CircuitSetup/Remote/README.md

# Remote Control (Delorean Time Machine)

This [repository](https://github.com/CircuitSetup/Remote) _really_ holds the most current firmware for CircuitSetup's [Futaba remote control kit](https://circuitsetup.us/product/futaba-remote-stanley-display-wireless-control-kit/), meant mainly for use in combination with a CircuitSetup [Time Circuits Display](https://circuitsetup.us/product/complete-time-circuits-display-kit/) with a speedo connected to it. Of course, the Remote can also be used stand-alone.

See [here](FUTABA.md) for information on the hardware (parts, disassembly & building instructions).

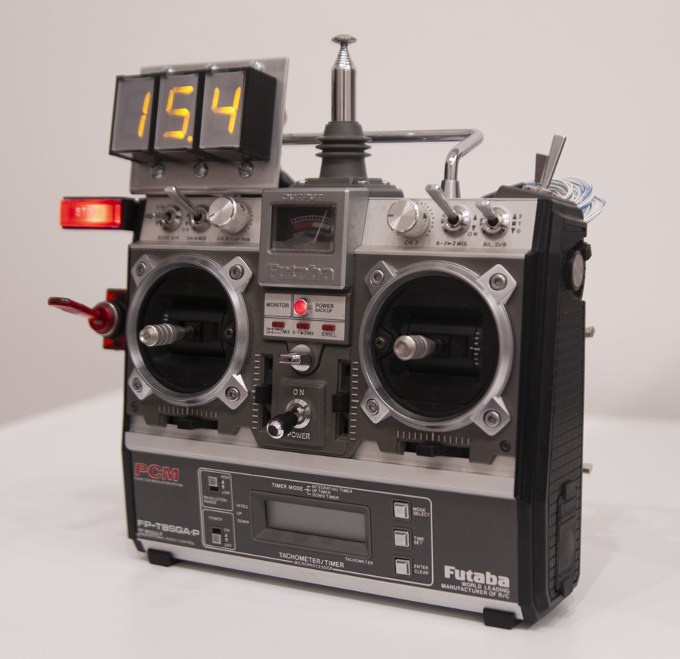
[picture p1: img/myfutaba1.jpg]
My Futaba1

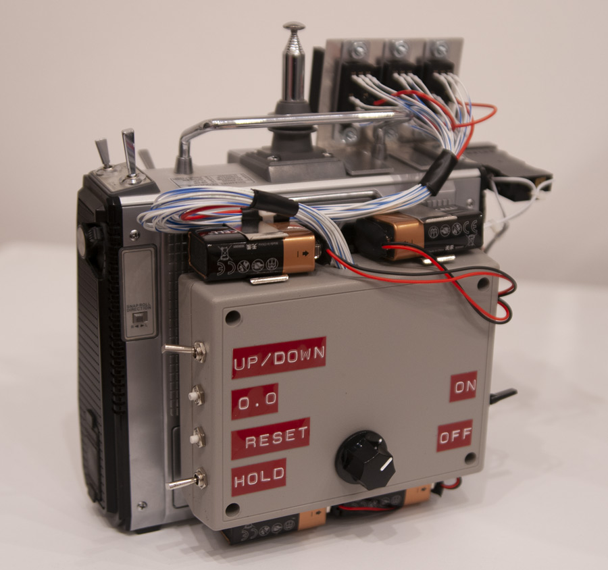
[picture p2: img/myfutaba2.jpg]
My Futaba2


| Watch the video (https://youtu.be/ADWcsmJ4gok) |
|:--:|
| Click to watch the video |

| Watch the video (https://youtu.be/vgmrB-Drxjg) |
|:--:|
| Click to watch the video |

See it controlling the lights and blinds through Home Assistant:

| Watch the video (https://youtu.be/SbuL2Bv5uqA) |
|:--:|
| Click to watch the video |

A video of an early proof-of-concept is [here](https://www.facebook.com/61553801874212/videos/1047035620236271/) (The hardware shown isn't even in prototype stage).

Firmware features:
- [Wireless communication](#connecting-a-time-circuits-display) with [Time Circuits Display](https://circuitsetup.us/product/complete-time-circuits-display-kit/); when (fake) powered up by "ON/OFF" switch, the Remote will take over speed control on the TCD-connected speedo. 
- Elevator stick on actual Futaba remote control used for throttle control, like in the movie. The throttle can increase or decrease speed, in five steps towards each direction. When the speed on the TCD's speedo reaches 88mph, a time travel is triggered.
- Optional [coasting](#-coasting-when-throttle-in-neutral), optional [auto-throttle](#-auto-throttle)
- controlling the Futaba's power LED and battery level meter (static display only, no actual battery level display)
- Movie-accurate "Stop" light and stop switch behavior
- Movie-accurate sound effects
- Eight optional "[User Buttons](#user-buttons)" for playback of user-provided sound effects and/or sending user-configurable [Home Assistant/MQTT](#home-assistant--mqtt) messages
- [Music player](#the-music-player): Play mp3 files located on an SD card, controlled by the _O.O_/_RESET_ buttons or [Time Circuits Display](https://circuitsetup.us/product/complete-time-circuits-display-kit/) keypad via BTTFN
- Advanced network-accessible [Config Portal](#the-config-portal) for setup (http://dtmremote.local)
- Optional [ELRS/CRSF operation](#elrscrsf-settings), with gimbal/switch routing, calibration, curves, travel limits, logical switches, mixes, and telemetry display
- Live ELRS transmitter/receiver controls, verified profile selection, and receiver assignment on the ELRS/CRSF page
- CRSF settings backup/restore, portable model files, and desktop conversion of supported transmitter model exports
- [Home Assistant](#home-assistant--mqtt) (MQTT) support
- Smart battery monitoring for certain LiPo batteries (requires Control Board 1.6M or >= 1.7)
- Built-in OTA installer for firmware updates and custom audio files
- &#128007; &#129370;

>This CircuitSetup fork includes optional [ELRS/CRSF support](#elrscrsf-settings) alongside the movie-prop functions. ELRS/CRSF requires a compatible control board and a firmware build with CRSF support enabled. The original movie-prop firmware is available from [upstream](https://remote.out-a-ti.me).

For information on updating the firmware of your Remote, see [here](#firmware-installation--firmware-update).

## Initial Configuration

**Some key features of your Remote require an SD card.** The first step is therefore to put a **good-quality** ("endurance", "industrial", "long life", ...) **and empty microSD card into the card slot**. The SD card must be inserted before powering up the Remote. It is not recognized if inserted while the Remote is running. Furthermore, do not remove the SD card while the Remote is powered.

>SD/SDHC/SDXC cards up to 32GB are supported. The card needs to be FAT32-formatted (not exFAT). Transcend, Sandisk Ultra and Industrial, Verbatim Premium and Samsung Pro Endurance SDHC cards usually work fine. Some SD cards might not be recognized due to off-specs initialization quirks. SDUC cards are not supported.

The second step is to establish access to the Remote's configuration website ("Config Portal") in order to configure your device:

- Power up your Remote and wait a few seconds.
- Connect your computer or handheld device to the WiFi network "REM-AP".
- Navigate your browser to http://dtmremote.local or http://192.168.4.1 to enter the Config Portal.

### Connecting to a WiFi network

Your Remote knows two ways of WiFi operation: Either it creates its own WiFi network or it connects to a pre-existing WiFi network.

As long as your Remote is unconfigured, it creates its own WiFi network named "REM-AP". This mode of operation is called "**Access point mode**" or **"AP-mode"**. In this mode, computers/handhelds can connect to your Remote in order to access the Config Portal, but ways of communication end right here. There is no inter-prop-communication ([BTTFN](#bttf-network-bttfn)) and no [HA/MQTT](#home-assistant--mqtt).

APmode

It is ok to leave it in AP-mode, predominantly if used stand-alone. To keep operating your Remote in AP-mode, simply _do not configure_ a WiFi network connection as described below.

<details>
<summary>More...</summary>

>Please do not leave computers/handhelds permanently connected to the Remote in AP-mode. These devices might think they are connected to the internet and therefore hammer your Remote with DNS and HTTP requests which might lead to disruptions.

>If you wish for your device to remain in AP-mode, please select a suitable WiFi channel on the Config Portal's "WiFi Configuration" page. See [here](#-wifi-channel).

> In AP-mode, the SID can switch off WiFi to save power. See [here](#wifi-power-saving-features).

</details>

#### Home setup with a pre-existing local WiFi network

In this case, you can connect your Remote to your home WiFi network. This allows for inter-prop-communication ([BTTFN](#bttf-network-bttfn)) and [HA/MQTT](#home-assistant--mqtt).

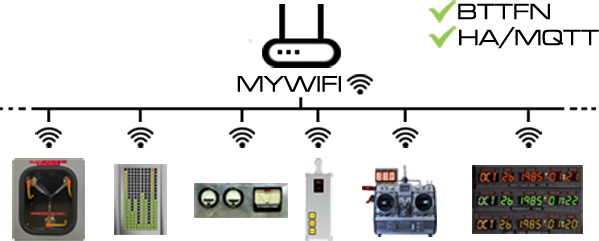
[picture p3: img/stamode-home.png]
STAmode-home


Click on "WiFi Configuration" and either select a network from the top of the page or enter a WiFi network name (SSID), and enter your WiFi password. After saving the WiFi network settings, your Remote reboots and tries to connect to your selected WiFi network. 

<details>
<summary>More...</summary>

>If there are several APs with identical SSID nearby, you can select a specific AP by its BSSID (AP's MAC address). You can either manually find out your AP's BSSID and enter it or have it filled out automatically: Click "Scan for networks", then "Show all". If you click on an AP, its BSSID will be copied into BSSID field in the form below. To see which AP is which, hover over the name to see its BSSID as a tooltip.
  
>Your Remote requests an IP address via DHCP, unless you entered valid data in the fields for static IP addresses (IP, gateway, netmask, DNS). If the device is inaccessible as a result of incorrect static IPs, 
>- power-down the device,
>- press the _Calibration_ button and keep it pressed,
>- power-up the device,
>- wait until the displays shows an animation,
>- press button _O.O_ twice within 10 seconds<!--the display will show "RST" after the second press-->,
>- wait until the display shows "RST",
>- then release the _Calibration_ button.
>
>This procedure causes static IP data to be deleted; the device will return to DHCP.

</details>

If the Remote fails to connect, it falls back to AP-mode. You can trigger another [connection attempt](#-attempt-re-connection-on-fake-power) by fake-powering it down and up.

#### Places without a WiFi network

In this case and with no [Time Circuits Display](https://circuitsetup.us/product/complete-time-circuits-display-kit/) at hand, keep your Remote operating in AP-mode.

If you have a TCD, you can connect your Remote to the TCD's own WiFi network: 

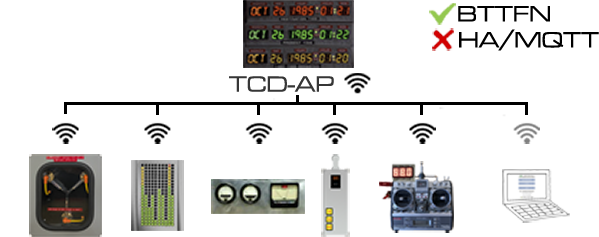
[picture p4: img/stamode-car.png]
STAmode-car


This setup is meant for cars, but suitable for any place with no WiFi network. See [here](#car-setup) for details.

After completing WiFi setup, your Remote is ready for use; you can also continue configuring it to your personal preferences through the Config Portal.

## The Config Portal

The "Config Portal" is the Remote's configuration web site. 

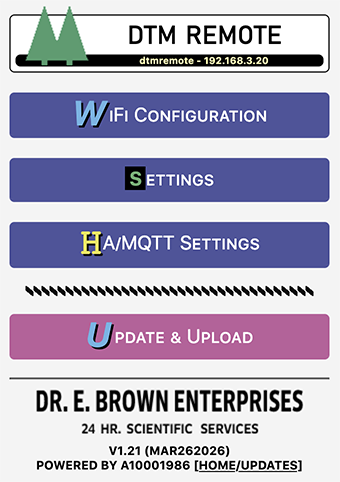
[picture p5: img/cpm.png]
The Config Portal
|  |
|:--:| 
| *The Config Portal's main page* |

It can be accessed as follows:

#### If Remote is in AP mode

- Connect your computer or handheld device to the WiFi network "REM-AP".
- Navigate your browser to http://dtmremote.local or http://192.168.4.1 to enter the Config Portal.
- (For proper operation, please disconnect your computer or handheld from REM-AP when you are done with configuring your Remote. These devices can cause high network traffic, resulting in severe performance penalties.)

#### If Remote is connected to a WiFi network

- Connect your handheld/computer to the same (WiFi) network to which your Remote is connected.
- Navigate your browser to http://dtmremote.local   <details><summary>More...</summary>

  >Accessing the Config Portal through this address requires the operating system of your handheld/computer to support Bonjour/mDNS: Windows 10 version TH2     (1511) [other sources say 1703] and later, Android 13 and later; MacOS and iOS since the dawn of time.

  >If connecting to http://dtmremote.local fails due to a name resolution error, you need to find out the Remote's IP address: Power up and fake-power-up the Remote and hold the _Calibration_ button for 2 seconds. The Remote will display its current IP address (a. - b. - c. - d). Then, on your handheld or computer, navigate to http://a.b.c.d (a.b.c.d being the IP address as displayed on the Remote) in order to enter the Config Portal.</details>

In the main menu, click on "Settings" to configure your Remote. 

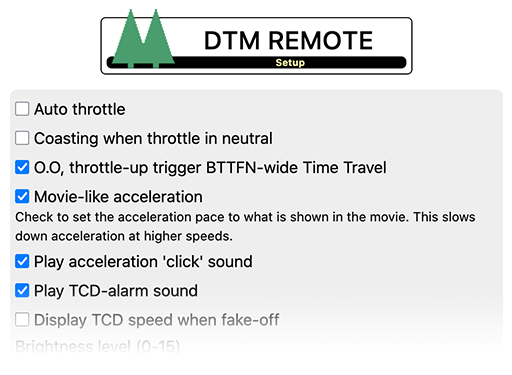
[picture p6: img/cps-frag.png]
| [](img/cp_setup.png) |
|:--:| 
| *Click for full screenshot* |

A full reference of the Config Portal is [here](#appendix-a-the-config-portal).

## Basic Operation

After [calibration](#calibration), your Remote is ready for use. 

If battery monitoring is available, the battery state (in percent; or "FUL") is shown briefly upon (real) power-on.

The Remote can be operated stand-alone, but is really meant to be (wirelessly) connected to a TCD.

After fake-power-on, the Remote's throttle controls the speed displayed on the TCD's Speedo.

For acceleration, there are two modes: Linear mode and "movie mode". In linear mode, acceleration is even over the entire range of 0 to 88mph. In "movie mode", the Remote (mostly) accelerates in the same pace as shown in the movie. In this mode, acceleration becomes slower at higher speeds. The mode can be selected in the Config Portal.

When the remote hits 88.0mph, the TCD triggers a BTFN-wide time travel; all connected props will play a synchronized time travel sequence. If operated stand-alone, a time travel sequence will be played on the Remote.

Auto-throttle: If enabled, acceleration will continue to run after briefly pushing up the throttle stick and releasing it into neutral. Acceleration is stopped when pulling down the throttle stick or when 88mph is reached.

Coasting: If this feature is enabled, the Remote will ever so slightly reduce the current speed when the throttle lever is in neutral. Like a car when you put the transmission in neutral or press the clutch.

All the operation modes described above can also be switched on/off through the [TCD keypad](#tcd-remote-command-reference) or [HA/MQTT](#control-the-remote-via-mqtt).

Buttons and switches:

### "ON/OFF": Fake power

The _ON/OFF_ switch turns the Remote on and off in a sense that it takes over speed control on the TCD when fake-powered on, and hands back speed control when fake-powered off.

_ON/OFF_ must be a maintained contact.

### "Stop"

The _Stop_ switch activates the brakes on your virtual Delorean; if the brakes are on, speed changes on the Remote are not followed by the TCD, instead the TCD will count speed down to 0. Upon releasing the brake, the virtual car accelerates up to the speed shown on the Remote, and will then follow its speed changes.

_Stop_ must be a maintained contact.

### Calibration

<table>
  <tr><td></td><td>Short press</td><td>Hold (2 secs)<br>(double-beep)</td><td>Hold (6 secs)<br>(triple-beep)</td></tr>
  <tr><td>Fake-power off</td><td>Calibrate, see below</td><td>Calibration, see below</td><td>Toggle <a href="#car-setup">Car mode</a></td></tr>
  <tr><td>Fake-power on</td><td>Reset speed to 0</td><td>Display IP address, battery state(*)</td><td>Toggle <a href="#car-setup">Car mode</a></td></tr>
</table>

(* Board version 1.6M or >= 1.7 required; LiPo battery must be properly connected to battery monitor input; battery charge percentage and time-to-empty shown alternately)

The throttle of the Remote needs calibration:

- Put the _ON/OFF_ switch in "OFF" position.
- Put the throttle lever in neutral (center) position, press the _Calibration_ button. The display will briefly show "CAL" to show acceptance.
- Hold the _Calibration_ button for >= 2 seconds until a double-beep is emitted, then release the button. Shortly after, "UP" will be displayed. Now push the throttle to the up-most position and press the _Calibration_ button. "DN" will be displayed.
- Pull the throttle lever to the bottom-most position and press the _Calibration_ button. The display will clear, calibration is finished.

If you change power-source (ie a new battery or power via USB to the ESP32), re-calibration is required.
 
The _Calibration_ button needs to be a momentary contact.

### Buttons "O.O" and "RESET"

When fake power is on:
<table>
  <tr><td></td><td>Short press</td><td>Long press</td></tr>
  <tr><td>Button <i>O.O</i></td><td>Prepare TT<br>or<br><a href="#the-music-player">Music Player</a>: Previous track<br>(depending on <a href="#-pressing-oo-when-fake-power-on">configuration</a>)</td><td><a href="#the-music-player">Music Player</a>: Play/Stop</td></tr>
  <tr><td>Button <i>RESET</i></td><td><a href="#the-music-player">Music Player</a>: Next track</td><td>Toggle Auto-Throttle<br>or<br><a href="#the-music-player">Music Player</a>: Toggle Shuffle<br>(depending on <a href="#-holding-reset-when-fake-power-on">configuration</a>)</td></tr>
</table>

When fake power is off, the buttons are used to set up audio volume and display brightness:
<table>
  <tr><td></td><td>Short press</td><td>Long press</td></tr>
  <tr><td>Button <i>O.O</i></td><td>Volume up</td><td>Brightness up<br>or<br>Take over TCD Fake-Power control<br>(depending on <a href="#-holding-ooreset-when-fake-power-off">configuration</a>)</td></tr>
  <tr><td>Button <i>RESET</i></td><td>Volume down</td><td>Brightness down<br>or<br>Release TCD Fake-Power control</td></tr>
</table>

[Here](https://github.com/realA10001986/Remote/blob/main/CheatSheet.pdf) is a cheat sheet for printing or screen-use.

### User Buttons

These buttons are entirely optional. You can install up to 8 buttons, they only serve the purpose of playing back user-provided sound effects and/or send user-configurable messages to an [MQTT](#home-assistant--mqtt) broker.

Sound playback is mapped as follows:

<table>
  <tr><td></td><td>Short press</td><td>Long press</td></tr>
  <tr><td>Button 1</td><td>Play "<a href="#additional-custom-sounds">key1.mp3</a>"</td><td>Play "<a href="#additional-custom-sounds">key1l.mp3</a>"</td></tr>
  <tr><td>Button 2</td><td>Play "<a href="#additional-custom-sounds">key2.mp3</a>"</td><td>Play "<a href="#additional-custom-sounds">key2l.mp3</a>"</td></tr>
  <tr><td>Button 3</td><td>Play "<a href="#additional-custom-sounds">key3.mp3</a>"</td><td>Play "<a href="#additional-custom-sounds">key3l.mp3</a>"</td></tr>
  <tr><td>Button 4</td><td>Play "<a href="#additional-custom-sounds">key4.mp3</a>"</td><td>Play "<a href="#additional-custom-sounds">key4l.mp3</a>"</td></tr>
  <tr><td>Button 5</td><td>Play "<a href="#additional-custom-sounds">key5.mp3</a>"</td><td>Play "<a href="#additional-custom-sounds">key5l.mp3</a>"</td></tr>
  <tr><td>Button 6</td><td>Play "<a href="#additional-custom-sounds">key6.mp3</a>"</td><td>Play "<a href="#additional-custom-sounds">key6l.mp3</a>"</td></tr>
  <tr><td>Button 7</td><td>Play "<a href="#additional-custom-sounds">key7.mp3</a>"</td><td>Play "<a href="#additional-custom-sounds">key7l.mp3</a>"</td></tr>
  <tr><td>Button 8</td><td>Play "<a href="#additional-custom-sounds">key8.mp3</a>"</td><td>Play "<a href="#additional-custom-sounds">key8l.mp3</a>"</td></tr>
</table>

If a "button" is configured as a maintained switch in the Config Portal, keyX will be played on every flip (ON->OFF, OFF->ON) by default. If the option **_Maintained: Audio on ON only_** is checked for a switch, keyX will only be played when the switch is brought into ON position. This is especially useful for three-position switches where each of the "ON" positions is wired to a different "Button" on the Control Board. Note that maintained switches cannot trigger play-back of keyXl.

If the button/switch is pressed/flipped while audio from a previous press/flip of the same button/switch is still playing, play-back will be stopped.
 
## Sound Customization

### Sound substitution

The Remote's built-in sound effects can be substituted by your own sound files stored on the SD card. These files will be played back directly from the SD card during operation, so the SD card has to remain in the slot.

Your replacements need to be put in the root (top-most) directory of the SD card, be in mp3 format (128kbps max) and named as follows:
- "poweron.mp3": Played when the Remote is (fake)-powered on.
- "brakeon.mp3": Played when the brake is switched on (= when the "Stop" light is switched on).
- "alarm.mp3". Played when the alarm sounds (triggered by a Time Circuits Display via BTTFN or MQTT);

### Additional Custom Sounds

The firmware supports some additional user-provided sound effects, which it will load from the SD card. If the respective file is present, it will be used. If that file is absent, no sound will be played.

- "poweroff.mp3": Played when the Remote is (fake)-powered off.
- "brakeoff.mp3": Played when the brake is switched off.
- "key1.mp3" - "key9.mp3": Will be played upon pressing the respective [button](#user-buttons) (except key9), and commands from the [TCD's keypad](#tcd-remote-command-reference) or [HA/MQTT](#control-the-remote-via-mqtt)
- "key1l.mp3" - "key9l.mp3": Will be played upon long-pressing the respective [button](#user-buttons) (except key9). Naturally, this only works for momentary buttons, not maintained switches. Those sounds also play on commands from the [TCD's keypad](#tcd-remote-command-reference) or [HA/MQTT](#control-the-remote-via-mqtt).

Those files are not provided here. You can use any mp3, with a bitrate of 128kpbs or less.

### Installing Custom & Replacement Audio Files

Replacements and custom sounds can either be uploaded through the Config Portal or copied to the SD card’s root folder using a computer.

Uploading through the Config Portal works exactly like [installing the sound-pack](#sound-pack-installation); on the main menu, click "Update & Upload". Afterwards choose one or more mp3 files to upload using the bottom file selector, and click "UPLOAD". The firmware will store the uploaded mp3 files on the SD card.

To delete a file from the SD card, upload a file whose name is prefixed with "delete-". For example: To delete "key3.mp3" from the SD card, upload a file named "delete-key3.mp3"; the file's contents does not matter, so it's easiest to use a newly created empty file. The firmware detects the "delete-" part and, instead of storing the uploaded file, it throws it away and deletes "key3.mp3" from the SD card.

For technical reasons, the Remote must reboot after mp3 files are uploaded in this way.

The maximum bitrate for mp3 files is 128kbps. 

The uploaded files are stored to the root folder of the SD card, so this way of uploading cannot be used to upload music files for the Music Player. 

## The Music Player

The firmware contains a simple music player to play mp3 files located on the SD card. 

> [!NOTE]
> The maximum mp3 bitrate is __128kpbs__. The free [Adapter&#10548;](https://macroplant.com/adapter/audio-converter) tool can re-encode your mp3 files in batches.

To be recognized, your mp3 files need to be organized in music folders named *music0* through *music9*. The folder number is 0 by default, i.e. the player starts searching for music in folder *music0*. The folder number can be changed in the Config Portal ("Settings") or through the TCD keypad (```705x```) or HA/MQTT (```MP_FOLDER_x```).

The names of the audio files must only consist of three-digit numbers, starting at 000.mp3, in consecutive order. No numbers should be left out. Each folder can hold up to 1000 files (000.mp3-999.mp3). 

Since manually renaming mp3 files is somewhat cumbersome, the firmware can do this for you: Just copy your files with their original filenames to a music folder of your choice; when selecting that folder, the files will be sorted alphabetically and renamed according to the 3-digit name scheme. (If you want your tracks in a specific order, you must rename them, for instance by inserting a letter or number at the start.) The renaming process can take a while (11 minutes for 1000 files in bad cases). Mac users are advised to delete the ._ files from the SD before putting it back into the Remote as this speeds up the process. While the renaming is in progress, the Remote's display shows how many files are still left to be processed.

To add files to a music folder later, just copy them to the folder and delete the corresponding cache file "musicXc" (X being the folder number) located in the top-most folder. That way that the firmware knows that something has changed and will re-examine the folder. 

To start and stop music playback, hold _O.O_ for 2 seconds. Briefly pressing _O.O_ jumps to the previous track, pressing _RESET_ to the next one. (The same can be achieved by entering codes on the TCD's keypad: ```7002``` = previous track, ```7005``` = play/stop, ```7008``` = next track).

By default, the tracks are played in order, starting at 000.mp3, followed by 001.mp3 and so on. Holding _RESET_ toggles Shuffle mode. Shuffle mode is saved and persistent across reboots.

See [here](#buttons-oo-and-reset) and [here](#tcd-remote-command-reference) for a list of controls of the music player.

While the music player is playing music, other sound effects might be disabled/muted. The TCD-triggered alarm will, if so configured, interrupt the music player.

## Battery Monitoring

If a suitable control board is in use, and battery warnings are enabled in the Config Portal, battery state can be monitored, and a warning is issued when the battery is low.

Monitoring works through the [_Calibration_ button](#calibration) and the TCD (```7091```/```7092```).

The "low battery" warning is given as follows:

- A sound is played once
- If the Futaba's battery level meter is connected and enabled, it is switched off (= it reads 0).
- If the Futaba's original power LED is connected and enabled, it blinks.
- If the power LED is disabled, depending on fake power, either "BAT" is displayed periodically or the display blinks periodically.

## Connecting a Time Circuits Display

The TCD communicates with the Remote wirelessly, via the built-in "**B**asic-**T**elematics-**T**ransmission-**F**ramework" (BTTFN) over WiFi. A wired connection is not supported.

The actual remote controlling is done wirelessly, and the TCD's keypad can be used to remote-control the Remote (to control the Music Player, for instance).

| Watch the video (https://youtu.be/u9oTVXUIOXA) |
|:--:|
| Click to watch the video |

BTTFN requires the props all to be connected to the same network, such as, for example, your home WiFi network, or the TCD acting as access point. BTTFN does not work over the Internet.

STAmode-home

<p>&nbsp;</p>

STAmode-car

<details>
<summary>More...</summary>

>The term "WiFi network" is used for both "WiFi network" and "ip subnet" here for simplicity reasons. However, for BTTFN communication, the devices must be on the same IP subnet, regardless of how they take part in it: They can be connected to different WiFi networks, if those WiFi networks are part of the same ip subnet.

</details>

To connect your Remote to the TCD, just enter the TCD's hostname - usually "timecircuits" - in the **_Hostname of TCD_** field in the Remote's Config Portal. On the TCD, no special configuration is required apart from permitting remote control through keypad command 993.
  
Afterwards, the Remote and the TCD can communicate wirelessly and 
- the TCD's speed control is done by the Remote,
- the Remote can switch [Fake-Power on the TCD](#controlling-tcd-fake-power),
- both play an alarm-sequence when the TCD's alarm occurs (if so configured),
- the Remote can be remote controlled through the TCD's keypad (command codes ```7xxx```; see below),
- the Remote can - while fake powered off - display the TCD's speed (eg from GPS).

### TCD remote command reference

<table>
   <tr><td align="center">Function</td><td align="center">Code on TCD</td></tr>
    <tr>
     <td align="left">Toggle "<a href="#-movie-like-acceleration">movie mode</a>"</td>
     <td align="left"<td><code>7060</code></td>
    </tr>
   <tr>
     <td align="left">Toggle <a href="#-display-tcd-speed-when-fake-off">display of TCD speed while off</a></td>
     <td align="left"<td><code>7061</code></td>
    </tr>
   <tr>
     <td align="left">Toggle <a href="#-auto-throttle">auto-throttle</a></td>
     <td align="left"<td><code>7062</code></td>
    </tr>
  <tr>
     <td align="left">Toggle <a href="#-coasting-when-throttle-in-neutral">coasting</a></td>
     <td align="left"<td><code>7063</code></td>
    </tr>
    <tr>
     <td align="left">Set volume level (00-20)</td>
     <td align="left"><code>7300</code> - <code>7320</code></td>
    </tr>
  <tr>
     <td align="left">Enable / disable click sound</td>
     <td align="left"><code>7350</code> / <code>7351</code></td>
    </tr>
    <tr>
     <td align="left">Set brightness level (00-15)</td>
     <td align="left"<td><code>7400</code> - <code>7415</code></td>
    </tr>
    <tr>
     <td align="left"><a href="#the-music-player">Music Player</a>: Play/Stop</td>
     <td align="left"><code>7005</code></td>
    </tr>
    <tr>
     <td align="left"><a href="#the-music-player">Music Player</a>: Previous track</td>
     <td align="left"><code>7002</code></td>
    </tr>
    <tr>
     <td align="left"><a href="#the-music-player">Music Player</a>: Next track</td>
     <td align="left"><code>7008</code></td>
    </tr>
    <tr>
     <td align="left"><a href="#the-music-player">Music Player</a>: Select music folder (0-9)</td>
     <td align="left"><code>7050</code> - <code>7059</code></td>
    </tr>
    <tr>
     <td align="left"><a href="#the-music-player">Music Player</a>: Shuffle off</td>
     <td align="left"><code>7222</code></td>
    </tr>
    <tr>
     <td align="left"><a href="#the-music-player">Music Player</a>: Shuffle on</td>
     <td align="left"><code>7555</code></td>
    </tr> 
    <tr>
     <td align="left"><a href="#the-music-player">Music Player</a>: Go to track 0</td>
     <td align="left"><code>7888</code></td>
    </tr>
    <tr>
     <td align="left"><a href="#the-music-player">Music Player</a>: Go to track xxx</td>
     <td align="left"><code>7888xxx</code></td>
    </tr>
    <tr>
     <td align="left">Play "<a href="#additional-custom-sounds">key1.mp3</a>"</td>
     <td align="left"><code>7501</code> / <code>7001</code></td>
    </tr>
    <tr>
     <td align="left">Play "<a href="#additional-custom-sounds">key2.mp3</a>"</td>
     <td align="left"><code>7502</code></td>
    </tr>
    <tr>
     <td align="left">Play "<a href="#additional-custom-sounds">key3.mp3</a>"</td>
     <td align="left"><code>7503</code> / <code>7003</code></td>
    </tr>
    <tr>
     <td align="left">Play "<a href="#additional-custom-sounds">key4.mp3</a>"</td>
     <td align="left"><code>7504</code> / <code>7004</code></td>
    </tr>
    <tr>
     <td align="left">Play "<a href="#additional-custom-sounds">key5.mp3</a>"</td>
     <td align="left"><code>7505</code></td>
    </tr>
    <tr>
     <td align="left">Play "<a href="#additional-custom-sounds">key6.mp3</a>"</td>
     <td align="left"><code>7506</code> / <code>7006</code></td>
    </tr>
    <tr>
     <td align="left">Play "<a href="#additional-custom-sounds">key7.mp3</a>"</td>
     <td align="left"><code>7507</code> / <code>7007</code></td>
    </tr>
    <tr>
     <td align="left">Play "<a href="#additional-custom-sounds">key8.mp3</a>"</td>
     <td align="left"><code>7508</code></td>
    </tr>
    <tr>
     <td align="left">Play "<a href="#additional-custom-sounds">key9.mp3</a>"</td>
     <td align="left"><code>7509</code> / <code>7009</code></td>
    </tr>
    <tr>
     <td align="left">Play "<a href="#additional-custom-sounds">keyXl.mp3</a>" (X=1-9)</td>
     <td align="left"><code>7511</code> - <code>7519</code></td>
    </tr>
    <tr>
     <td align="left">Display current IP address</td>
     <td align="left"><code>7090</code></td>
    </tr>   
  <tr>
     <td align="left">Display battery charge percentage<sup>1</sup></td>
     <td align="left"><code>7091</code></td>
    </tr>   
  <tr>
     <td align="left">Display battery "Time to empty"<sup>1</sup></td>
     <td align="left"><code>7092</code></td>
    </tr>   
  <tr>
     <td align="left">Display battery voltage<sup>1</sup></td>
     <td align="left"><code>7093</code></td>
    </tr> 
   <tr>
     <td align="left">Toggle <a href="#controlling-tcd-fake-power">Fake-Power control</a></td>
     <td align="left"><code>7096</code></td>
    </tr>
    <tr>
     <td align="left">Disable <a href="#car-setup">Car mode</a><sup>2</sup></td>
     <td align="left"><code>7990</code></td>
    </tr>
    <tr>
     <td align="left">Enable <a href="#car-setup">Car mode</a><sup>2</sup></td>
     <td align="left"><code>7991</code></td>
    </tr>
    <tr>
     <td align="left">Reboot the device<sup>2</sup></td>
     <td align="left"><code>7064738</code></td>
    </tr>
    <tr>
     <td align="left">Toggle firmware update signals at power-up</td>
     <td align="left"><code>7053281</code></td>
    </tr>
</table>

1: Board 1.6M or >= 1.7 required; if LiPo battery is properly connected to battery monitor.<br>
2: Not supported through HA/MQTT [_INJECT_](#the-inject_x-command) command

[Here](CheatSheet.pdf) is a cheat sheet for printing or screen-use.

### Controlling TCD Fake-Power

The Remote can, if so configured, control Fake-Power of a wirelessly connected Time Circuits Display.

By holding _O.O_ when Fake-Power on the Remote is off, the Remote takes over control of Fake-Power on the TCD. The same can be achieved by entering ```7096``` on the TCD keypad.

From now on, whenever you flip the Fake-Power switch on the Remote, the TCD will follow. 

To release Fake-Power control, hold _RESET_ when Fake-Power on the Remote is off.

If the option "Fake-Power controls TCD Fake-Power" is checked in the Config Portal, the Remote will take over Fake-Power control from the TCD at its startup, ie there is no need to initially press _O.O_.

Remarks:
- Buttons _O.O_/_RESET_ need to configured for this function, see [here](#-holding-ooreset-when-fake-power-off).
- The Remote has the highest Fake-Power priority. The TCD's TFC switch and Fake-Power control through HA/MQTT have lower priority; state changes are tracked but do not become effective until the Remote releases Fake-Power control.

## Home Assistant / MQTT

By means of MQTT, the Remote can
- send pre-programmed messages to pre-programmed topics on User button/switch activation, and
- be remote controlled through commands sent to **bttf/remote/cmd**.

The Remote supports MQTT protocol versions 3.1.1 and 5.0.

### Send messages through User Buttons

In the Config Portal, you can configure MQTT topics and messages for "on" and/or "off" for each of the eight User buttons/switches. This allows for arbitrary functions in your Home Assistant/MQTT realm. You could switch HA-integrated lights on or off or send ```TIMETRAVEL``` to your [Time Circuits Display](https://tcd.out-a-ti.me) (bttf/tcd/cmd) or ```REFILL``` to your [Dash Gauges](https://dg.out-a-ti.me) (bttf/dg/cmd).

The "on" message will be sent when a button has been pressed, the "off" message when it has been released. In case of a button being configured as a maintained switch in the Config Portal, the "on" message will be sent when the switch is closed, the "off" message when it is opened.

For a video how this works, see [here](https://youtu.be/SbuL2Bv5uqA?si=R54H7ocUr2Q1ZDAc).

### Control the Remote via MQTT

The Remote can be controlled through messages sent to topic **bttf/remote/cmd**. Supported commands are
- ```AUTOTHROTTLE_ON```, ```AUTOTHROTTLE_OFF```: Enable/disable [auto-throttle](#-auto-throttle)
- ```COASTING_ON```, ```COASTING_OFF```: Enable/disable [coasting](#-coasting-when-throttle-in-neutral)
- ```MOVIEACCEL_ON```, ```MOVIEACCEL_OFF```: Switch between movie and linear [acceleration](#-movie-like-acceleration)
- ```DISPTCDSPD_ON```, ```DISPTCDSPD_OFF```: Enable/disable [speed display while fake-off](#-display-tcd-speed-when-fake-off)
- ```MP_PLAY```: Starts the [Music Player](#the-music-player)
- ```MP_STOP```: Stops the [Music Player](#the-music-player)
- ```MP_NEXT```: Jump to next track
- ```MP_PREV```: Jump to previous track
- ```MP_SHUFFLE_ON```: Enables shuffle mode in [Music Player](#the-music-player)
- ```MP_SHUFFLE_OFF```: Disables shuffle mode in [Music Player](#the-music-player)
- ```MP_FOLDER_x```: x being 0-9, set folder number for [Music Player](#the-music-player)
- ```VOLUME_UP```, ```VOLUME_DOWN```: Increase/decrease volume by a notch
- ```VOLUME_SET_x```: Set volume to x% (x=0-100)
- ```PLAYKEY_x```: Play keyX.mp3 (from SD card), X being in the range from 1 to 9.
- ```PLAYKEY_xL```: Play keyXl.mp3 (from SD card), X being in the range from 1 to 9.
- ```STOPKEY```: Stop playback of keyX file. Does nothing if no keyX file is currently played back.
- ```INJECT_x```: See immediately below.

#### The INJECT_x command

This command allows remote control of the Remote through HA/MQTT in the same way as through the TCD keypad by injecting commands in the Remote's command queue (hence the name). Commands are listed [here](#tcd-remote-command-reference); nearly all are supported. 

To toggle movie/linear mode (```7060```), issue the following command: ```INJECT_7060```

To play "key2.mp3" (```7502```), issue ```INJECT_7502```

To select the 'music1' folder (```7051```), issue ```INJECT_7051```

### Setup

MQTT requires a "broker" such as [mosquitto](https://mosquitto.org/), [Cassandana](https://github.com/mtsoleimani/cassandana), [RabbitMQ](https://www.rabbitmq.com/), [Ejjaberd](https://www.ejabberd.im/), [HiveMQ](https://www.hivemq.com/) or [EMQX](https://www.emqx.com/), to name a few. For proper operation with low latency, running the broker on your local network is recommended.

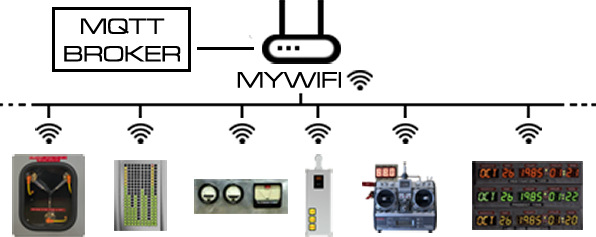
[picture p7: img/stamode-mqtt.png]
STAmode-mqtt


The broker's address needs to be configured in the Config Portal. It can be specified by either domain or IP (IP preferred). The default port is 1883. If a different port is to be used, append a ":" followed by the port number to the domain/IP, such as "192.168.1.5:1884". 

If your broker supports protocol version 3.1.1, stick with 3.1.1. Version 5.0 has no advantages, but more overhead.

If your broker does not allow anonymous logins, a username and password can be specified.

Limitations: TLS/SSL not supported; ".local" domains (MDNS, Bonjour) not supported; the machine running the broker must respond to PING (ICMP) echo requests. MQTT is disabled when the Remote is operated in AP-mode or when connected to the TCD run in AP-Mode (TCD-AP).

## Car Setup

If your [Time Circuits Display](https://tcd.out-a-ti.me/) is mounted in a car or other places without a local WiFi network, the following network configuration is recommended:

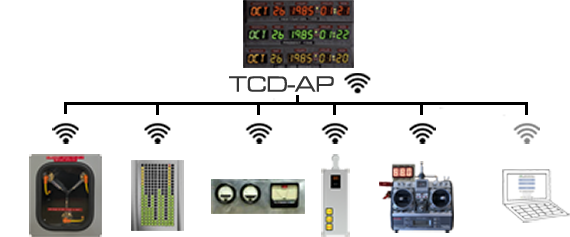
[picture p8: img/stamode-car2.png]
STAmode-car


This configuration can easily be achieved by putting both the TCD and the Remote in *Car Mode*:

#### TCD

- Set **_Power save timer_** to 0 (zero) in the "AP-mode settings" section on the *WiFi Configuration* page
- Put your TCD in [*Car Mode*](https://tcd.out-a-ti.me/#car-mode) by issuing keypad command ```991```.

#### Remote

One-time configuration steps:
- Enter the Config Portal on the Remote, click on *Settings* and check that the hostname of the TCD (usually "timecircuits") is present in the  **_Hostname of TCD_** under *Wireless communication (BTTF-Network)* settings.
- Furthermore, on the *WiFi Configuration* page, check that the TCD's WiFi network name (SSID; usually "TCD-AP") and password (if the TCD is configured with a password) are present under *Car mode settings*.

If everything is in place, you can enable Car mode on the Remote by holding the _Calibration_ button for 6 seconds (until a triple-beep is emitted). The Remote will reboot and attempt to connect to the TCD's AP.

You can switch between your "normal" (home, iPhone, ..) WiFi connection and Car mode by holding the _Calibration_ button for 6 seconds. This works in both fake-power on and off states.

To access the Remote's Config Portal in Car mode, connect your handheld or computer to the TCD's WiFi network ("TCD-AP"), and direct your browser to http://dtmremote.local.

  ><details><summary>If that fails...</summary>
  >If connecting to http://dtmremote.local fails due to a name resolution error, go to the TCD's keypad menu, navigate to "BTTFN CLIENTS", and look for the Remote's IP address there; then direct your browser to that IP by using the URL http://a.b.c.d (a-d being the IP address displayed on the TCD display)</details>

## WiFi Power Saving Features

In AP-mode (ie when the device acts as an access point), WiFi can [only be used for the Config Portal](#connecting-to-a-wifi-network). Since changing settings in the Config Portal isn't something done on a regular basis, the Remote can switch off WiFi in AP-mode after a configurable period of time in order to save battery power.

To enable this power-saving feature, navigate to the "WiFi Configuration" page and enter into the field **_Power save timer_** in the "Settings for AP-mode" section the number of minutes that need to elapse from (real-)power-on until WiFi is supposed to be switched off. Anything between 10 and 99 minutes is allowed. Entering 0 disables this feature.

After WiFi has been switched off due to timer expiration, and the option **_Re-enable WiFi on Fake Power_** is checked, WiFi will be re-enabled on fake-power-up, and the timer is restarted (ie WiFi is again switched off after timer expiration).

>If the Remote ended up in AP-mode because the configured WiFi network wasn't reachable on (real-)power up, and the option **_Attempt re-connection on Fake Power_** is checked, the Remote will attempt to connect to the WiFi network on fake-power-on (and, as usual, fall back to AP-mode on failure; the timer is, of course, restarted in that case).

## Firmware Installation / Firmware Update

The firmware consists of two parts: The main firmware, and a sound-pack.

First, download main firmware and sound-pack. Both files are in every [Release package](https://github.com/realA10001986/Remote/releases/latest), and named
- "**remote-A10001986-Vx.xx.bin**" for A10001986 releases, "**Remote_vX.YY.bin**" for CircuitSetup releases
- "**sound-pack-rmXX.zip**" for A10001986 releases, "**REMA.bin**" for CircuitSetup releases.

### Main firmware

To update the main firmware of your Remote, 
- enter the [Config Portal](#the-config-portal),
- click on "Update & Upload",
- select the downloaded main firmware file in the _top_ file selector, and
- click on *Update*.
  
<details>
<summary>Installing on a fresh ESP32...</summary>
If you are using a fresh ESP32, please go <a href="https://install.out-a-ti.me">here</a> and follow the instructions, or - if you are a nerd and want to deal with source code, compilers'n'stuff - see <a href="https://github.com/realA10001986/Remote/blob/main/remote-A10001986/remote-A10001986.ino">remote-A10001986.ino</a> for detailed build and upload information.
</details>

### Sound-pack installation

After updating the main firmware, there will be a notification on the Config Portal (and the Remote will briefly display "INS"-"SND"-"PCK" at startup) when/if the sound-pack also needs to be updated. 

_Installing the sound-pack requires an [SD card](#initial-configuration)._

To update the sound-pack of your Remote, 
- (if the sound-pack is a zip file, extract it. It contains one file named REMA.bin)
- enter the [Config Portal](#the-config-portal),
- click on "Update & Upload",
- select the REMA.bin file in the _bottom_ file selector, and
- click on *Upload*. 

<details>
<summary>Alternative way</summary>
<br>
Alternatively, you can install the sound-pack the following way:
<ul>
<li>Using a computer, copy "REMA.bin" to the root directory of a FAT32 formatted SD card;</li>
<li>power down the Remote,</li>
<li>insert this SD card into the slot and</li>
<li>power up the Remote; the sound-pack will be installed automatically.</li>
</ul>
</details>

<!--
## Factory Reset

To reset your Remote to factory default settings, 
- power-down the device,
- press the _Calibration_ button and keep it pressed,
- power-up the device,
- wait until the display shows an animation,
- press the _RESET_ button five times within 10 seconds (the display will show "FAC" after the fifth press),
- then release the _Calibration_ button.

This clears all settings to their defaults except
- battery settings,
- Futaba switch type settings.

Since any configured WiFi connection is deleted as well, the Remote will reboot in AP-Mode.

-->

---

## Appendix A: The Config Portal

### Main page

##### &#9193; WiFi Configuration

This leads to the [WiFi configuration page](#wifi-configuration)

##### &#9193; Settings

This leads to the [Settings page](#settings).

##### &#9193; HA/MQTT Settings

This leads to the [HomeAssistant/MQTT Settings page](#hamqtt-settings).

##### &#9193; ELRS/CRSF Settings

This leads to the [ELRS/CRSF Settings page](#elrscrsf-settings), including live radio controls and CRSF settings files. It is available on compatible hardware with a CRSF-enabled build.

##### &#9193; Update & Upload

This leads to the firmware update and audio upload page.

See [here](#firmware-installation--firmware-update) for firmware update instructions.

This page is also for uploading [custom or replacement sound files](#installing-custom--replacement-audio-files) to the SD card:
- Select one or more mp3 file(s) in the _bottom_ file selector (max 16 files at a time) and
- click *Upload*.

---

### WiFi Configuration

Through this page you can either connect your Remote to your local WiFi network or configure AP mode. 

#### <ins>Connecting to an existing WiFi network</ins>

To connect your Remote to your WiFi network, all you need to do is either to click on one of the networks listed at the top or to enter a __Network name (SSID)__, and optionally a __password__ (WPAx). If there is no list displayed, click on "Scan for Networks".

>By default, the Remote requests an IP address via DHCP. However, you can also configure a static IP for the Remote by entering the IP, netmask, gateway and DNS server. All four fields must be filled for a valid static IP configuration. If you want to stick to DHCP, leave those four fields empty.

If there are several APs with identical SSID nearby, the Remote will connect to the first one found, which might not be the one with the strongest signal. It is therefore recommended to select the nearest/strongest AP by its BSSID (AP's MAC address, a unique identifier for a specific AP). You can either manually find out your AP's BSSID and enter it or have it filled out automatically: Click "Scan for networks", then "Show all". If you click on an AP, its BSSID will be copied into BSSID field in the form below. To see which AP is which, hover over the name to see its BSSID as a tooltip.

If the WiFi network the Remote is supposed to connect to wasn't reachable when the Remote was powered up, it will run in AP mode. You can trigger a re-connection attempt by fake-powering it down and up. This technique is also used for WiFi power-saving in AP-mode, see [here](#wifi-power-saving-features).

##### &#9193; Forget Saved WiFi Network

Clicking this button (and selecting "yes" in the confirmation dialog) deletes the currently saved WiFi network (SSID and password as well as static IP data) and reboots the device; it will restart in "access point" (AP) mode. See [here](#connecting-to-a-wifi-network).

##### &#9193; Car mode settings

In Car mode, the device connects to the TCD-AP as configured here instead of the WiFi network configured above. 

Enter your TCD's network name (usually "TCD-AP") in **_Network name (SSID) of TCD-AP_** and the TCD's AP password (if configured on the TCD) in **_Password for TCD-AP_**. 

The **_TCD-AP BSSID_** field is optional for you to fill out. The TCD displays its BSSID (unique access point identifier) on its *WiFi Configuration* page, so you could copy it into this field on your Remote. If the _TCD-AP BSSID_ field is left empty, it will be filled out automatically upon the first successful connection to your TCD in Car Mode. This pairs your Remote to your TCD and avoids connecting to other people's TCDs at meet-ups with other cars nearby.
> If you ever need to connect your Remote to a different TCD (or, for instance, swap out your TCD's circuit board), this field needs to be cleared in order to pair your Remote to the new TCD. Note that if the Remote fails to connect to a BSSID-identified TCD, it will boot into [AP-Mode](#connecting-to-a-wifi-network) ("REM-AP").

If you want to enter Car mode immediately after saving your settings, check **_Enable car mode now_**. You can also later toggle between Car mode and normal WiFi connection by holding the _Calibration_ button for 6 seconds (until a triple-beep is emitted).

##### &#9193; Hostname

The device's hostname in the WiFi network. Defaults to 'dtmremote'. This also is the domain name at which the Config Portal is accessible from a browser in the same local network. The URL of the Config Portal then is http://<i>hostname</i>.local (the default is http://dtmremote.local)

If you have more than one Remote in your local network, please give them unique hostnames.

_This setting applies to both AP-mode and when your Remote is connected to a WiFi network._ 

##### &#9193; WiFi connection attempts

Number of times the firmware tries to reconnect to a WiFi network, before falling back to AP-mode. See [here](#connecting-to-a-wifi-network)

##### &#9193; Attempt re-connection on Fake Power

If the configured WiFi network wasn't reachable during power-up (and the Remote, as a result, fell back to AP-mode), and this option is checked, the Remote will re-try to connect to the configured WiFi network upon Fake-Power-On. If this option is unchecked, no connection attempts are made, the Remote will remain in AP-mode until (real-)powered-down.

#### <ins>Settings for AP-mode</ins>

##### &#9193; Network name (SSID) appendix

By default, when your Remote creates a WiFi network of its own ("AP-mode"), this network is named "REM-AP". In case you have multiple Remotes in your vicinity, you can have a string appended to create a unique network name. If you, for instance, enter "-ABC" here, the WiFi network name will be "REM-AP-ABC". Characters A-Z, a-z, 0-9 and - are allowed.

##### &#9193; Password

By default, and if this field is empty, the Remote's own WiFi network ("REM-AP") will be unprotected. If you want to protect your access point, enter your password here. It needs to be 8 characters in length and only characters A-Z, a-z, 0-9 and - are allowed.

If you forget this password and are thereby locked out of your Remote, 
- power-down the device,
- press the _Calibration_ button and keep it pressed,
- power-up the device,
- wait until the display shows an animation,
- press button _O.O_ twice within 10 seconds<!-- (the display will show "RST" after the second press) -->,
- wait until the display shows "RST",
- then release the _Calibration_ button.

The Remote will boot and start the access point - this once - without a password, thereby giving you an opportunity to connect without a password and to either look up or change said password. When you reboot or power-cycle the Remote, REM-AP will be password protected again.

##### &#9193; WiFi channel

Here you can select one out of 11 channels or have the Remote choose a random channel for you. The default channel is 1. Preferred are channels 1, 6 and 11.

WiFi channel selection is key for a trouble-free operation. Disturbed WiFi communication can lead to disrupted sequences, packet loss, hanging or freezing props, and other problems. A good article on WiFi channel selection is [here](https://community.ui.com/questions/Choosing-the-right-Wifi-Channel-on-2-4Ghz-Why-Conventional-Wisdom-is-Wrong/ea2ffae0-8028-45fb-8fbf-60569c6d026d).

If a WiFi Scan was done (which can be triggered by clicking "Scan for Networks"), 

- a list of networks is displayed at the top of the page; click "Show All" to list all networks including their channel;
- a "proposed channel" is displayed near the "WiFi channel" drop-down, based on a rather simple heuristic. The banner is green when a channel is excellent, grey when it is impeded by overlapping channels, and when that banner is red operation in AP mode is not recommended due to channels all being used.

The channel proposition is based on all WiFi networks found; it does not take non-WiFi equipment (baby monitors, cordless phones, Bluetooth devices, microwave ovens, etc) into account. 

##### &#9193; Power save timer

See [here](#wifi-power-saving-features).

##### &#9193; Re-enable WiFi on Fake Power

If a power save timer is configured and has expired, and this option is checked, the Remote will re-enable WiFi upon Fake-Power-On. If this option is unchecked, WiFi will **not** be re-enabled, it will stay off until (real-)power down. See also [here](#wifi-power-saving-features).

---

### Settings

#### <ins>Basic settings</ins>

##### &#9193; Auto throttle

If this is checked, acceleration is, after being started by pushing the throttle stick up, continued even if the stick is released into neutral. Acceleration is stopped when pulling down the throttle stick or when 88mph is reached.

This setting can quickly be toggled by holding the _RESET_ button, if [so configured](#-holding-reset-when-fake-power-on).

##### &#9193; Coasting when throttle in neutral

Normally, when this is unchecked, keeping the throttle in neutral (center) position holds the current speed. If this option is checked, speed will slowly decrease in neutral, just like a car when the kludge is held down or the gear is in neutral.

##### &#9193; Movie-like acceleration

The Remote knows to modes of acceleration: "Movie mode" and "linear".

In movie mode, acceleration changes with speed. At lower speeds, it is faster, and will gradually become slower as speed increases. The pace matches the movie mostly; unfortunately, the remote is only shown for a very few seconds and timing is inconsistent (to say the least), so some interpolations were required.

In linear mode, the acceleration curve is a straight line, ie the time between each mph is the same.

##### &#9193; Play throttle-up sound on throttle-up

This option selects whether the "throttle up" sound is played only at speed 0, or whenever the throttle lever is moved up from neutral, regardless of current speed.

##### &#9193; Play acceleration 'click' sound

Check this to play a click sound for each "mph" while accelerating. Uncheck to stay mute. Note that the click is only played when accelerating, not with reducing speed.

##### &#9193; Play TCD-alarm sounds

If a TCD is connected via BTTFN or MQTT, the Remote visually signals when the TCD's alarm sounds. If you want to play an alarm sound, check this option.

##### &#9193; Display TCD speed when fake-off

When this is checked, the Remote (when fake-powered off) shows whatever the TCD displays on its speedo. For instance, if your TCD is in a car along with a GPS-equipped speedo, the Remote can show the GPS speed.

#### <ins>Music Player settings</ins>

##### &#9193; Music folder

Selects the current music folder, can be 0 through 9. 

This can also be set/changed through a TCD keypad via BTTFN (```7050``` - ```7059```). Such a change will be saved immediately.

#### <ins>Settings for BTTFN communication</ins>

##### &#9193; Hostname of TCD

To connect your Remote to a Time Circuits Display wirelessly ("BTTF-Network"), enter the TCD's hostname - usually 'timecircuits' - here. Although specifying the TCD's IP address is supported as well, the hostname is preferred because it makes your setup independent of the network environment.

##### &#9193; Remote Fake-Power controls TCD Fake-Power

This selects the power-up behavior of Fake-Power control over the TCD.

If this option is checked, the Remote takes over Fake-Power control from the TCD when booting. If the TCD is powered-up after the Remote, it will recognize the Remote's state and stay silent and dark until the Remote is fake-powered up.

If this option is unchecked, you need to hold _O.O_ to gain Fake-Power control on the TCD, as described [here](#controlling-tcd-fake-power).

##### &#9193; Button to refill Plutonium

Here you can select a user button/switch which, when activated, sends a ```REFILL``` command to the [Dash Gauges](https://dg.out-a-ti.me) through the TCD. This is useful for quickly silencing the Dash Gauges after a Time Travel.

#### <ins>Other settings</ins>

##### &#9193; Save secondary settings on SD

_Please leave this option checked. It is safe to have this option checked even with no SD card present._

If this is checked, some settings are stored on the SD card. This helps to minimize write operations to the internal flash memory and to prolong the lifetime of your Remote. Apart from Flash Wear, there is another reason for using an SD card for settings: The Remote needs to save data from time to time. Writing data to internal flash memory can cause delays of up to 1.5 seconds, which interrupt sound playback and have other undesired effects.

If you want copy settings from one SD card to another, do as follows:
- With the old SD card still in the slot, enter the Config Portal, turn off _Save secondary settings on SD_, and click "SAVE".
- After the Remote has rebooted, power down, and swap the SD card for your new one.
- Power-up the Remote, enter the Config Portal, re-enable _Save secondary settings on SD_, and click "SAVE".

#### <ins>Button assignment settings</ins>

##### &#9193; Holding O.O/RESET when Fake-Power off

This selects what happens when you hold the _O.O_ or _RESET_ button for 2 seconds when Fake-Power is off:

- _adjusts display brightness_: _O.O_ increases display brightness, _RESET_ decreases it.
- _takes/releases control of TCD Fake Power_: _O.O_ takes over [TCD Fake-Power control](#controlling-tcd-fake-power), _RESET_ releases it.

##### &#9193; Pressing O.O when Fake-Power on

This selects what happens when you (briefly) press the _O.O_ button when Fake-Power is on:

- _Plays previous track in Music Player_: As it says, as part of Music Player control, _O.O_ jumps to the previous track.
- _Makes throttle-up trigger a time travel_: Briefly pressing _O.O_ prepares a Time Travel, which is then triggered when pushing the throttle stick upward.

##### &#9193; Holding RESET when Fake-Power on

This selects what happens when you hold the _RESET_ button when Fake-Power is on:

- _toggles shuffle in Music Player_: As it says, as part of Music Player control, it toggles the shuffle setting.
- _toggles auto-throttle_: Holding _RESET_ toggles the [auto-throttle](#-auto-throttle) setting.

#### <ins>Hardware configuration settings</ins>

##### &#9193; Button x is maintained

You might want use one or more switches of the Futaba remote for sound effects and/or MQTT messages. If that switch is a maintained contact, check this option for the respective "button" number. Leave unchecked when using a momentary button.

##### &#9193; Maintained: Play audio on ON only

If this is unchecked, audio is played on every flip (OFF->ON, ON->OFF) of the maintained switch. If checked, keyX is only played when the switch is brought into "on" position. Check this if using three-position switches where both ON positions are wired to different "Buttons" on the Control Board.

##### &#9193; Use Futaba Power LED

This setting is for using the Futaba's original power LED. If this LED isn't connected to the control board, this setting has no effect.

If unchecked, the power LED stays dark, which is the default. If checked, the power LED lights up on either real power or fake power.

##### &#9193; Power LED on fake power

If unchecked, the power LED lights up on real power. If checked, it does so on fake power.

##### &#9193; Use Futaba Battery Level Meter

This setting is for using the Futaba's original battery level meter. If this meter isn't connected to the control board, this setting has no effect.

If unchecked, the level meter stays at zero, which is the default. If checked, the level meter shows a fictitious battery level of around 75%.

Please note that the meter does not show actual battery level; the built-in battery monitor, as described below, only works through the Stanley display.

##### &#9193; Level Meter on fake power

If unchecked, the level meter comes to life on real power. If checked, it does so on fake power.

#### <ins>Battery monitoring</ins>

##### &#9193; Battery monitoring/warnings

Enable or disable battery monitoring and respective warnings. Battery monitoring requires using Control Board versions 1.6M or >= 1.7, plus a properly connected LiPo battery.

If the battery level is lower than 8 percent, a warning is issued. The way it is given depends on hardware and software settings, see [here](#battery-monitoring).

##### &#9193; Battery type

Battery monitoring only works reliably with the LiPo batteries listed. Select the type you are using.

The battery CircuitSetup supplies as part of their kit is of the 3.7/4.2V type.

##### &#9193; Capacity per cell (1000-6000)

Battery monitoring requires knowledge about the cell capacity. Note that the capacity _per cell_ is required to be entered. Most batteries consist of two or more cells; in that case divide the nominal capacity by the number of cells and enter the number here.

The battery CircuitSetup supplies as part of their kit is a dual-cell 5000mAh LiPo battery. The value to enter here is therefore 2500.

---

### ELRS/CRSF Settings

In CircuitSetup's fork, this page is available on compatible control boards when the firmware is built with ELRS/CRSF support. Local input/model settings, live radio controls, and file backup/import are on the same page, using the existing Config Portal layout.

The four gimbals are calibrated and shaped before CRSF transmission: low is `1000`, center is `1500`, and high is `2000` in RC-equivalent microseconds before conversion to CRSF wire ticks. The portal shows filtered ADC readings and lets you capture low, center, and high calibration points. Gimbals and switches can each use CH1-CH16 or None; the available receiver channels depend on the module's RF mode.

Use **Save** at the bottom of the complete page for local model, input, mode, and display changes. Saving restarts the Remote. Live device operations use their own confirmation and readback controls.

##### &#9193; Operation mode

Choose one of three modes, then save and restart:

- **Legacy**: normal prop controls, simulated speed/display, sound effects, and the configured MQTT/BTTFN behavior. No CRSF channel transmission.
- **ELRS/CRSF**: all four gimbals and twelve switch inputs transmit on their assigned CRSF channels, and the display shows radio telemetry. Check **Also trigger Settings action** beside individual switches to additionally run their existing Settings-page behavior. For O.O configured for Time Travel, an enabled checkbox sends the request directly; it does not wait for the prop throttle.
- **Prop controls + ELRS/CRSF**: normal prop controls and the prop speed display run together with all mapped CRSF channels. All prop switches and Settings actions are active; the individual checkboxes do not restrict them. MQTT and BTTFN work as configured under the usual WiFi/network requirements. O.O and Time Travel retain normal prop behavior, including the throttle-up condition.

To use the gimbal as a prop speed control with optional radio output, choose **Prop controls + ELRS/CRSF**. The physical **Throttle** gimbal on ADS1015 **AIN3** accelerates/decelerates the simulated prop speed through the normal auto-throttle/coasting/movie settings. Its CRSF output still follows the **Throttle target channel** selection; moving it from CH3 to another channel does not move the prop speed-control function to another gimbal. Choosing **None** for the Throttle channel disables only its radio output; the physical AIN3 throttle still controls prop speed. The other three gimbals keep their independent CRSF mappings.

Prop throttle calibration and CRSF gimbal calibration serve different purposes. Use the normal [Calibration button procedure](#calibration) to set prop throttle neutral and endpoints, and the portal's **Gimbal Calibration** captures, reversal, curves, and travel limits for the transmitted radio channel. Calibrating one does not replace the other. Select the switch/gimbal channels as usual, ensure they are unique, and configure the module RF packet rate/mode through its live device menu. Save and restart to apply mode and mapping changes.

##### &#9193; Logical Switches and Mixes

The ELRS page provides 16 logical switches (L01-L16) and 16 additional mix lines, using an EdgeTX-style setup. Use **Add logical switch** or **Add mix** to create rows as needed, up to 16 of each. Only populated rows are listed. Select **Edit** to change a row. Changes apply after saving and restarting.

Logical switches support `a>x`, `a<x`, AND, OR, XOR, and an optional **AND switch**. Comparisons use the calibrated, reversed, expo-shaped gimbal value: -100% is 1000, 0% is 1500, and +100% is 2000. Boolean sources include the physical switches and earlier logical switches. `!` means Not. **Delete** removes an unused logical switch; change references in other logical switches and mixes before deleting a switch they use. Source and gate lists offer only populated logical switches. Existing unavailable references remain intact and must be corrected before applying an edited row. Logical IDs stay fixed when rows are added or deleted. Timers and latches are not included in this version.

In **Mixes**, existing channel mappings provide the base assignments. Additional lines choose a **Source**, **Weight**, **Offset**, optional **Switch**, and **Multiplex** operation. Add combines a contribution, Multiply scales previous contributions, and Replace replaces them. Multiple additional lines may share a channel; their displayed order matters. Use **Up/Down** to reorder lines on the same channel, and **Delete** to remove a line. MAX is a constant +100% source. A logical switch used as Source produces -100%/+100%; using it as Switch enables another source. Local Settings actions retain their physical button bindings.

For example, configure L01 as `a<x`, V1=Throttle, V2=-90%; L02 as AND, V1=ButtonPack 1, V2=L01; and an additional CH9 mix with Source=L02, Weight=100%, Offset=0%, Switch=---, Replace. CH9 goes high only when the button is on and throttle is below the threshold. A second mix can reuse the same logical condition.

Gimbal output limits apply after mixing. Missing/stale inputs remain unavailable even when inverted; affected gimbal channels use neutral and other affected channels use low. Calibration and self-test suppress additional mixes. With no additional mixes, existing channel behavior is retained. Saving calibration preserves the logical switches and mixes. ELRS RF mode still determines which channels reach the receiver.

##### &#9193; Connect to WiFi in ELRS/CRSF mode

If checked, the Remote will join the configured WiFi network while operating in ELRS/CRSF mode. If unchecked, it remains in AP mode during ELRS/CRSF operation.

##### &#9193; 88 speed time travel

Enable **Lights and time travel sound at 88**, choose the **Receiver lights channel**, then save and restart. The feature is off by default. It triggers once when the speed sent to the three-digit display rises from below 88 to 88 or higher, including the display's scaling and rounding. GPS/airspeed use the selected speed units and display scaling; RPM sources use actual or scaled mph. In Prop controls + ELRS/CRSF with None selected, it follows the normal prop speed and shares the existing time-travel sound sequence. Non-speed telemetry and unavailable readings cannot trigger it.

The selected channel is high (2000 us) while `timetravel.mp3` is playing, then returns to its assigned physical switch state (or low at 1000 us if unassigned), including if playback stops early. An already-on switch keeps the lights on before and after the sound. A missing or muted sound leaves manual switch control unchanged. Speed must drop below 88 after playback before another trigger. Gimbal and mixer output channels are rejected. Connect the lights through a receiver-controlled switch and use an RF mode that transmits the selected channel. The checkbox and channel are included in model exports and backups; older settings load with the feature disabled.

##### &#9193; 3 digit display

Choose GPS speed, airspeed, vehicle battery voltage/current/remaining charge/capacity, GPS altitude/heading/satellites, receiver uplink LQ/RSSI/SNR, or motor RPM speed. The list offers only valid values received within the last two seconds (six seconds for RPM). A saved or pending source stays selected when unavailable; its readout becomes `---` until fresh telemetry returns. Received zero is a valid value.

**None (normal display)** is the default. In **Prop controls + ELRS/CRSF**, it keeps normal gimbal-controlled prop speed and the connected TCD speedometer. Assigning telemetry replaces the Remote's local normal readout; the gimbal still controls prop/TCD speed independently. In standalone **ELRS/CRSF**, None uses **Auto**, which selects GPS speed, then airspeed, then uplink LQ. Auto uses default scaling. **Off** blanks the normal readout. Calibration, battery warnings, volume/brightness, and time travel messages keep priority.

For an assigned source, output is `value × multiplier + offset`. Speed is converted to the selected km/h or mph units first. Choose source-default precision or 0, 1, or 2 decimal places. For example, speed × `0.5` halves the displayed value; capacity × `0.001` displays Ah instead of mAh. The three digits include the minus sign; overflow shows `HI` or `LO`. Live preview uses pending settings without changing the physical display. Save and restart to apply.

**Motor RPM: Actual mph** and **Motor RPM: Scaled mph** accept RPM from any ELRS serial input that forwards motor RPM telemetry, including CRSF/inverted CRSF, HoTT, Scorpion, SRXL2/Firma Smart, and MAVLink. ELRS converts the serial input to standard CRSF RPM (0x0C) or, for MAVLink, ArduPilot passthrough RPM (0x500A in 0x80 packets); the Remote accepts both. It uses the first RPM reading in the latest packet, regardless of source ID. Extra RPM readings (such as a second motor or maximum RPM) are ignored. Protocols that only output controls, such as SBUS/SUMD, supply no RPM themselves.

Select **Electrical RPM** when pole-count correction is needed, as with Firma Smart: motor RPM is electrical RPM divided by half the motor pole count. Select **Shaft RPM (already corrected)** when the sensor already reports mechanical RPM; the motor-pole field then hides and its saved value is retained. Actual mph uses shaft RPM, total motor-to-wheel reduction, and tire outside diameter. Both RPM sources use mph independently of the GPS/airspeed units setting. Reverse rotation shows speed magnitude. The input type cannot be inferred from a CRSF source ID; choose it to match the sensor's output.

The **Motor RPM speed** fields default to the TT-02R with the Spektrum SPMXSEMC01: **Electrical RPM, 4 poles, 6.55:1 final drive ratio, 64 mm tires**, and **10× scale factor**. They appear only for an RPM display source; the scale factor appears only for Scaled mph. The ratio field also offers **6.16:1** for the kit's 64T spur/27T pinion; enter any custom ratio and tire diameter for other setups. Scaled mph multiplies Actual mph by the scale factor, so 8.8 actual mph displays as 88.0 at 10×. Use the existing Multiplier for calibration (default 1) and Offset 0. Switching sources preserves these settings; pending vehicle edits also update live preview. RPM speed estimates wheel rollout, so wheelspin and tire deformation can differ from ground speed. RPM expires six seconds after the last received reading, allowing HoTT's five-second unchanged-value updates. A receiver may also cache readings before it stops forwarding them; the Firma Smart bridge caches for up to two seconds.

##### &#9193; CRSF channel cadence (restart required)

Selects how often the Remote sends channel frames to the transmitter module: 50, 100, 150, 250, or 500 Hz, with 250 Hz as the default. This is separate from the module's over-the-air RF packet rate, which is selected through the live **Transmitter** section. Save and restart to change the CRSF channel cadence.

##### &#9193; Speed units

Selects whether GPS/airspeed telemetry displays km/h or mph. The motor RPM speed sources always display mph.

Telemetry ratio, maximum power, and dynamic power are changed through the transmitter's advertised fields in **Radio devices**, rather than fixed selectors at the top of the page.

##### &#9193; Aileron/Elevator/Throttle/Rudder target channel

These selectors choose which outgoing CRSF channel carries each gimbal.

By default the mapping is:

- Aileron -> CH1
- Elevator -> CH2
- Throttle -> CH3
- Rudder -> CH4

Choose **CH1** through **CH16**, or **None**, for each gimbal and switch. Assigned channels must be unique across gimbals and switches; any number of inputs may use **None**. None stops that input from driving any radio channel. A channel with no assigned input still transmits the minimum CRSF value (`172`), unless you assign another input to it. Existing default channel assignments are unchanged.

##### &#9193; Switch Local Actions

In **ELRS/CRSF** mode, check **Also trigger Settings action** beside a switch channel to also run that switch's existing behavior from the Settings page. In **Prop controls + ELRS/CRSF**, all normal prop controls are already active regardless of these checkboxes. This reuses the Stop, FakePower, O.O/RESET, and User Buttons behavior, including the configured momentary/maintained switch handling, short/long presses, and maintained-switch audio options. CRSF channel output continues independently. A checked switch also runs its local Settings action when its channel is **None**. In **Prop controls + ELRS/CRSF**, all prop functions remain active even for inputs assigned **None**. All checkboxes default to unchecked. Save the ELRS/CRSF page and restart to apply changes.

In telemetry mode, the **FakePower** checkbox enables TCD power/speed control, including O.O/RESET's configured TCD power-master actions. TCD braking also requires the **Stop** checkbox. With FakePower unchecked, BTTFN uses state-free keepalives; enabled O.O Time Travel and User Button refill requests still work independently. The physical FakePower position still selects the on/off behavior of enabled O.O/RESET and User Button actions.

##### &#9193; Reverse Aileron/Elevator/Throttle/Rudder

Reverses the selected gimbal inside the ELRS/CRSF input model before the CRSF frame is generated.

##### &#9193; Travel Limits

Each gimbal has a **Lower limit** (`1000` through `1500`) and an **Upper limit** (`1500` through `2000`), in the existing RC-equivalent microsecond convention. Center stays at `1500`. Defaults of `1000`/`2000` preserve full travel. The firmware scales each half of the stick movement to the selected limits, then clamps the output before conversion to CRSF ticks; `1200`/`1800`, for example, maps the full stick range to `1200`/`1500`/`1800`. Both limits at `1500` hold the axis at neutral.

Limits follow the physical input when channels are remapped. Reversal changes which stick direction reaches the lower or upper output; the numeric limits stay the same. ADC calibration and live readings remain separate. Fault and self-test outputs stay at neutral, including throttle. Save the page to apply changes after restart. Saving calibration preserves the selected limits. Check receiver travel with the actual servo/linkage to choose safe endpoints.

##### &#9193; ELRS/CRSF Gimbal Calibration

Gimbal ADC inputs use a speed-adaptive filter: steady sticks get stronger smoothing, while faster movement gets less smoothing to reduce delay. The filter uses elapsed sample time and restarts from a fresh reading after stale input or an ADC error. **Jitter tolerance** and **Throttle idle deadband** each accept 0-32 ADC counts and default to 5; 0 disables that adjustment. Jitter tolerance holds an input until its filtered reading changes enough, while calibrated center and endpoint transitions remain reachable. Throttle idle deadband holds the throttle at minimum output near its calibrated idle endpoint, including reversed throttle.

At startup and after calibration, an ADC fault, or stale input, throttle output stays neutral until both the fresh raw and filtered throttle readings reach the saved calibrated center. Move the physical throttle to its calibrated center to unlock it; FakePower off alone does not unlock it. The lock covers the mapped throttle channel and active mixes sourced from throttle. The live safety line reports when throttle output is locked. This lock requires a fresh sample and does not change channel mappings, reversal, calibration points, travel limits, or mix definitions.

This section shows live ADC readings after filtering and jitter tolerance, before throttle idle adjustments, calibration mapping, and output travel limits. Move a gimbal to its low, center, or high position and click the matching *Capture* button. When you save the page, those stabilized ADC counts are stored and used as the three-point calibration before Travel Limits:

- saved low -> `1000`
- saved center -> `1500`
- saved high -> `2000`

Values between the saved points are interpolated, and anything outside the saved range is clamped.

##### &#9193; Live ELRS controls

Open the Remote's configuration portal using its LAN address, hostname, or AP address to use live controls and CRSF settings files without a password. File operations require a current portal session and an exact validated preview before activation. The radio must be active to discover and control devices.

**Transmitter** and **Receiver** list the visible fields and supported commands advertised by each device. Use their **Refresh** buttons to load readback; fields appear as they arrive. Values, units, ranges, and choices come from the device descriptors. Read-only, hidden, unsupported, missing, or unreadable fields cannot be edited. **TX Power** is the configured maximum, and **Dynamic power** retains advertised AUX choices. Packet Rate is the module's over-the-air RF rate; it is separate from the Remote's CRSF channel cadence. See the [ExpressLRS transmitter menu guide](https://www.expresslrs.org/quick-start/transmitters/lua-howto/).

Edit fields, then use **Save Transmitter Settings** or **Save Receiver Settings** once for that section. Setting edits stay staged until saved. Each save confirms the pending changes and applies them sequentially with readback. Dependent fields refresh once after the section is saved. Pending edits are revalidated after our own generation changes; external changes or changed field descriptors require fresh readback. A failed or uncertain write stops the save and requires fresh readback before retrying; any changes already verified remain applied.

**Save All Settings** at the page bottom also saves pending transmitter and receiver changes. It saves the Remote's local settings and restarts only when those local settings changed. Cancelling a radio save or encountering a radio error prevents the local save and restart. A clean page needs no save. Background ADC and telemetry previews pause during radio operations to leave HTTP capacity for setup requests.

Under **Receiver**, **Physical PWM output** loads the output being configured (**Output Ch**); **Incoming RC channel** maps its over-the-air input (**Input Ch**). Save pending receiver edits before selecting another output, or explicitly discard them. Output selection rereads dependent fields. **Capture failsafe positions** stores current positions for all configured PWM outputs and keeps its own confirmation/cancel controls. It does not edit arbitrary failsafe pulse values. See the [ExpressLRS PWM receiver guide](https://www.expresslrs.org/hardware/pwm-receivers/).

Enter **maintenance** for five minutes before sensitive changes. Changes require fresh disarmed RF status, final CH5 low, FakePower off, and no calibration or self-test in progress. Packet Rate and other critical TX settings, TX profile selection, and model-file activation also require RF disconnected. **FakePower off does not disarm the receiver.** Receiver assignment/output operations require the connected receiver to be disarmed. Commands such as Bind remain explicit actions rather than staged settings.

Edit **TX profile ID (0-63)** and use **Save Transmitter Settings** to select and verify that profile. **Assign connected receiver to saved TX profile** is a separate Receiver action; selecting a profile alone does not establish a verified binding.

##### &#9193; CRSF settings files

The page offers three related file workflows:

| File | Purpose | Calibration and radio settings |
|:--|:--|:--|
| `remote.crsf-backup.json` | Back up and restore the Remote's CRSF model, inputs, routing, local switch actions, logical switches/mixes, display, cadence, units, operation mode, and CRSF WiFi preference | Restores the saved input calibration and filtering; radio preferences require separate review |
| `remote.remote-model.json` | Transfer a portable model to another Remote, or import a converted transmitter model | Keeps the destination's ADC calibration and filtering; radio preferences require separate review |
| `*.remote-radio.json` | Capture external transmitter/receiver menu settings with the desktop helper | Requires a separate live preview and verified device writes |

Only the current complete CRSF settings format is loaded; older calibration-only and partial settings files are not migrated. Reconfigure and calibrate CRSF after replacing an older format.

CRSF backup/model files cover CRSF/ELRS settings. WiFi credentials, hostname, MQTT, audio, and other prop settings stay on the destination. External TX/RX configuration is handled by the separate radio snapshot workflow below.

To restore or import a native file:

1. For a portable model, first enable **ELRS/CRSF** or **Prop controls + ELRS/CRSF** and restart. A settings backup must also have a CRSF-enabled operation mode; activation rejects files that would leave Legacy mode selected. Choose the JSON file and its **File type**: Portable model or CRSF settings backup. Each native file is limited to 16 KiB.
2. Click **Validate and preview file** and review the proposed model and calibration changes.
3. Enter maintenance, refresh the required radio status, then confirm **Activate and restart**.
4. After reboot, discover/read the radio and verify the imported profile and radio preferences. The review action refreshes the transmitter preferences. Complete **Finish radio review** before normal preference application resumes.

A preview expires after five minutes and must still match the uploaded file, local settings, and device capabilities. If any of those change, validate and preview again. File activation uses a checked CRSF settings save and restarts only after a successful save.

##### &#9193; Importing transmitter models

Transmitter model conversion runs on the computer using [tools/model_import.py](tools/model_import.py), then the resulting portable JSON is uploaded through **CRSF settings files**. The browser accepts native Remote JSON; convert the transmitter export first.

The current converter supports EdgeTX **2.10.6** and **2.12.4** YAML exports for **TX16S** and **Boxer**, including `.etx` archives containing those YAML models. OpenTX binary backups, arbitrary `.otx` files, and other versions/formats are not currently parsed. It converts the supported subset of a model and reports unsupported features with their source paths instead of silently dropping them.

Install its dependency from the repository root:

```sh
python -m pip install -r tools/model_import_requirements.txt
```

The converter exposes the Python function `convert_model`; it does not have a standalone command-line interface. For example, save and run this Python code from the repository root, replacing the filename, radio/version, and physical input mapping to match your setup:

```python
import json
from pathlib import Path
from tools.model_import import convert_model

mapping = {
    "axes": {"Ail": 1, "Ele": 2, "Rud": 3, "Thr": 4},
    "gimbals": [1, 2, 3, 4],
    "switches": list(range(5, 17)),
    "switchMap": {"SF": {"input": 0, "reverse": False, "positions": 2}},
}
result = convert_model(Path("model.yml"), "TX16S", "2.12.4", mapping)
if result.errors:
    raise ValueError("\n".join(f"{e.path}: {e.message}" for e in result.errors))
Path("model.remote-model.json").write_text(
    json.dumps(result.profile, indent=2), encoding="utf-8"
)
```

`axes` explicitly maps the transmitter's four named axes to native input IDs. `gimbals` and `switches` choose four and twelve output destinations; 0 means None, and enabled destinations must be unique. `switchMap` maps supported two-position controls to zero-based native switch inputs: TX16S SF, or Boxer SA/SD. Three-position switches are rejected. For a multi-model `.etx` archive, add `mapping["model"]` with the exact model YAML path inside the archive.

Review the generated inputs, routing, logical switches, mixes, display settings, and desired radio preferences before importing; the example is a mapping example, not a complete copy of every transmitter function.

##### &#9193; External radio settings

[tools/radio_snapshot.py](tools/radio_snapshot.py) captures external TX/RX menu values in `.remote-radio.json` files. It records device identity and available persistent fields; missing or unsupported values are reported. Folders, commands, and transient information are never restored. RF band, RF rate, antenna, switch mode, and Model Match changes require explicit live UI actions.

For example, from the repository root while connected to the Remote AP or the same network as the Remote. Use an address or hostname reachable from your computer:

```sh
python tools/radio_snapshot.py capture --host http://192.168.4.1 --out baseline.remote-radio.json
python tools/radio_snapshot.py preview --host http://192.168.4.1 --snapshot baseline.remote-radio.json --out tx.remote-radio-preview.json --device-role tx
```

Review the saved preview before using the helper's `apply` command with `--confirmed`. Transmitter and receiver groups are reviewed/applied separately. Receiver writes also require `--receiver-confirmed` and a connected, disarmed receiver. Apply writes one field at a time with readback; rollback after a failed write is best effort.

For RX previews of a receiver that exposes **Output Ch**, add `--selector-sweep` to both capture and RX preview to include and verify its output contexts. Without the sweep, that RX capture is incomplete and cannot produce an RX preview; its captured TX group can still be used independently. The explicit sweep temporarily moves the receiver's output cursor and restores it afterward, and requires maintenance plus a connected, known-disarmed receiver with fresh status. Run `python tools/radio_snapshot.py --help` or a subcommand's `--help` for the available options.

---

### HA/MQTT Settings

##### &#9193; Home Assistant support (MQTT)

If checked, the Remote will connect to the broker (if configured) and send and receive messages via [MQTT](#home-assistant--mqtt)

##### &#9193; Broker IP[:port] or domain[:port]

The broker server address. Can be a domain (eg. "myhome.me") or an IP address (eg "192.168.1.5"). The default port is 1883. If a different port is to be used, it can be specified after the domain/IP and a colon ":", for example: "192.168.1.5:1884". Specifying the IP address is preferred over a domain since the DNS call adds to the network overhead. ".local" (MDNS) domains are not supported.

##### &#9193; Protocol version

The firmware supports MQTT 3.1.1 and 5.0. There is no difference in features, so there is no advantage in selecting 5.0. This was implemented only for brokers that do not support 3.1.1.

##### &#9193; User[:Password]

The username (and optionally the password) to be used when connecting to the broker. Can be left empty if the broker accepts anonymous logins.

##### &#9193; Button x topic

The MQTT topic for on/off messages. Nothing is published/sent if the topic is empty.

##### &#9193; Button x message on ON/OFF

The MQTT message to publish to the button's topic when a button is pressed/released (or in case of a maintained switch: when the switch is put in "on"/"off" position). If a field is empty, nothing is published/sent.

---

## Appendix B: Display messages

- "INS" -> "SND" -> "PCK": Please install/update the [sound pack](#sound-pack-installation)
- "BAT": Battery is low
- "CAL", "UP", "DN": Shown during [calibration](#calibration)
- "ERR": Error while installing the sound-pack or during calibration. Please try again.
- "FUL": Battery is full, ie 100% charged
- "IP": IP address is going to be shown.
- "RST": WiFi password temporarily cleared; static IP permanently deleted
- "UPD": Firmware update available. Shown briefly at power-up.

---
_Text & images: (C) Thomas Winischhofer ("A10001986"). See LICENSE._ [Source](https://remote.out-a-ti.me)  
_No generative AI or automated code-completion tools were used in the development of this project. This statement does, however, not apply to the ELRS/CRFS version from CircuitSetup._   
_Other props: [Time Circuits Display](https://tcd.out-a%2dti.me) ... [Flux Capacitor](https://fc.out-a%2dti.me) ... [SID](https://sid.out-a%2dti.me) ... [Dash Gauges](https://dg.out-a%2dti.me) ... [VSR](https://vsr.out-a%2dti.me) ... [TFC](https://tfc.out-a%2dti.me) ... [Jukebox](https://jb.out-a%2dti.me)_
