CircuitSetup/Remote/Labels/README.md

White printing might require vector data. The EPS file contains vector data.
