CircuitSetup/Remote/CheatSheet.pdf

Power ON | Press | Hold
O . O | Prepare for Time Travel | Play/Stop

Previous
track*
R E S E T | Next track

Toggle Shuffle

Toggle
Auto-Throttle*
CALIBRATION | Reset speed

2 seconds (2 beeps):
Display IP address,
battery state**

6 seconds (3 beeps):
Toggle Car Mode (https://remote.out-a-ti.me/#car-setup)
Power O F F | Press | Hold
O . O | Volume up | Brightness up

Take over control of
TCD Fake Power*
R E S E T | Volume down

Brightness down

Relinquish control of
TCD Fake Power*
CALIBRATION | Calibrate
neutral

2 seconds (2 beeps):
Start calibration for
up and down

6 seconds (3 beeps):
Toggle Car Mode (https://remote.out-a-ti.me/#car-setup)
* | If so configured in Config Portal
** | If battery monitoring is available; State-of-Charge and Time-To-Empty
| (minutes) shown alternately

## Remote Control

A10001986

## Commands from TCD / HA

Toggle Movie-mode/linear acceleration | 7060
Toggle TCD speed display while off | 7061
Toggle Auto-Throttle | 7062
Toggle Coasting | 7063
Select volume level (00 - 20) | 73xx
Disable acceleration click sound | 7350
Enable acceleration click sound | 7351
Select brightness level (00 - 15) | 74xx
Music Player (https://remote.out-a-ti.me/#the-music-player) : Play / Stop | 7005
Music Player (https://remote.out-a-ti.me/#the-music-player) : Previous track | 7002
Music Player (https://remote.out-a-ti.me/#the-music-player) : Next track | 7008
Music Player (https://dg.out-a-ti.me/#the-music-player) : Select music folder | 705x
Music Player (https://remote.out-a-ti.me/#the-music-player) : Shuffle off | 7222
Music Player (https://remote.out-a-ti.me/#the-music-player) : Shuffle on | 7555
Music Player (https://remote.out-a-ti.me/#the-music-player) : Go to track 000 | 7888
Music Player (https://remote.out-a-ti.me/#the-music-player) : Go to track xxx | 7888xxx
Play “keyX.mp3” (X = 1, 3, 4, 6, 7, 9) | 700x
Play “keyX.mp3” / “keyXl.mp3” (X = 1 - 9) | 750x / 751x
Display current IP address | 7090
Battery: Display State-of-Charge* | 7091
Battery: Display Time-To-Empty (minutes) * | 7092
Battery: Display voltage* | 7093
Toggle control of TCD Fake Power | 7096
Disable/Enable Car Mode** (https://remote.out-a-ti.me/#car-setup) | 7990 / 7991
Restart** | 7064738
Delete static IP address** | 7123456

Control through TCD requires BTTFN connection.

* | If battery monitoring is available
** | Not through HA/MQTT-INJECT

## Remote Control

A10001986
