CircuitSetup/Remote/img/total1.jpg

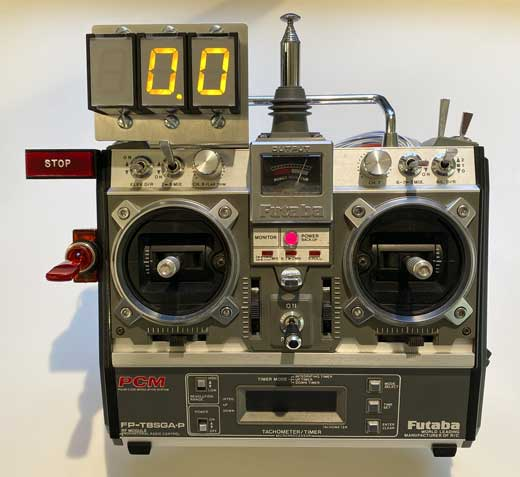
img/total1.jpg
