CircuitSetup/Remote/img/total2.jpg

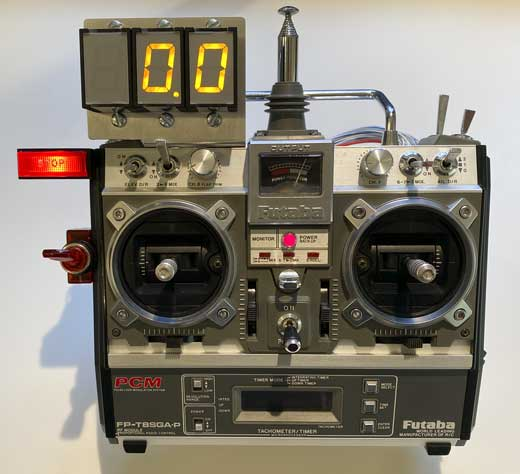
img/total2.jpg
