CircuitSetup/Remote/img/wires2.jpg

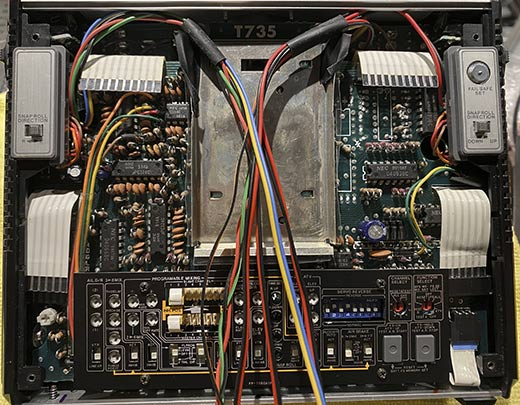
img/wires2.jpg
