CircuitSetup/Remote/img/wires.jpg

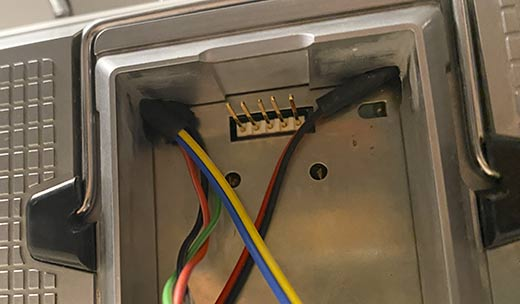
img/wires.jpg
