CircuitSetup/Remote/Labels/stop_w.png

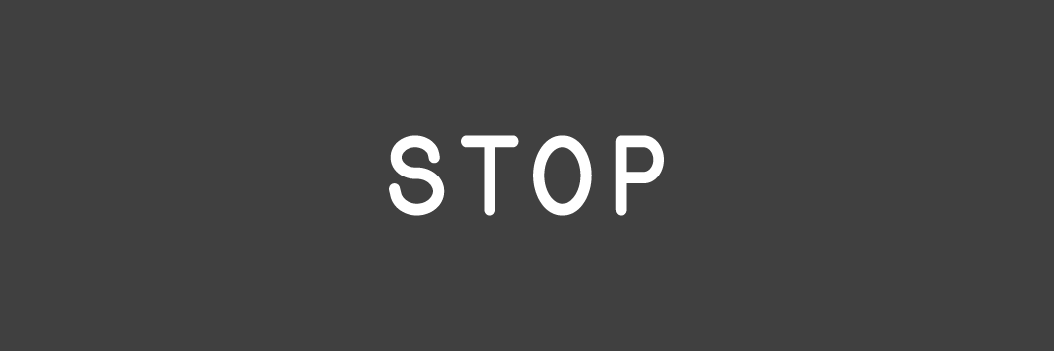
Labels/stop_w.png
