CircuitSetup/Remote/Electronics/BOM_Futaba_2025-03-07.csv

ID | Name | Designator | Footprint | Quantity | Manufacturer Part | Manufacturer | Supplier | Supplier Part | Price
1 | CONN-TH_XH-4AWD | CN_AUX | CONN-TH_XH-4AWD | 1 | XH-4AWD | BOOMELE(博穆精密) | LCSC | C8877 | 0.019
2 | CONN-TH_S2B-PH-K-S-LF-SN | CN_BATT,CN_PMTR,CN_PLED,CN_AOUT | CONN-TH_S2B-PH-K-S-LF-SN | 4 | S2B-PH-K-S(LF)(SN) | JST | LCSC | C173752 | 0.032
3 | R0603 | R108,R105 | R0603 | 2 | 0603WAF1002T5E | UNI-ROYAL(厚声) | LCSC | C25804 | 0.001
4 | C0603 | C2 | C0603 | 1 | CL10A225KO8NNNC | SAMSUNG(三星) | LCSC | C23630 | 0.006
5 | WLCSP-12_L2.0-W1.5-R3-C4-P0.40-TL | U4 | WLCSP-12_L2.0-W1.5-R3-C4-P0.40-TL | 1 | LC709204FXE-01TBG | onsemi(安森美) | LCSC | C895466 | 2.317
6 | CONN-TH_DG308-2.54-02P-14-00A | CN_FP,CN_CA | CONN-TH_DG308-2.54-02P-14-00A | 2 | DG308-2.54-02P-14-00A(H) | DEGSON（高正/高松） | LCSC | C699496 | 0.311
7 | CONN-TH_DG308-2.54-04P-14-00A-H | CN_STOP,CN_BU14,CN_BU58,CN_BUAB | CONN-TH_DG308-2.54-04P-14-00A-H | 4 | DG308-2.54-04P-14-00A(H) | DEGSON（高正/高松） | LCSC | C708735 | 0.609
8 | C0603 | C24 | C0603 | 1 | CL10A105KB8NNNC | SAMSUNG(三星) | LCSC | C15849 | 0.004
9 | R0603 | R2 | R0603 | 1 | 0603WAF1502T5E | UNI-ROYAL(厚声) | LCSC | C22809 | 0.001
10 | R0603 | R101,RX | R0603 | 2 | 0603WAF1001T5E | UNI-ROYAL(厚声) | LCSC | C21190 | 0.001
11 | SOT-23-3_L3.0-W1.7-P0.95-LS2.9-BR | U26 | SOT-23-3_L3.0-W1.7-P0.95-LS2.9-BR | 1 | S8050M-D HY3D | BLUE ROCKET(蓝箭) | LCSC | C305482 | 0.011
12 | R0603 | R1 | R0603 | 1 | 0603WAF750JT5E | UNI-ROYAL(厚声) | LCSC | C4275 | 0.001
13 | RES-ARRAY-SMD_0603-8P-L3.2-W1.6-BL | R107,R26 | RES-ARRAY-SMD_0603-8P-L3.2-W1.6-BL | 2 | 4D03WGJ0103T5E | UNI-ROYAL(厚声) | LCSC | C29718 | 0.006
14 | CONN-TH_26P-P2.00_HCTL_HC-PHD | CN_DISP | CONN-TH_26P-P2.00_HCTL_HC-PHD | 1 | HC-PHD-2*13AW | HCTL(华灿天禄) | LCSC | C2845642 | 0.289
15 | C0805 | C23,C19,C20,C21 | C0805 | 4 | CL21A106KAYNNNE | SAMSUNG(三星) | LCSC | C15850 | 0.01
16 | SSOP-28_L9.9-W3.9-P0.64-LS6.0-BL | U3 | SSOP-28_L9.9-W3.9-P0.64-LS6.0-BL | 1 | HT16K33A-28SSOP | HOLTEK(合泰/盛群) | LCSC | C5444738 | 0.5
17 | C0805 | C1 | C0805 | 1 | CL21A226MAQNNNE | SAMSUNG(三星) | LCSC | C45783 | 0.022
18 | R0603 | FB3,FB4,FB2,FB1 | R0603 | 4 | CBW160808U101T | FH (Guangdong Fenghua Advanced Tech) | LCSC | C64181 | 0.004
19 | CONN-TH_DG308-2.54-03P-14-00A-H | CN_THR | CONN-TH_DG308-2.54-03P-14-00A-H | 1 | DG308-2.54-03P-14-00A(H) | DEGSON（高正/高松） | LCSC | C691850 | 0.444
20 | VSSOP-10_L3.0-W3.0-P0.50-LS4.9-BL | U5 | VSSOP-10_L3.0-W3.0-P0.50-LS4.9-BL | 1 | ADS1015IDGSR | TI(德州仪器) | LCSC | C193969 | 0.913
21 | C0603 | C17,C15,C10 | C0603 | 3 | CC0603KRX7R9BB104 | YAGEO(国巨) | LCSC | C14663 | 0.002
22 | R0603 | R4,R31 | R0603 | 2 | 0603WAF0000T5E | UNI-ROYAL(厚声) | LCSC | C21189 | 0.001
23 | TSSOP-16_L5.0-W4.4-P0.65-LS6.4-BL | U1 | TSSOP-16_L5.0-W4.4-P0.65-LS6.4-BL | 1 | PCA9554PW,118 | NXP(恩智浦) | LCSC | C17230 | 1.282
24 | HDR-TH_19P-P2.54-V-F | ESP_HDR1,ESP_HDR2 | HDR-TH_19P-P2.54-V-F | 2 | KH-2.54FH-1X19P-H8.5 | Shenzhen Kinghelm Elec | LCSC | C2932678 | 0.158
25 | SOT-23-3_L3.0-W1.6-P1.90-LS2.8-BR | U7 | SOT-23-3_L3.0-W1.6-P1.90-LS2.8-BR | 1 | ESDAVLC6-2BLY | ST(意法半导体) | LCSC | C1977179 | 0.586
26 | R0603 | R22,R21,R18,R17,R24,R23 | R0603 | 6 | 0603WAF4701T5E | UNI-ROYAL(厚声) | LCSC | C23162 | 0.001
27 | SOT-323-3_L2.1-W1.3-P1.30-LS2.3-BR | U15,U11 | SOT-323-3_L2.1-W1.3-P1.30-LS2.3-BR | 2 | 2N7002PW | ElecSuper(静芯微) | LCSC | C5224236 | 0.02
28 | R0603 | R33,R32 | R0603 | 2 | 0603WAF1000T5E | UNI-ROYAL(厚声) | LCSC | C22775 | 0.001
29 | C0603 | C13,C12 | C0603 | 2 | CL10B221KB8NNNC | SAMSUNG(三星) | LCSC | C1603 | 0.005
30 | C0603 | C11 | C0603 | 1 | CL10A106KP8NNNC | SAMSUNG(三星) | LCSC | C19702 | 0.006
31 | R0603 | R27 | R0603 | 1 | RS-03K6343FT | FH(风华) | LCSC | C321970 | 0.001
32 | TQFN-16_L3.0-W3.0-P0.50-BL-EP1.5 | U17 | TQFN-16_L3.0-W3.0-P0.50-BL-EP1.5 | 1 | MAX98357AETE+T | ADI(亚德诺)/MAXIM(美信) | LCSC | C910544 | 1.985
33 | TF-SMD_TF-012 | TF1 | TF-SMD_TF-012 | 1 |  |  | LCSC | C7529391 | 0.064
