CircuitSetup/Remote/install/README.md

This folder holds all files necessary for immediate installation on your Remote. Here you'll find
- a binary of the current firmware, ready for upload to the device ("xxx.bin");
- the latest matching sound-pack ("sound-pack-rmXX.zip")

For installation instructions, see [here](../README.md#firmware-installation).

Note: As of version 1.20, the internally used file format for secondary and IP settings was changed. Version 1.20 will automatically update old files to the new format, later versions will not. If you intend to update from a version below 1.20 to a version above 1.20, please install [version 1.20](https://github.com/realA10001986/Remote/releases/tag/V1.20) as an intermediate to have your secondary and IP settings converted.
