CircuitSetup/Remote/img/cp_setup.png

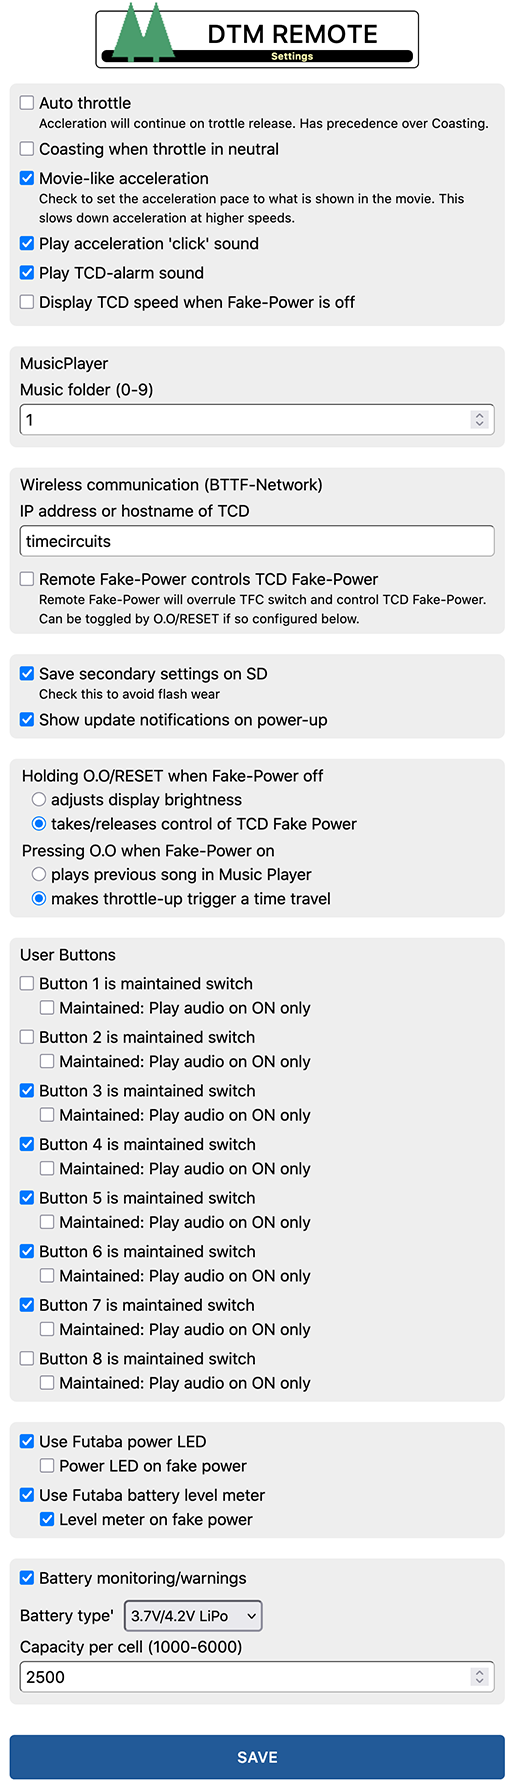
img/cp_setup.png
