CircuitSetup/Remote/src/remote_settings.h

/*
 * -------------------------------------------------------------------
 * Remote Control
 * (C) 2024-2026 Thomas Winischhofer (A10001986)
 * https://github.com/realA10001986/Remote
 * https://remote.out-a-ti.me
 *
 * Settings handling
 *
 * -------------------------------------------------------------------
 * License: Modified MIT NON-AI
 * 
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
 * Links inside the Software pointing to the original source must not 
 * be changed or removed.
 *
 * In addition, the following restrictions apply:
 * 
 * 1. The Software and any modifications made to it may not be used 
 * for the purpose of training or improving machine learning algorithms, 
 * including but not limited to artificial intelligence, natural 
 * language processing, or data mining. This condition applies to any 
 * derivatives, modifications, or updates based on the Software code. 
 * Any usage of the Software in an AI-training dataset is considered a 
 * breach of this License.
 *
 * 2. The Software may not be included in any dataset used for 
 * training or improving machine learning algorithms, including but 
 * not limited to artificial intelligence, natural language processing, 
 * or data mining.
 *
 * 3. Any person or organization found to be in violation of these 
 * restrictions will be subject to legal action and may be held liable 
 * for any damages resulting from such use.
 *
 * THE SOFTWARE IS PROVIDED "AS IS", WITHOUT WARRANTY OF ANY KIND, 
 * EXPRESS OR IMPLIED, INCLUDING BUT NOT LIMITED TO THE WARRANTIES OF 
 * MERCHANTABILITY, FITNESS FOR A PARTICULAR PURPOSE AND NONINFRINGEMENT. 
 * IN NO EVENT SHALL THE AUTHORS OR COPYRIGHT HOLDERS BE LIABLE FOR ANY 
 * CLAIM, DAMAGES OR OTHER LIABILITY, WHETHER IN AN ACTION OF CONTRACT, 
 * TORT OR OTHERWISE, ARISING FROM, OUT OF OR IN CONNECTION WITH THE 
 * SOFTWARE OR THE USE OR OTHER DEALINGS IN THE SOFTWARE.
 */

#ifndef _REMOTE_SETTINGS_H
#define _REMOTE_SETTINGS_H

void unmount_fs();

void deleteFileFromSD(const char *fn);
bool readFileFromSD(const char *fn, uint8_t *buf, int len);
bool writeFileToSD(const char *fn, uint8_t *buf, int len);

bool evalBool(char *s);

void write_settings();
#ifdef HAVE_MQTT
void write_mqtt_settings();
#endif

void settings_setup();

void loadCalib();
void saveCalib();

void loadBrightness();
void storeBrightness();
void saveBrightness();

void loadCurVolume();
void storeCurVolume();
void saveCurVolume();

void loadMovieMode();
void saveMovieMode();

void loaddisplayTCDSMode();
void savedisplayTCDSMode();

void saveUpdAvail();

void loadUpdVers(int &v, int& r);
void saveUpdVers(int v, int r);

void saveAllSecCP();

void saveCarMode();

bool loadVis();
void storeVis();
void saveVis();

void loadMusFoldNum();
void saveMusFoldNum();

void loadShuffle();
void saveShuffle();

void saveAllTerCP();

bool loadIpSettings();
void writeIpSettings();
void deleteIpSettings();

void moveSettings();

bool check_if_default_audio_present();
bool prepareCopyAudioFiles();
void doCopyAudioFiles();

bool check_allow_CPA();
void delete_ID_file();

#define MAX_SIM_UPLOADS 16
#define UPL_OPENERR 1
#define UPL_NOSDERR 2
#define UPL_WRERR   3
#define UPL_BADERR  4
#define UPL_MEMERR  5
#define UPL_UNKNOWN 6
#define UPL_DPLBIN  7
#include <FS.h>
bool   openUploadFile(String& fn, File& file, int idx, bool haveAC, int& opType, int& errNo);
size_t writeACFile(File& file, uint8_t *buf, size_t len);
void   closeACFile(File& file);
void   removeACFile(int idx);
void   renameUploadFile(int idx);
char   *getUploadFileName(int idx);
int    getUploadFileNameLen(int idx);
void   freeUploadFileNames();

#define MS(s) XMS(s)
#define XMS(s) #s

// Default settings

#define DEF_HOSTNAME        "dtmremote"
#define DEF_WIFI_RETRY      3     // 1-10; Default: 3 retries
#define DEF_RECON_ON_FP     1     // 1: Reconnection attempt on Fake Power, 0: no
#define DEF_AP_CHANNEL      1     // 1-13; 0 = random(1-13)
#define DEF_WIFI_APOFFDELAY 0
#define DEF_REACT_AP_ON_FP  1     // 1: Re-activate AP on Fake Power, 0: don't.

#define DEF_COAST           0     // Engine braking / coasting
#define DEF_AT              0     // Auto-throttle: Default off
#define DEF_MOV_MD          1     // 1: movie-accurate accel pace, 0: linear and faster
#define DEF_TUT             0     // 0: Play throttle-up sound only when speed is 0; 1: any time when throttle is pushed up
#define DEF_PLAY_CLK        1     // 1: Play accel-clicks, 0: Do not
#define DEF_PLAY_ALM_SND    0     // 1: Play TCD-alarm sound, 0: do not
#define DEF_DISP_TCDS       0     // 1: Display TCD speed (GPS, RotEnc) when fake-off, 0: Do not
#define DEF_BRI             15    // Default display brightness

#define DEF_TCD_IP          ""    // TCD hostname (or ip address) for BTTFN
#define DEF_PWR_MST         0     // 0: Remote is not BTTFN-wide power-master, 1: Remote is.
#define DEF_REF_BUT         0     // Button for "Refill". 0 = none; 1-8 button number

#define DEF_CFG_ON_SD       1     // Save secondary settings on SD card. Default: Yes (1)
#define DEF_SD_FREQ         0     // SD/SPI frequency: Default 16MHz

#define DEF_OORST           0     // 0: O.O/RESET used for bri adjustment; 1: used for toggling powermaster
#define DEF_OO_TT           1     // O.O:   1: trigger BTTFN-wide TT; 0: musicplayer prev track
#define DEF_RES_AT          0     // RESET: 1: toggle "auto-throttle" setting; 0: MP toggle shuffle

#define DEF_DIS_BPACK       0     // 1: Disable ButtonPack (Buttons 1-8), 0: Use buttons 1-8 if detected
#define DEF_BPMAINT         0     // ButtonPack button is momentary (0) or maintained (1)
#define DEF_BPMTOO          0     // Maintained switch: Play audio on ON only (1), or on each flip (0)

#define DEF_USE_PLED        0     // 1: Use power LED, 0: do not, leave dark (like mostly in movie)
#define DEF_PLEDFP          1     // 1: Power LED on fake power, 0: on real power
#define DEF_USE_LVLMTR      0     // 1: Use Batt. Level Meter, 0: do not, leave at zero (like in movie)
#define DEF_LVLFP           1     // 1: Meter on fake power, 0: on real power

#define DEF_USE_PWRMON      1     // 1: Use Power Monitor (if present), 0: do not
#define DEF_BAT_TYPE        0     // 0=3.7/4.2V
#define DEF_BAT_CAP         2500  // battery capacity per cell (2500 fits CS-provided battery)

#ifdef HAVE_CRSF
#define DEF_OPMODE          0     // 0: Prop mode (legacy)  1: CRSF/ELRS mode
#define DEF_CRSFWM          1     // 0: Remain in AP mode   1: Connect to WiFi in CRSF/ELRS mode
#define DEF_ELRSPKTRATE     3
#define DEF_ELRSSPDUNIT     0
#define DEF_ELRSROLLCH      1
#define DEF_ELRSPITCHCH     2
#define DEF_ELRSTHRCH       3
#define DEF_ELRSYAWCH       4
#endif

struct Settings {
    char ssid[34]           = "";
    char pass[66]           = "";
    char bssid[18]          = "";

    char cm_ssid[14]        = "TCD-AP";
    char cm_pass[10]        = "";
    char cm_bssid[18]       = "";

    char hostName[32]       = DEF_HOSTNAME;
    char wifiConRetries[4]  = MS(DEF_WIFI_RETRY);
    char reconOnFP[2]       = MS(DEF_RECON_ON_FP);
    char systemID[8]        = "";
    char appw[10]           = "";
    char apChnl[4]          = MS(DEF_AP_CHANNEL);
    char wifiAPOffDelay[4]  = MS(DEF_WIFI_APOFFDELAY);
    char reactAPOnFP[2]     = MS(DEF_REACT_AP_ON_FP);

    char autoThrottle[2]    = MS(DEF_AT);
    char coast[2]           = MS(DEF_COAST);
    char playTUT[2]         = MS(DEF_TUT);
    char playClick[2]       = MS(DEF_PLAY_CLK);
    char playALsnd[2]       = MS(DEF_PLAY_ALM_SND);

    char tcdIP[32]          = DEF_TCD_IP;
    char pwrMst[2]          = MS(DEF_PWR_MST);
    char refBut[2]          = MS(DEF_REF_BUT);

    char CfgOnSD[2]         = MS(DEF_CFG_ON_SD);

    char oorst[2]           = MS(DEF_OORST);
    char ooTT[2]            = MS(DEF_OO_TT);
    char resAT[2]           = MS(DEF_RES_AT);

#ifdef ALLOW_DIS_UB
    char disBPack[2]        = MS(DEF_DIS_BPACK);
#endif    
    char bPb0Maint[2]       = MS(DEF_BPMAINT);
    char bPb1Maint[2]       = MS(DEF_BPMAINT);
    char bPb2Maint[2]       = MS(DEF_BPMAINT);
    char bPb3Maint[2]       = MS(DEF_BPMAINT);
    char bPb4Maint[2]       = MS(DEF_BPMAINT);
    char bPb5Maint[2]       = MS(DEF_BPMAINT);
    char bPb6Maint[2]       = MS(DEF_BPMAINT);
    char bPb7Maint[2]       = MS(DEF_BPMAINT);

    char bPb0MtO[2]         = MS(DEF_BPMTOO);
    char bPb1MtO[2]         = MS(DEF_BPMTOO);
    char bPb2MtO[2]         = MS(DEF_BPMTOO);
    char bPb3MtO[2]         = MS(DEF_BPMTOO);
    char bPb4MtO[2]         = MS(DEF_BPMTOO);
    char bPb5MtO[2]         = MS(DEF_BPMTOO);
    char bPb6MtO[2]         = MS(DEF_BPMTOO);
    char bPb7MtO[2]         = MS(DEF_BPMTOO);

    char usePwrLED[2]       = MS(DEF_USE_PLED);
    char pwrLEDonFP[2]      = MS(DEF_PLEDFP);
    char useLvlMtr[2]       = MS(DEF_USE_LVLMTR);
    char LvLMtronFP[2]      = MS(DEF_LVLFP);
#ifdef HAVE_PM
    char usePwrMon[2]       = MS(DEF_USE_PWRMON);
    char batType[4]         = MS(DEF_BAT_TYPE);
    char batCap[6]          = MS(DEF_BAT_CAP);
#endif

#ifdef HAVE_MQTT
    char useMQTT[2]         = "0";
    char mqttVers[2]        = "0"; // 0 = 3.1.1, 1 = 5.0
    char mqttServer[80]     = "";  // ip or domain [:port]  
    char mqttUser[128]      = "";  // user[:pass] (UTF8)
    #ifdef HAVE_MQTT_MP
    char pubMP[2]           = "0"; // 1:Publish music player status to bttf/remote/mpstatus, 0: Don't
    #endif
    char mqttbt[8][128]     = { 0 };  // buttons topics (UTF8)
    char mqttbo[8][64]      = { 0 };  // buttons on message (UTF8)
    char mqttbf[8][64]      = { 0 };  // buttons off message (UTF8)
#endif

#ifdef HAVE_CRSF
    char opMode[2]          = MS(DEF_OPMODE);
    char crsfap[2]          = MS(DEF_CRSFWM);
    char elrsPktRate[2]     = MS(DEF_ELRSPKTRATE);
    char elrsSpdUnit[2]     = MS(DEF_ELRSSPDUNIT);

    // Kludges. Saved as "profile".
    char elrsAdcHysteresis[3] = "5";
    char elrsThrIdleDeadband[3] = "5";
    char elrsAxisExpo[4][4] = {"0","0","0","0"};
    char elrsSwitchCh[12][3] = {"5","6","7","8","9","10","11","12","13","14","15","16"};
    char elrsRollCh[3]      = MS(DEF_ELRSROLLCH);
    char elrsPitchCh[3]     = MS(DEF_ELRSPITCHCH);
    char elrsThrCh[3]       = MS(DEF_ELRSTHRCH);
    char elrsYawCh[3]       = MS(DEF_ELRSYAWCH);
    char elrsRollRev[2]     = "0";
    char elrsPitchRev[2]    = "0";
    char elrsThrRev[2]      = "0";
    char elrsYawRev[2]      = "0";
    char elrsRollLow[6]     = "0";
    char elrsRollCtr[6]     = "1024";
    char elrsRollHigh[6]    = "2047";
    char elrsPitchLow[6]    = "0";
    char elrsPitchCtr[6]    = "1024";
    char elrsPitchHigh[6]   = "2047";
    char elrsThrLow[6]      = "0";
    char elrsThrCtr[6]      = "1024";
    char elrsThrHigh[6]     = "2047";
    char elrsYawLow[6]      = "0";
    char elrsYawCtr[6]      = "1024";
    char elrsYawHigh[6]     = "2047";
#endif

    // Kludges for CP
    char movieMode[2]       = MS(DEF_MOV_MD);
    char dtcds[2]            = MS(DEF_DISP_TCDS);
    char upd[2]             = "1";
    char musicFolder[2];
    char ecmKludge[2]       = "0";  // MUST BE 0
};

struct IPSettings {
    char ip[20]       = "";
    char gateway[20]  = "";
    char netmask[20]  = "";
    char dns[20]      = "";
};

extern struct Settings settings;
extern struct IPSettings ipsettings;

extern bool   haveFS;
extern bool   haveSD;
extern bool   FlashROMode;
extern const char rspv[];

extern bool   haveAudioFiles;

extern uint8_t musFolderNum;

#endif
