CircuitSetup/Remote/src/remote_wifi.cpp

 /*
 * -------------------------------------------------------------------
 * Remote Control
 * (C) 2024-2026 Thomas Winischhofer (A10001986)
 * https://github.com/realA10001986/Remote
 * https://remote.out-a-ti.me
 *
 * WiFi and Config Portal handling
 *
 * -------------------------------------------------------------------
 * License: Modified MIT NON-AI
 * 
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
 * Links inside the Software pointing to the original source must not 
 * be changed or removed.
 *
 * In addition, the following restrictions apply:
 * 
 * 1. The Software and any modifications made to it may not be used 
 * for the purpose of training or improving machine learning algorithms, 
 * including but not limited to artificial intelligence, natural 
 * language processing, or data mining. This condition applies to any 
 * derivatives, modifications, or updates based on the Software code. 
 * Any usage of the Software in an AI-training dataset is considered a 
 * breach of this License.
 *
 * 2. The Software may not be included in any dataset used for 
 * training or improving machine learning algorithms, including but 
 * not limited to artificial intelligence, natural language processing, 
 * or data mining.
 *
 * 3. Any person or organization found to be in violation of these 
 * restrictions will be subject to legal action and may be held liable 
 * for any damages resulting from such use.
 *
 * THE SOFTWARE IS PROVIDED "AS IS", WITHOUT WARRANTY OF ANY KIND, 
 * EXPRESS OR IMPLIED, INCLUDING BUT NOT LIMITED TO THE WARRANTIES OF 
 * MERCHANTABILITY, FITNESS FOR A PARTICULAR PURPOSE AND NONINFRINGEMENT. 
 * IN NO EVENT SHALL THE AUTHORS OR COPYRIGHT HOLDERS BE LIABLE FOR ANY 
 * CLAIM, DAMAGES OR OTHER LIABILITY, WHETHER IN AN ACTION OF CONTRACT, 
 * TORT OR OTHERWISE, ARISING FROM, OUT OF OR IN CONNECTION WITH THE 
 * SOFTWARE OR THE USE OR OTHER DEALINGS IN THE SOFTWARE.
 */

#include "remote_global.h"

#include <Arduino.h>

#include "src/WiFiManager/WiFiManager.h"

#include "display.h"
#include "remote_audio.h"
#include "remote_settings.h"
#include "remote_wifi.h"
#include "remote_main.h"
#ifdef HAVE_CRSF
#include "src/CRSF/crsf_kludge.h"
#include "src/CRSF/crsf_settings.h"
#ifdef HAVE_MQTT
#include "src/CRSF/crsf_mqtt.h"
#endif
#endif
#ifdef HAVE_MQTT
#include "mqtt.h"
#endif

#define STRLEN(x) (sizeof(x)-1)

Settings settings;

IPSettings ipsettings;

WiFiManager wm;
bool wifiSetupDone = false;

#ifdef HAVE_MQTT
#ifdef HAVE_CRSF
CRSFClient mqttWClient;
static bool mqttLooperActive = false;
#else
WiFiClient mqttWClient;
#endif
PubSubClient mqttClient(mqttWClient);
#endif

static const char R_updateacdone[] = "/uac";

static const char acul_part1[]  = "</style>";
static const char acul_part3[]  = "</head><body><div id='wrap'><h1 id='h1'>";
static const char acul_part5[]  = "</h1><h3 id='h3'>File upload</h3><div class='msg";
static const char acul_part7[]  = " S' id='lc'><strong>Upload successful.</strong><br/>Device rebooting.";
static const char acul_part7a[] = "<br>Installation will proceed after reboot.";
static const char acul_part71[] = " D'><strong>Upload failed.</strong><br>";
static const char acul_part8[]  = "</div></div></body></html>";
static const char * const acul_errs[]  = {
    "Can't open file on SD",
    "No SD card found",
    "Write error",
    "Bad file",
    "Not enough memory",
    "Unrecognized type",
    "Extraneous .bin file"
};

static const char tcdList[] = "<datalist id='tcda'><option value='TCD-AP%s'></option></datalist><datalist id='hnl'><option value='dtmremote'></option></datalist>";

static const char tcdSSID0[] = "<div style='margin:0 0 10px 0;padding:0;font-size:80%'>";
static const char tcdSSIDp[] = "%sSSID of currently connected TCD is <b>TCD-AP%s</b></div>";
static const char tcdSSIDq[] = "%sCurrently connected TCD has %s password configured</div>";
static const char tcdAPPW1[] = "no";
static const char tcdAPPW2[] = "a";

static const char * const apChannelCustHTMLSrc[14] = {
    "'>WiFi channel",
    "apchnl",
    ">Random%s1'",
    ">1%s2'",
    ">2%s3'",
    ">3%s4'",
    ">4%s5'",
    ">5%s6'",
    ">6%s7'",
    ">7%s8'",
    ">8%s9'",
    ">9%s10'",
    ">10%s11'",
    ">11%s"
};

static const char * const tutCustHTMLSrc[5] = {
    "mt5",
    "Play throttle-up sound on throttle-up",
    "tut",
    "only at speed 0",
    "at any speed"
};


static const char * const musFoldCustHTMLSrc[12] = {
    "'>Music folder",
    "mfol",
    ">0%s%s1'",
    ">1%s%s2'",
    ">2%s%s3'",
    ">3%s%s4'",
    ">4%s%s5'",
    ">5%s%s6'",
    ">6%s%s7'",
    ">7%s%s8'",
    ">8%s%s9'",
    ">9%s%s"
};

static const char * const musFoldStates[6] = {
    " No SD card",
    " Not a folder",
    " No audio files",
    "", // (Needs processing)",
    " Not found",
    ""
};

static const char * const refillCustHTMLSrc[11] = {
    "'>Button to refill Plutonium",
    "refb",
    ">None%s1'",
    ">1%s2'",
    ">2%s3'",
    ">3%s4'",
    ">4%s5'",
    ">5%s6'",
    ">6%s7'",
    ">7%s8'",
    ">8%s"
};

static const char * const oorstCustHTMLSrc[5] = {
    "",
    "Holding O.O/RESET when Fake-Power off",
    "oorst",
    "adjusts display brightness",
    "takes/releases control of TCD Fake Power"
};

static const char * const oottCustHTMLSrc[5] = {
    "mt5",
    "Pressing O.O when Fake-Power on",
    "oott",
    "plays previous track with Music Player",
    "makes throttle-up trigger a time travel"
};

static const char * const resatCustHTMLSrc[5] = {
    "mt5",
    "Holding RESET when Fake-Power on",
    "resat",
    "toggles shuffle in Music Player",
    "toggles auto-throttle"
};

#ifdef HAVE_PM
static const char * const batTypeHTMLSrc[7] = {
    "'>Battery type'",
    "bty",
    ">3.7V/4.2V LiPo%s3'",
    ">3.8V/4.35V LiPo%s4'",
    ">3.85V/4.4V LiPo%s1'",
    ">UR18650ZY%s2'",
    ">ICR18650-26H%s"
};
static const char *wmBuildBatType(const char *dest, int op);
#endif

#ifdef HAVE_MQTT
static const char * const mqttpCustHTMLSrc[4] = {
    "'>Protocol version",
    "mprot",
    ">3.1.1%s1'",
    ">5.0%s"
};
static const char mqttMsgDisabled[] = "Disabled";
static const char mqttMsgResolvErr[] = "DNS lookup error";
static const char mqttMsgConnecting[] = "Connecting...";
static const char mqttMsgTimeout[] = "Connection time-out";
static const char mqttMsgFailed[] = "Connection failed";
static const char mqttMsgDisconnected[] = "Disconnected";
static const char mqttMsgConnected[] = "Connected";
static const char mqttMsgBadProtocol[] = "Protocol error";
static const char mqttMsgUnavailable[] = "Server unavailable/busy";
static const char mqttMsgBadCred[] = "Login failed";
static const char mqttMsgGenError[] = "Error";
#endif

static const char *wmBuildTCDAPList(const char *dest, int op);
static const char *wmBuildTCDSSID(const char *dest, int op);
static const char *wmBuildTCDPW(const char *dest, int op);
static const char *wmBuildApChnl(const char *dest, int op);
static const char *wmBuildBestApChnl(const char *dest, int op);

static const char *wmBuildTUT(const char *dest, int op);
static const char *wmBuildMusicFolder(const char *dest, int op);
static const char *wmBuildRefill(const char *dest, int op);
static const char *wmBuildOORST(const char *dest, int op);
static const char *wmBuildOOTT(const char *dest, int op);
static const char *wmBuildRESAT(const char *dest, int op);
static const char *wmBuildHaveSD(const char *dest, int op);

#ifdef HAVE_MQTT
static const char *wmBuildMQTTprot(const char *dest, int op);
static const char *wmBuildMQTTstate(const char *dest, int op);
static const char *wmBuildMQTTTM(const char *dest, int op);
#endif

// double-% since this goes through sprintf!
static const char bannerStart[] = "<div class='c' style='background-color:#";
static const char bannerMid[] = ";color:#fff;font-size:80%;border-radius:5px'>";

static const char bestAP[]   = "%s%s%sProposed channel at current location: %d<br>%s(Non-WiFi devices not taken into account)</div>";
static const char badWiFi[]  = "<br><i>Operating in AP mode not recommended</i>";

static const char bannerGen[] = "%s%s%s%s</div>";
static const char haveNoSD[] = "<i>No SD card present</i>";

#ifdef HAVE_MQTT
static const char mqttStatus[] = "%s%s%s%s%s (%d)</div>";
#endif

static const char custHTMLHdr1[] = "<div class='cmp0";
static const char custHTMLHdrI[] = " ml20";
static const char custHTMLHdr2[] = "'><label class='mp0' for='";
static const char custHTMLSHdr[] = "</label><select class='sel0' value='";
static const char osde[] = "</option></select></div>";
static const char ooe[]  = "</option><option value='";
static const char custHTMLSel[] = " selected";
static const char custHTMLSelFmt[] = "' name='%s' id='%s' autocomplete='off'><option value='0'";
static const char col_g[] = "609b71";
static const char col_r[] = "dc3630";
static const char col_gr[] = "777";
static const char rad0[] = "<div class='cmp0'><fieldset class='%s' style='border:none;padding:0;'><legend style='padding:0;margin-bottom:2px'>";
static const char rad1[] = "<input type='radio' id='%s%d' name='%s' value='%d'%s style='margin:5px 5px 5px 10px'><label class='mp0' for='%s%d'>%s</label><br>";
static const char rad2[] = "</legend>";
static const char radchk[] = " checked";
static const char rad99[] = "</fieldset></div>";

// WiFi Configuration

WiFiManagerParameter custom_asel(wmBuildTCDAPList);

WiFiManagerParameter custom_sectstart_cm("Car Mode settings", WFM_SECTS_HEAD|WFM_HL);
WiFiManagerParameter custom_cmhint("<div style='margin:0 0 10px 0;padding:0;font-size:80%;white-space:break-spaces;'>In Car Mode, the device connects to the TCD's access point instead of the WiFi network configured above.</div>");
WiFiManagerParameter custom_ssidcm("Network name (SSID) of TCD-AP", settings.cm_ssid, 13, "pattern='[A-Za-z0-9\\-]+' placeholder='Example: TCD-AP' list='tcda'");
WiFiManagerParameter custom_tcdssid(wmBuildTCDSSID);
WiFiManagerParameter custom_passcm("Password for TCD-AP", settings.cm_pass, 8, "minlength='8' pattern='[A-Za-z0-9\\-]+'");
WiFiManagerParameter custom_tcdpw(wmBuildTCDPW);
WiFiManagerParameter custom_bssidcm("TCD-AP BSSID<br><span>Will be filled out automatically after first connect if left empty.</span>", settings.cm_bssid, 17, "pattern='^([0-9A-Fa-f]{2}[:]){5}([0-9A-Fa-f]{2})$' placeholder='XX:XX:XX:XX:XX:XX'");
WiFiManagerParameter custom_ecm("Enable Car Mode now", settings.ecmKludge, "", WFM_LABEL_AFTER|WFM_IS_CHKBOX);

WiFiManagerParameter custom_hostName("Hostname<br><span>Network device ID. Config Portal URL: http://<i>hostname</i>.local<br>Valid characters: a-z/0-9/-</span>", settings.hostName, 31, "pattern='[A-Za-z0-9\\-]+' placeholder='dtmremote' list='hnl'", WFM_LABEL_BEFORE|WFM_SECTS);

WiFiManagerParameter custom_sectstart_wifi("WiFi connection: Other settings", WFM_SECTS|WFM_HL);
WiFiManagerParameter custom_wifiConRetries("Connection attempts (1-10)", settings.wifiConRetries, 2, "type='number' min='1' max='10'");
WiFiManagerParameter custom_reconAtmp("Re-attempt connection on Fake Power", settings.reconOnFP, "class='mt5'", WFM_LABEL_AFTER|WFM_IS_CHKBOX);

WiFiManagerParameter custom_sectstart_ap("Access point (AP) mode settings", WFM_SECTS|WFM_HL);
WiFiManagerParameter custom_sysID("Network name (SSID) appendix<br><span>Will be appended to \"REM-AP\" [a-z/0-9/-]</span>", settings.systemID, 7, "pattern='[A-Za-z0-9\\-]+'");
WiFiManagerParameter custom_appw("Password<br><span>Password to protect REM-AP. Empty or 8 characters [a-z/0-9/-]</span>", settings.appw, 8, "minlength='8' pattern='[A-Za-z0-9\\-]+'");
WiFiManagerParameter custom_apch(wmBuildApChnl);
WiFiManagerParameter custom_bapch(wmBuildBestApChnl);
WiFiManagerParameter custom_wifiAPOffDelay("Power save timer<br><span>(10-99[minutes]; 0=off)</span>", settings.wifiAPOffDelay, 2, "type='number' min='0' max='99'");
WiFiManagerParameter custom_reactAP("Re-enable WiFi on Fake Power", settings.reactAPOnFP, "class='mt5'", WFM_LABEL_AFTER|WFM_IS_CHKBOX|WFM_FOOT);

// Settings

WiFiManagerParameter custom_hsel("<datalist id='tcdh'><option value='timecircuits'></option></datalist>");

WiFiManagerParameter custom_at("Auto throttle<br><span>Accleration will continue on trottle release. Has precedence over Coasting.</span>", settings.autoThrottle, "class='mt5' style='margin-bottom:5px;'", WFM_LABEL_AFTER|WFM_IS_CHKBOX|WFM_SECTS_HEAD);
WiFiManagerParameter custom_coast("Coasting when throttle in neutral", settings.coast, "", WFM_LABEL_AFTER|WFM_IS_CHKBOX);
WiFiManagerParameter custom_sStrict("Movie-like acceleration<br><span>Check to set the acceleration pace to what is shown in the movie. This slows down acceleration at higher speeds.</span>", settings.movieMode, "class='mb0'", WFM_LABEL_AFTER|WFM_IS_CHKBOX);
WiFiManagerParameter custom_tut(wmBuildTUT);
WiFiManagerParameter custom_playclick("Play acceleration 'click' sound", settings.playClick, "", WFM_LABEL_AFTER|WFM_IS_CHKBOX);
WiFiManagerParameter custom_playALSnd("Play TCD-alarm sound", settings.playALsnd, "", WFM_LABEL_AFTER|WFM_IS_CHKBOX);
WiFiManagerParameter custom_dTCDS("Display TCD speed when Fake-Power is off", settings.dtcds, "class='mb10'", WFM_LABEL_AFTER|WFM_IS_CHKBOX);

WiFiManagerParameter custom_sectstart_mp("MusicPlayer", WFM_SECTS|WFM_HL);
WiFiManagerParameter custom_musicFolder(wmBuildMusicFolder);

WiFiManagerParameter custom_sectstart_nw("Wireless communication (BTTF-Network)", WFM_SECTS|WFM_HL);
WiFiManagerParameter custom_tcdIP("Hostname of TCD", settings.tcdIP, 31, "pattern='(^((25[0-5]|(2[0-4]|1\\d|[1-9]|)\\d)\\.?\\b){4}$)|([A-Za-z0-9\\-]+)' placeholder='Example: timecircuits' list='tcdh'");
WiFiManagerParameter custom_pwrMst("Remote Fake-Power controls TCD Fake-Power<br><span>Remote Fake-Power will overrule TFC switch and control TCD Fake-Power. Can be toggled by O.O/RESET if so configured below.</span>", settings.pwrMst, "class='mb0'", WFM_LABEL_AFTER|WFM_IS_CHKBOX);
WiFiManagerParameter custom_refill(wmBuildRefill);

WiFiManagerParameter custom_haveSD(wmBuildHaveSD, WFM_SECTS);
WiFiManagerParameter custom_CfgOnSD("Save secondary settings on SD<br><span>Check this to avoid flash wear</span>", settings.CfgOnSD, "class='mt5'", WFM_LABEL_AFTER|WFM_IS_CHKBOX);
WiFiManagerParameter custom_upd("Show update notifications on power-up", settings.upd, "", WFM_LABEL_AFTER|WFM_IS_CHKBOX);

WiFiManagerParameter custom_oorst(wmBuildOORST, WFM_SECTS);
WiFiManagerParameter custom_oott(wmBuildOOTT);
WiFiManagerParameter custom_resat(wmBuildRESAT);

WiFiManagerParameter custom_sectstart_hw("User Buttons", WFM_SECTS|WFM_HL);
#ifdef ALLOW_DIS_UB
WiFiManagerParameter custom_dBP("Disable User Buttons", settings.disBPack, "class='mt5'", WFM_LABEL_AFTER|WFM_IS_CHKBOX);
#endif
WiFiManagerParameter custom_b0mt("Button 1 is maintained switch", settings.bPb0Maint, "class='mt5'", WFM_LABEL_AFTER|WFM_IS_CHKBOX);
WiFiManagerParameter custom_b1mt("Button 2 is maintained switch", settings.bPb1Maint, "", WFM_LABEL_AFTER|WFM_IS_CHKBOX);
WiFiManagerParameter custom_b2mt("Button 3 is maintained switch", settings.bPb2Maint, "", WFM_LABEL_AFTER|WFM_IS_CHKBOX);
WiFiManagerParameter custom_b3mt("Button 4 is maintained switch", settings.bPb3Maint, "", WFM_LABEL_AFTER|WFM_IS_CHKBOX);
WiFiManagerParameter custom_b4mt("Button 5 is maintained switch", settings.bPb4Maint, "", WFM_LABEL_AFTER|WFM_IS_CHKBOX);
WiFiManagerParameter custom_b5mt("Button 6 is maintained switch", settings.bPb5Maint, "", WFM_LABEL_AFTER|WFM_IS_CHKBOX);
WiFiManagerParameter custom_b6mt("Button 7 is maintained switch", settings.bPb6Maint, "", WFM_LABEL_AFTER|WFM_IS_CHKBOX);
WiFiManagerParameter custom_b7mt("Button 8 is maintained switch", settings.bPb7Maint, "", WFM_LABEL_AFTER|WFM_IS_CHKBOX);
WiFiManagerParameter custom_b0mtoo("Maintained: Play audio on ON only", settings.bPb0MtO, "title='Check to play audio when switch is in ON position only. If unchecked, audio is played on each flip.' class='mt5 ml20'", WFM_LABEL_AFTER|WFM_IS_CHKBOX);
WiFiManagerParameter custom_b1mtoo("Maintained: Play audio on ON only", settings.bPb1MtO, "class='mt5 ml20'", WFM_LABEL_AFTER|WFM_IS_CHKBOX);
WiFiManagerParameter custom_b2mtoo("Maintained: Play audio on ON only", settings.bPb2MtO, "class='mt5 ml20'", WFM_LABEL_AFTER|WFM_IS_CHKBOX);
WiFiManagerParameter custom_b3mtoo("Maintained: Play audio on ON only", settings.bPb3MtO, "class='mt5 ml20'", WFM_LABEL_AFTER|WFM_IS_CHKBOX);
WiFiManagerParameter custom_b4mtoo("Maintained: Play audio on ON only", settings.bPb4MtO, "class='mt5 ml20'", WFM_LABEL_AFTER|WFM_IS_CHKBOX);
WiFiManagerParameter custom_b5mtoo("Maintained: Play audio on ON only", settings.bPb5MtO, "class='mt5 ml20'", WFM_LABEL_AFTER|WFM_IS_CHKBOX);
WiFiManagerParameter custom_b6mtoo("Maintained: Play audio on ON only", settings.bPb6MtO, "class='mt5 ml20'", WFM_LABEL_AFTER|WFM_IS_CHKBOX);
WiFiManagerParameter custom_b7mtoo("Maintained: Play audio on ON only", settings.bPb7MtO, "class='mt5 ml20'", WFM_LABEL_AFTER|WFM_IS_CHKBOX);

WiFiManagerParameter custom_uPL("Use Futaba power LED", settings.usePwrLED, "class='mt5'", WFM_LABEL_AFTER|WFM_IS_CHKBOX|WFM_SECTS);
WiFiManagerParameter custom_PLD("Power LED on fake power", settings.pwrLEDonFP, "class='mt5 ml20' title='If unchecked, LED follows real power'", WFM_LABEL_AFTER|WFM_IS_CHKBOX);
WiFiManagerParameter custom_uLM("Use Futaba battery level meter", settings.useLvlMtr, "", WFM_LABEL_AFTER|WFM_IS_CHKBOX);
WiFiManagerParameter custom_PMD("Level meter on fake power", settings.LvLMtronFP, "class='mt5 ml20' title='If unchecked, meter follows real power'", WFM_LABEL_AFTER|WFM_IS_CHKBOX|WFM_FOOT);

#ifdef HAVE_PM
WiFiManagerParameter custom_UPM("Battery monitoring/warnings", settings.usePwrMon, "title='If unchecked, no battery-low warnings will be given' class='mt5 mb10'", WFM_LABEL_AFTER|WFM_IS_CHKBOX|WFM_SECTS_HEAD);
WiFiManagerParameter custom_bty(wmBuildBatType);  // batt type
WiFiManagerParameter custom_bca("Capacity per cell (1000-6000)", settings.batCap, 4, "type='number' min='1000' max='6000' autocomplete='off'", WFM_LABEL_BEFORE|WFM_FOOT);
#endif

// HA/MQTT Settings

#ifdef HAVE_MQTT
WiFiManagerParameter custom_useMQTT("Home Assistant support (MQTT)", settings.useMQTT, "class='mt5 mb10'", WFM_LABEL_AFTER|WFM_IS_CHKBOX|WFM_SECTS_HEAD);
WiFiManagerParameter custom_state(wmBuildMQTTstate);
WiFiManagerParameter custom_mqttServer("Broker IP[:port] or domain[:port]", settings.mqttServer, 79, "pattern='[a-zA-Z0-9\\.:\\-]+' placeholder='Example: 192.168.1.5'");
WiFiManagerParameter custom_mqttVers(wmBuildMQTTprot);
#ifndef HAVE_MQTT_MP
WiFiManagerParameter custom_mqttUser("User[:Password]", settings.mqttUser, 63, "placeholder='Example: ronald:mySecret' class='mb15'", WFM_LABEL_BEFORE|WFM_FOOT);
#else
WiFiManagerParameter custom_mqttUser("User[:Password]", settings.mqttUser, 63, "placeholder='Example: ronald:mySecret' class='mb15'", WFM_LABEL_BEFORE);
WiFiManagerParameter custom_pubMP("Publish Music Player status to bttf/remote/mpstatus", settings.pubMP, "class='mt5'", WFM_LABEL_AFTER|WFM_IS_CHKBOX|WFM_SECTS|WFM_FOOT);
#endif
WiFiManagerParameter custom_mqtttm(wmBuildMQTTTM);
#endif // HAVEMQTT

static const int8_t wifiMenu[] = {
    WM_MENU_WIFI,
    WM_MENU_PARAM,
    #ifdef HAVE_MQTT
    WM_MENU_PARAM2,
    #endif
    #ifdef HAVE_CRSF
    WM_MENU_PARAM3,
    #endif
    WM_MENU_SEP_F,
    WM_MENU_UPDATE,
    WM_MENU_SEP,
    WM_MENU_CUSTOM,
    WM_MENU_END
};
#define TC_MENUSIZE (sizeof(wifiMenu) / sizeof(wifiMenu[0]))
#ifdef HAVE_CRSF
static const int8_t wifiMenuNoCRSF[] = {
    WM_MENU_WIFI,
    WM_MENU_PARAM,
    #ifdef HAVE_MQTT
    WM_MENU_PARAM2A,
    #endif
    WM_MENU_SEP_F,
    WM_MENU_UPDATE,
    WM_MENU_SEP,
    WM_MENU_CUSTOM,
    WM_MENU_END
};
#define TC_MENUSIZE_NOCRSF (sizeof(wifiMenuNoCRSF) / sizeof(wifiMenuNoCRSF[0]))
#endif

#define AA_TITLE "DTM Remote"
#define AA_ICON "iVBORw0KGgoAAAANSUhEUgAAABAAAAAQBAMAAADt3eJSAAAAFVBMVEVJSkrMy8e2v70AAADa5ePyJT320zT0Sr0YAAAAQElEQVQI12MQhAIGAQYwYAQzHFAZTEoKUEYalMFsDAIghhIQKDMyiAaDGSARZSMlYxAjGMZASIEZCO1wS+HOAADWkAscxWroAQAAAABJRU5ErkJggg=="
#define AA_CONTAINER "REMA"
#define UNI_VERSION REMOTE_VERSION 
#define UNI_VERSION_EXTRA REMOTE_VERSION_EXTRA
#define WEBHOME "remote"
#define CURRVERSION RM_VERSION_REV
static const char apName[] = "REM-AP";

static const char myTitle[] = AA_TITLE;
static const char myHead[]  = "<link rel='icon' type='image/png' href='data:image/png;base64," AA_ICON "'><script>window.onload=function(){xxx='" AA_TITLE "';yyy='?';wr=ge('wrap');if(wr){aa=ge('h3');if(aa){yyy=aa.innerHTML;aa.remove();dlel('h1')}zz=(Math.random()>0.8);dd=document.createElement('div');dd.classList.add('tpm0');dd.innerHTML='<div class=\"tpm\" onClick=\"shsp(1);window.location=\\'/\\'\"><div class=\"tpm2\"><img id=\"spi\" src=\"data:image/png;base64,iVBORw0KGgoAAAANSUhEUgAAAEAAAABAAQMAAACQp+OdAAAABlBMVEUAAABKnW0vhlhrAAAAAXRSTlMAQObYZgAAA'+(zz?'GBJREFUKM990aEVgCAABmF9BiIjsIIbsJYNRmMURiASePwSDPD0vPT12347GRejIfaOOIQwigSrRHDKBK9CCKoEqQF2qQMOSQAzEL9hB9ICNyMv8DPKgjCjLtAD+AV4dQM7O4VX9m1RYAAAAABJRU5ErkJggg==':'HtJREFUKM990bENwyAUBuFnuXDpNh0rZIBIrJUqMBqjMAIlBeIihQIF/fZVX39229PscYG32esCzeyjsXUzNHZsI0ocxJ0kcZIOsoQjnxQJT3FUiUD1NAloga6wQQd+4B/7QBQ4BpLAOZAn3IIy4RfUibCgTTDq+peG6AvsL/jPTu1L9wAAAABJRU5ErkJggg==')+'\" class=\"tpm3\"></div><H1 class=\"tpmh1\"'+(zz?' style=\"margin-left:1.4em\"':'')+'>'+xxx+'</H1>'+'<H3 class=\"tpmh3\"'+(zz?' style=\"padding-left:5em\"':'')+'>'+yyy+'</div></div>';wr.insertBefore(dd,wr.firstChild);wr.style.position='relative'}var lc=ge('lc');if(lc){lc.style.transform='rotate('+(358+[0,1,3,4,5][Math.floor(Math.random()*4)])+'deg)'}}</script><style>H1{font-family:Bahnschrift,-apple-system,'Segoe UI Semibold',Roboto,'Helvetica Neue',Arial,Verdana,sans-serif;margin:0;text-align:center;}H3{margin:0 0 5px 0;text-align:center;}input{border:thin inset}em > small{display:inline}form{margin-block-end:0;}.tpm{background-color:#fff;cursor:pointer;border:1px solid black;border-radius:5px;padding:0 0 0 0px;min-width:18em;}.tpm2{position:absolute;top:-0.7em;z-index:130;left:0.7em;}.tpm3{width:4em;height:4em;}.tpmh1{font-variant-caps:all-small-caps;font-weight:normal;margin-left:2.2em;overflow:clip;}.tpmh3{background:#000;font-size:0.6em;color:#ffa;padding-left:7.2em;margin-left:0.5em;margin-right:0.5em;border-radius:5px;overflow:hidden;white-space:nowrap}.tpm0{position:relative;width:20em;padding:5px 0px 5px 0px;margin:0 auto 0 auto;}.cmp0{margin:0;padding:0;}.sel0{font-size:90%;width:auto;margin-left:10px;vertical-align:baseline;}.mt5{margin-top:5px!important}.mb10{margin-bottom:10px!important}.mb0{margin-bottom:0px!important}.mb15{margin-bottom:15px!important}.ml20{margin-left:20px}.ss>label span{font-size:80%}</style>";
static const char *myCustMenu = "<a href='https://circuitsetup.us' target=_blank><img style='display:block;margin:10px auto 5px auto;' src='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'></a><div style='font-size:0.75em;line-height:1.2em;font-weight:bold;text-align:center;text-transform:uppercase'>" UNI_VERSION " (" UNI_VERSION_EXTRA ")<br>Powered by <a href='https://out-a-ti.me' target=_blank>A10001986</a> <a href='https://" WEBHOME ".out-a-ti.me' target=_blank>[Home/Updates]</a></div>";
static const char r_link[]  = WEBHOME "r.out-a-ti.me";

static char newversion[8];
static unsigned long lastUpdateCheck = 0;
static unsigned long lastUpdateLiveCheck = 0;

#define WLA_IP           1
#define WLA_DEL_IP       2
#define WLA_WIFI         4
#define WLA_SET1         8
#define WLA_SET1_B          3
#define WLA_SET2        16
#define WLA_SET2_B          4
#define WLA_SET3        32
#define WLA_SET3_B          5
#define WLA_SET_CM      64
#define WLA_SET_CM_ON  128
#define WLA_SET        (WLA_WIFI|WLA_SET1|WLA_SET2|WLA_SET3)
#define WLA_ANY        (WLA_IP|WLA_DEL_IP|WLA_SET)
static uint32_t wifiLoopSaveAction = 0;

bool carMode                  = false;
static bool wifiHaveSTAConf   = false;
static bool connectedToTCDAP  = false;
static bool stayInAPMode      = false;  // CRSF only

// WiFi power management in AP mode
bool          wifiInAPMode = false;
bool          wifiAPIsOff = false;
unsigned long wifiAPModeNow;
unsigned long wifiAPOffDelay = 0;     // default: never
static bool   wifiReactAPOnFP = true;

// WiFi power management in STA mode
bool          wifiIsOff = false;
unsigned long wifiOnNow = 0;
unsigned long wifiOffDelay     = 0;   // default: never
unsigned long origWiFiOffDelay = 0;
static bool   wifiReconOnFP = true;

static File acFile;
static bool haveACFile = false;
static bool haveAC = false;
static int  numUploads = 0;
static int  *ACULerr = NULL;
static int  *opType = NULL;

#ifdef HAVE_MQTT
#define MQTT_SHORT_INT (30*1000)
#define MQTT_LONG_INT  (5*60*1000)
static const char    emptyStr[1] = { 0 };
static char          mqnmt[] = "haXt";
static char          mqnmo[] = "haXo";
static char          mqnmf[] = "haXf";
bool                 useMQTT = false;
static char          *mqttUser = (char *)emptyStr;
static char          *mqttPass = (char *)emptyStr;
static char          *mqttServer = (char *)emptyStr;
static unsigned long mqttReconnectNow = 0;
static unsigned long mqttReconnectInt = MQTT_SHORT_INT;
static uint16_t      mqttReconnFails = 0;
static bool          mqttSubAttempted = false;
static bool          mqttOldState = true;
static bool          mqttDoPing = true;
static bool          mqttRestartPing = false;
static bool          mqttPingDone = false;
static unsigned long mqttPingNow = 0;
static unsigned long mqttPingInt = MQTT_SHORT_INT;
static uint16_t      mqttPingsExpired = 0;
#ifdef HAVE_MQTT_MP
bool                 pubMP = false;
#endif
#endif

static unsigned int wmLenBuf = 0;

static void wifiConnect(bool APonly = false, bool deferConfigPortal = false);
static void wifiOff(bool force);

static void checkForUpdate();

static bool saveParamsCallback(int);
static void saveWiFiCallback(const char *ssid, const char *pass, const char *bssid);
static void preUpdateCallback();
static void postUpdateCallback(bool);
static void wifiDelayReplacement(unsigned int mydel);
static void gpCallback(int);
static bool preWiFiScanCallback();
static void setCMCallback(bool enable);

static void updateConfigPortalValues();

static const char *wmBuildSelect(const char *dest, int op, const char * const *src, int count, char *setting, bool indent = false);

static IPAddress stringToIp(char *str);

static void getServerParam(const char *name, char *destBuf, size_t length, int minval, int maxval, int defaultVal);
static bool myisspace(char mychar);
static char *strcpytrim(char* destination, const char* source, bool doFilter = false);
static char *strcpytrimMAC(char* destination, const char* source);
static void mystrcpy(char *sv, WiFiManagerParameter *el);
static void mystrcpyWiFiDelay(char *sv, WiFiManagerParameter *el);
static void evalCB(char *sv, WiFiManagerParameter *el);
static void setCBVal(WiFiManagerParameter *el, char *sv);

static void setupWebServerCallback();
static void handleUploadDone();
static void handleUploading();
static void handleUploadDone();

#ifdef HAVE_MQTT
static void strcpyutf8(char *dst, const char *src, unsigned int len);
static void handleMQTTTopMsg(int idx);
static void mqttPing();
static bool mqttReconnect(bool force = false);
static void mqttLooper();
static void mqttCallback(char *topic, byte *payload, unsigned int length);
static void mqttSubscribe();
#endif

#ifdef HAVE_CRSF
#include "src/CRSF/crsf_wifi.h"
#endif


/*
 * wifi_setup()
 *
 */
void wifi_setup()
{
    int temp;

    WiFiManagerParameter *wifiParmArray[] = {

      &custom_asel,
      
      &custom_sectstart_cm,
      &custom_cmhint,
      &custom_ssidcm,
      &custom_tcdssid,
      &custom_passcm,
      &custom_tcdpw,
      &custom_bssidcm,
      &custom_ecm,
      
      &custom_hostName,

      &custom_sectstart_wifi,
      &custom_wifiConRetries,
      &custom_reconAtmp,

      &custom_sectstart_ap,
      &custom_sysID,
      &custom_appw,
      &custom_apch,
      &custom_bapch,
      &custom_wifiAPOffDelay,
      &custom_reactAP,

      NULL
    };

    WiFiManagerParameter *parmArray[] = {

      &custom_hsel,
      
      &custom_at,             // 6
      &custom_coast,
      &custom_sStrict,
      &custom_tut,
      &custom_playclick,
      &custom_playALSnd,
      &custom_dTCDS,
  
      &custom_sectstart_mp,   // 2
      &custom_musicFolder,
  
      &custom_sectstart_nw,   // 4
      &custom_tcdIP,
      &custom_pwrMst,
      &custom_refill,
      
      &custom_haveSD,         // 3(4)
      &custom_CfgOnSD,
      &custom_upd,

      &custom_oorst,
      &custom_oott,
      &custom_resat,
  
      &custom_sectstart_hw,  // 18
      #ifdef ALLOW_DIS_UB
      &custom_dBP,
      #endif
      &custom_b0mt,
      &custom_b0mtoo,
      &custom_b1mt,
      &custom_b1mtoo,
      &custom_b2mt,
      &custom_b2mtoo,
      &custom_b3mt,
      &custom_b3mtoo,
      &custom_b4mt,
      &custom_b4mtoo,
      &custom_b5mt,
      &custom_b5mtoo,
      &custom_b6mt,
      &custom_b6mtoo,
      &custom_b7mt,
      &custom_b7mtoo,
  
      &custom_uPL,          // 4
      &custom_PLD,
      &custom_uLM,
      &custom_PMD,

      NULL
    };

    #ifdef HAVE_MQTT
    WiFiManagerParameter *parm2Array[] = {

      &custom_useMQTT,    // 5
      &custom_state,
      &custom_mqttServer,
      &custom_mqttVers,
      &custom_mqttUser,

      #ifdef HAVE_MQTT_MP
      &custom_pubMP,
      #endif

      &custom_mqtttm,

      NULL
    };
    #endif

    // No carMode if no CM SSID
    if(!*settings.cm_ssid) carMode = false;

    // No carMode if in CRSF-stayInAPMode mode
    #ifdef HAVE_CRSF
    if(haveNewBoard && opModeCRSF) {
        if((stayInAPMode = !evalBool(settings.crsfap))) carMode = false;
    }
    #endif

    // Transition from NVS-saved data to own management:
    if(!settings.ssid[0] && settings.ssid[1] == 'X') {
        
        // Read NVS-stored WiFi data
        wm.getStoredCredentials(settings.ssid, sizeof(settings.ssid), settings.pass, sizeof(settings.pass));

        #ifdef REMOTE_DBG
        Serial.printf("WiFi Transition: ssid '%s' pass '%s'\n", settings.ssid, settings.pass);
        #endif

        write_settings();
    }

    wm.setHostname(settings.hostName);

    wm.showUploadContainer(haveSD, AA_CONTAINER, rspv, haveAudioFiles);

    wm.setSaveWiFiCallback(saveWiFiCallback);
    wm.setSaveParamsCallback(saveParamsCallback);
    wm.setPreOtaUpdateCallback(preUpdateCallback);
    wm.setPostOtaUpdateCallback(postUpdateCallback);
    wm.setWebServerCallback(setupWebServerCallback);
    wm.setDelayReplacement(wifiDelayReplacement);
    wm.setGPCallback(gpCallback);
    wm.setPreWiFiScanCallback(preWiFiScanCallback);

    // Our style-overrides, the page title
    wm.setCustomHeadElement(myHead);
    wm.setTitle(myTitle);

    // Hack version number into WiFiManager main page
    wm.setCustomMenuHTML(myCustMenu);

    wm.setCCarMode(carMode);
    wm.setCCarModeCallback(setCMCallback);

    temp = atoi(settings.apChnl);
    if(temp < 0) temp = 0;
    else if(temp > 11) temp = 11;
    if(!temp) temp = random(1, 11);
    wm.setWiFiAPChannel(temp);

    temp = atoi(settings.wifiConRetries);
    if(temp < 1) temp = 1;
    else if(temp > 10) temp = 10;
    wm.setConnectRetries(temp);

    wifiReconOnFP = evalBool(settings.reconOnFP);
    wifiReactAPOnFP = evalBool(settings.reactAPOnFP);

    #ifdef HAVE_CRSF
    if(haveNewBoard) {
        wm.setMenu(wifiMenu, TC_MENUSIZE, false);
    } else {
        wm.setMenu(wifiMenuNoCRSF, TC_MENUSIZE_NOCRSF, false);
    }
    #else
    wm.setMenu(wifiMenu, TC_MENUSIZE, false);
    #endif

    // WiFi Settings
    wm.allocParms(WM_PARM_WIFI, (sizeof(wifiParmArray) / sizeof(WiFiManagerParameter *)) - 1);
    temp = 0;
    while(wifiParmArray[temp]) {
        wm.addParameter(WM_PARM_WIFI, wifiParmArray[temp]);
        temp++;
    }

    // Settings
    temp = (sizeof(parmArray) / sizeof(WiFiManagerParameter *)) - 1;
    #ifdef HAVE_PM
    if(havePwrMon) temp += 3;
    #endif
    wm.allocParms(WM_PARM_SETTINGS, temp);
    temp = 0;
    while(parmArray[temp]) {
        wm.addParameter(WM_PARM_SETTINGS, parmArray[temp]);
        temp++;
    }
    #ifdef HAVE_PM
    if(havePwrMon) {
        wm.addParameter(WM_PARM_SETTINGS, &custom_UPM);
        wm.addParameter(WM_PARM_SETTINGS, &custom_bty);
        wm.addParameter(WM_PARM_SETTINGS, &custom_bca);
    }
    #endif

    // HA/MQTT
    #ifdef HAVE_MQTT
    wm.allocParms(WM_PARM_SETTINGS2, (sizeof(parm2Array) / sizeof(WiFiManagerParameter *)) - 1);
    temp = 0;
    while(parm2Array[temp]) {
        wm.addParameter(WM_PARM_SETTINGS2, parm2Array[temp]);
        temp++;
    }
    #endif

    #ifdef HAVE_CRSF
    if(haveNewBoard) {
        wm.allocParms(WM_PARM_SETTINGS3, (sizeof(crsfParmArray) / sizeof(WiFiManagerParameter *)) - 1);
        temp = 0;
        while(crsfParmArray[temp]) {
            wm.addParameter(WM_PARM_SETTINGS3, crsfParmArray[temp]);
            temp++;
        }
    }
    #endif

    // WiFiParameters were initialized before settings were loaded.
    // Update them to current values now.
    updateConfigPortalValues();

    #ifdef HAVE_MQTT
    useMQTT = evalBool(settings.useMQTT);
    #endif

    // stayInAPMode means carMode=false, wifiHaveSTAConf=false

    if(!stayInAPMode) {
      
        wifiHaveSTAConf = carMode ? true : (settings.ssid[0] != 0);
    
        // See if we have a configured WiFi network to connect to.
        // If we detect "TCD-AP" as the SSID, we make sure that we retry
        // at least 2 times so we have a chance to catch the TCD's AP if 
        // both are powered up at the same time.
        if(wifiHaveSTAConf) {
            if(carMode || !strncmp("TCD-AP", settings.ssid, 6)) {
                if(wm.getConnectRetries() < 2) {
                    wm.setConnectRetries(2);
                }
                #ifdef HAVE_MQTT
                useMQTT = false;
                #endif
                connectedToTCDAP = true;
                // Unlike the other props, we don't
                // need a delay here, the Remote is
                // not powered up together with the
                // other props.
            }
        } else {
            // No point in retry when we have no WiFi config'd
            wm.setConnectRetries(1);
        }
    }

    // No WiFi powersave features for STA mode here
    wifiOffDelay = origWiFiOffDelay = 0;

    // Eval AP-mode powersave delay
    wifiAPOffDelay = (unsigned long)atoi(settings.wifiAPOffDelay);
    if(wifiAPOffDelay > 0 && wifiAPOffDelay < 10) wifiAPOffDelay = 10;
    wifiAPOffDelay *= (60 * 1000);
    
    // Configure static IP
    if(loadIpSettings()) {
        if(checkIPConfig() && !carMode) {
            IPAddress ip = stringToIp(ipsettings.ip);
            IPAddress gw = stringToIp(ipsettings.gateway);
            IPAddress sn = stringToIp(ipsettings.netmask);
            IPAddress dns = stringToIp(ipsettings.dns);
            wm.setSTAStaticIPConfig(ip, gw, sn, dns);
        }
    }

    // Connect, but defer starting the CP
    wifiConnect(stayInAPMode, true);

    checkForUpdate();

#ifdef HAVE_MQTT
    if((!settings.mqttServer[0]) || // No server -> no MQTT
       #ifdef HAVE_CRSF
       (opModeCRSF && !opModePropCRSF && !crsfLocalActionsEnabled()) || // Local button callbacks use configured MQTT
       #endif
       (wifiInAPMode))              // WiFi in AP mode -> no MQTT
        useMQTT = false;  
    
    if(useMQTT) {

        uint16_t mqttPort = 1883;
        char *t;
        int tt;

        if((t = strchr(settings.mqttServer, ':'))) {
            size_t ts = (t - settings.mqttServer) + 1;
            mqttServer = (char *)malloc(ts);
            memset(mqttServer, 0, ts);
            strncpy(mqttServer, settings.mqttServer, t - settings.mqttServer);
            tt = atoi(t + 1);
            if(tt > 0 && tt <= 65535) {
                mqttPort = tt;
            }
        } else {
            mqttServer = settings.mqttServer;
        }

        if(isIp(mqttServer)) {
            mqttClient.setServer(stringToIp(mqttServer), mqttPort);
        } else {
            IPAddress remote_addr;
            if(WiFi.hostByName(mqttServer, remote_addr)) {
                mqttClient.setServer(remote_addr, mqttPort);
            } else {
                /*
                mqttClient.setServer(mqttServer, mqttPort);
                // Disable PING if we can't resolve domain
                mqttDoPing = false;
                */
                useMQTT = false;
                mqttReconnFails = 1; // Abuse for "resolv error"
                Serial.printf("MQTT: Failed to resolve '%s'\n", mqttServer);
            }
        }

        #ifdef REMOTE_DBG
        Serial.printf("MQTT: server '%s' port %d\n", mqttServer, mqttPort);
        #endif
    }

    if(useMQTT) {

        char *t;

        #ifdef HAVE_MQTT_MP
        pubMP = evalBool(settings.pubMP);
        #endif

        // No WiFi power save if we're using MQTT
        origWiFiOffDelay = wifiOffDelay = 0;

        mqttClient.setBufferSize(MQTT_MAX_PACKET_SIZE);
        mqttClient.setVersion(atoi(settings.mqttVers) > 0 ? 5 : 3);
        mqttClient.setClientID(settings.hostName);

        mqttClient.setCallback(mqttCallback);
        mqttClient.setLooper(mqttLooper);
        #ifdef HAVE_CRSF
        mqttWClient.setCooperative(opModeCRSF);
        mqttWClient.setLooper(mqttLooper);
        #endif

        if(*settings.mqttUser) {
            if((t = strchr(settings.mqttUser, ':'))) {
                size_t ts = strlen(settings.mqttUser) + 1;
                mqttUser = (char *)malloc(ts);
                strcpy(mqttUser, settings.mqttUser);
                mqttUser[t - settings.mqttUser] = 0;
                mqttPass = mqttUser + (t - settings.mqttUser + 1);
            } else {
                mqttUser = settings.mqttUser;
            }
        }

        #ifdef REMOTE_DBG
        Serial.printf("MQTT: user '%s' pass '%s'\n", mqttUser, mqttPass);
        #endif
            
        mqttReconnect(true);
        // Rest done in loop
            
    } else {

        #ifdef REMOTE_DBG
        Serial.println("MQTT: Disabled");
        #endif

    }
#endif

    if(WiFi.status() == WL_CONNECTED) {

        // Start the Config Portal
        wifiStartCP();

        // Marry us to the current TCD in carMode
        if(carMode && !*settings.cm_bssid) {
            uint8_t *tcdbssid = WiFi.BSSID();
            if(tcdbssid) {
                #ifdef REMOTE_DBG
                Serial.printf("Now married to TCD with BSSID %02x:%02x:%02x:%02x:%02x:%02x\n", 
                    tcdbssid[0], tcdbssid[1], tcdbssid[2], tcdbssid[3], tcdbssid[4], tcdbssid[5]);
                #endif
                sprintf(settings.cm_bssid, "%02x:%02x:%02x:%02x:%02x:%02x",
                    tcdbssid[0], tcdbssid[1], tcdbssid[2], tcdbssid[3], tcdbssid[4], tcdbssid[5]);
                write_settings();
            }
        }
    }

    wifiSetupDone = true;
}

static void setBool(char c, bool& b)
{
    if(c == '1') {
        b = true;
    } else if(c == '0') {
        b = false;
    }
} 

/*
 * wifi_loop()
 *
 */
void wifi_loop()
{
    char oldCfgOnSD = 0;

#ifdef HAVE_MQTT
    if(useMQTT) {
        if(mqttClient.state() != MQTT_CONNECTING) {
            if(!mqttClient.connected()) {
                if(mqttOldState || mqttRestartPing) {
                    // Disconnection first detected:
                    mqttPingDone = mqttDoPing ? false : true;
                    mqttPingNow = mqttRestartPing ? millisNonZero() : 0;
                    mqttOldState = false;
                    mqttRestartPing = false;
                    mqttSubAttempted = false;
                }
                if(mqttDoPing && !mqttPingDone) {
                    audio_loop();
                    mqttPing();
                    audio_loop();
                }
                if(mqttPingDone) {
                    audio_loop();
                    mqttReconnect();
                    audio_loop();
                }
            } else {
                // Only call Subscribe() if connected
                mqttSubscribe();
                mqttOldState = true;
            }
        }
        mqttClient.loop();
    }
#endif

    if(millis() - lastUpdateCheck > 24*60*60*1000) {
        if((!(csf & (CSF_TCDINP0|CSF_TT|CSF_CALIBMD|CSF_KEEPCOUNTING))) && !remBusy && !blockScan && !throttlePos) {
            if(checkAudioReallyDone()) {
                checkForUpdate();
            }
        }
    }

    if(wifiLoopSaveAction & WLA_SET_CM) {
        bool ocm = carMode;
        carMode = !!(wifiLoopSaveAction & WLA_SET_CM_ON);
        if(!*settings.cm_ssid) carMode = false;
        if(carMode != ocm) {
            remBusy = 1;  // Force MP "off" state
            mp_stop(true);
            stopAudio();
            saveCarMode();
            if(!(wifiLoopSaveAction & WLA_SET)) {
                prepareReboot();
                delay(1000);
                esp_restart();
            }
        }
        wifiLoopSaveAction &= ~(WLA_SET_CM|WLA_SET_CM_ON);
    }


    if(wifiLoopSaveAction & WLA_SET) {

        int temp;
        bool write_main_settings = false;

        remBusy = 1;  // Force MP "off" state
        mp_stop(true);
        stopAudio();

        // Save settings and restart esp32

        #ifdef REMOTE_DBG
        Serial.println("Config Portal: Saving config");
        #endif

        if(wifiLoopSaveAction & WLA_WIFI) {

            // Parameters on WiFi Config page
            // Note: Parameters that need to be grabbed from the server directly
            // through getServerParam() must be handled in saveWiFiCallback().

            if(wifiLoopSaveAction & WLA_IP) {
                #ifdef REMOTE_DBG
                Serial.println("WiFi: Saving IP config");
                #endif
                writeIpSettings();
            } else if(wifiLoopSaveAction & WLA_DEL_IP) {
                #ifdef REMOTE_DBG
                Serial.println("WiFi: Deleting IP config");
                #endif
                deleteIpSettings();
            }

            // ssid, pass copied to settings in saveWiFiCallback()

            strcpytrim(settings.cm_ssid, custom_ssidcm.getValue(), true);
            strcpytrim(settings.cm_pass, custom_passcm.getValue(), true);
            strcpytrimMAC(settings.cm_bssid, custom_bssidcm.getValue());

            if(*settings.cm_ssid) {
                evalCB(settings.ecmKludge, &custom_ecm);
                carMode = evalBool(settings.ecmKludge);
                saveCarMode();
            }
            
            strcpytrim(settings.hostName, custom_hostName.getValue(), true);
            if(!*settings.hostName) {
                strcpy(settings.hostName, DEF_HOSTNAME);
            } else {
                char *s = settings.hostName;
                for ( ; *s; ++s) *s = tolower(*s);
            }
            mystrcpy(settings.wifiConRetries, &custom_wifiConRetries);
            evalCB(settings.reconOnFP, &custom_reconAtmp);
            
            strcpytrim(settings.systemID, custom_sysID.getValue(), true);
            strcpytrim(settings.appw, custom_appw.getValue(), true);
            if((temp = strlen(settings.appw)) > 0) {
                if(temp < 8) {
                    settings.appw[0] = 0;
                }
            }
            mystrcpyWiFiDelay(settings.wifiAPOffDelay, &custom_wifiAPOffDelay);
            evalCB(settings.reactAPOnFP, &custom_reactAP);

            write_main_settings = true;

        } else if(wifiLoopSaveAction & WLA_SET1) {

            // Parameters on Settings page
            // Note: Parameters that need to be grabbed from the server directly
            // through getServerParam() must be handled in saveParamsCallback()

            // Extract settings saved only as secSettings
            evalCB(settings.movieMode, &custom_sStrict);
            setBool(settings.movieMode[0], movieMode);
            evalCB(settings.dtcds, &custom_dTCDS);
            setBool(settings.dtcds[0], displayTCDSMode);
            evalCB(settings.upd, &custom_upd);
            setBool(settings.upd[0], showUpdAvail);
            saveAllSecCP();

            // Handle settings also saved as terSettings (except MF, only terSetting)
            if(haveSD) {
                if(*settings.musicFolder) {
                    temp = atoi(settings.musicFolder);
                    if(temp >= 0 && temp <= 9) {
                        musFolderNum = temp;
                    }
                }
            }
            evalCB(settings.autoThrottle, &custom_at);
            evalCB(settings.coast, &custom_coast);
            evalCB(settings.pwrMst, &custom_pwrMst);
            setBool(settings.autoThrottle[0], autoThrottle);
            setBool(settings.coast[0], doCoast);
            setBool(settings.pwrMst[0], powerMaster);
            updateVisMode();
            saveAllTerCP();

            evalCB(settings.playClick, &custom_playclick);
            evalCB(settings.playALsnd, &custom_playALSnd);

            strcpytrim(settings.tcdIP, custom_tcdIP.getValue());
            if(*settings.tcdIP) {
                char *s = settings.tcdIP;
                for ( ; *s; ++s) *s = tolower(*s);
            }
            // pwrMaster saved above
            
            oldCfgOnSD = settings.CfgOnSD[0];
            evalCB(settings.CfgOnSD, &custom_CfgOnSD);

            #ifdef ALLOW_DIS_UB
            evalCB(settings.disBPack, &custom_dBP);
            #endif
            evalCB(settings.bPb0Maint, &custom_b0mt);
            evalCB(settings.bPb1Maint, &custom_b1mt);
            evalCB(settings.bPb2Maint, &custom_b2mt);
            evalCB(settings.bPb3Maint, &custom_b3mt);
            evalCB(settings.bPb4Maint, &custom_b4mt);
            evalCB(settings.bPb5Maint, &custom_b5mt);
            evalCB(settings.bPb6Maint, &custom_b6mt);
            evalCB(settings.bPb7Maint, &custom_b7mt);

            evalCB(settings.bPb0MtO, &custom_b0mtoo);
            evalCB(settings.bPb1MtO, &custom_b1mtoo);
            evalCB(settings.bPb2MtO, &custom_b2mtoo);
            evalCB(settings.bPb3MtO, &custom_b3mtoo);
            evalCB(settings.bPb4MtO, &custom_b4mtoo);
            evalCB(settings.bPb5MtO, &custom_b5mtoo);
            evalCB(settings.bPb6MtO, &custom_b6mtoo);
            evalCB(settings.bPb7MtO, &custom_b7mtoo);

            evalCB(settings.usePwrLED, &custom_uPL);
            evalCB(settings.pwrLEDonFP, &custom_PLD);
            evalCB(settings.useLvlMtr, &custom_uLM);
            evalCB(settings.LvLMtronFP, &custom_PMD);
            
            #ifdef HAVE_PM
            if(havePwrMon) {
                evalCB(settings.usePwrMon, &custom_UPM);
                mystrcpy(settings.batCap, &custom_bca);
            }
            #endif

            // Copy secondary settings to other medium if
            // user changed respective option
            if(oldCfgOnSD != settings.CfgOnSD[0]) {
                moveSettings();
            }

            write_main_settings = true;

        } else if(wifiLoopSaveAction & WLA_SET2) {

            // Parameters on HA/MQTT Settings page
            // Note: Parameters that need to be grabbed from the server directly
            // through getServerParam() must be handled in saveParamsCallback()

            #ifdef HAVE_MQTT
            evalCB(settings.useMQTT, &custom_useMQTT);
            strcpytrim(settings.mqttServer, custom_mqttServer.getValue());
            strcpyutf8(settings.mqttUser, custom_mqttUser.getValue(), sizeof(settings.mqttUser));
            #ifdef HAVE_MQTT_MP
            evalCB(settings.pubMP, &custom_pubMP);
            #endif

            write_mqtt_settings();
            #endif

        } else if(wifiLoopSaveAction & WLA_SET3) {
          
            // Parameters on CRSF/ELRS Settings page
            // Note: Parameters that need to be grabbed from the server directly
            // through getServerParam() must be handled in saveParamsCallback()
            
            #ifdef HAVE_CRSF
            // Input settings were validated and saved before the HTTP response.
            write_main_settings = true;
            #endif
            
        }

        if(write_main_settings) write_settings();

        // Reset esp32 to load new settings
        
        // Unregister from TCD
        bttfn_remote_unregister();
       
        #ifdef REMOTE_DBG
        Serial.println("Config Portal: Restarting ESP....");
        #endif
        Serial.flush();
        
        prepareReboot();
        delay(1000);
        esp_restart();
    }

    // We skip web handling when we're in (csf & CSF_TCDINP0) mode
    // because this is time-critical.
    wm.process((!(csf & CSF_TCDINP0)) || (csf & CSF_OFF));

    // WiFi power management
    // If a delay > 0 is configured, WiFi is powered-down after timer has
    // run out. The timer starts when the device is powered-up/boots.
    // There are separate delays for AP mode and STA mode.
    // WiFi will be re-enabled for the configured time during fake-power on.
    // Skip testing while in (csf & CSF_TCDINP0) mode unless fake-powered-off.
    if((!(csf & CSF_TCDINP0)) || (csf & CSF_OFF)) {
        if(wifiInAPMode) {
            // Disable WiFi in AP mode after a configurable delay (if > 0)
            if(wifiAPOffDelay > 0) {
                if(!wifiAPIsOff && (millis() - wifiAPModeNow >= wifiAPOffDelay)) {
                    if(!WiFi.softAPgetStationNum()) {
                        wifiOff(false);
                        wifiAPIsOff = true;
                        wifiIsOff = false;
                        #ifdef REMOTE_DBG
                        Serial.println("WiFi (AP-mode) switched off (power-save)");
                        #endif
                    } else {
                        wifiAPModeNow += (wifiAPOffDelay / 10);   // Check again later
                    }
                }
            }
        } else {
            // Disable WiFi in STA mode after a configurable delay (if > 0)
            if(origWiFiOffDelay > 0) {
                if(!wifiIsOff && (millis() - wifiOnNow >= wifiOffDelay)) {
                    wifiOff(false);
                    wifiIsOff = true;
                    wifiAPIsOff = false;
                    #ifdef REMOTE_DBG
                    Serial.println("WiFi (STA-mode) switched off (power-save)");
                    #endif
                }
            }
        }
    }

}

static void wifiConnect(bool APonly, bool deferConfigPortal)
{
    char realAPName[16];
    char *mssid, *mpass, *mbssid;
    
    if(carMode) {
        mssid = settings.cm_ssid;
        mpass = settings.cm_pass;
        mbssid = settings.cm_bssid;
    } else {
        mssid = settings.ssid;
        mpass = settings.pass;
        mbssid = settings.bssid;
    }

    strcpy(realAPName, apName);
    if(settings.systemID[0]) {
        strcat(realAPName, settings.systemID);
    }

    // If APonly is true (CRSF), carMode is always false
    if(APonly) {
        wm.startAPModeAndPortal(realAPName, settings.appw, settings.ssid, settings.pass);
    }
    
    // Connect using saved credentials if they exist
    // If connection fails it starts an access point with the specified name
    if(!APonly && wm.wifiConnect(mssid, mpass, mbssid, realAPName, settings.appw)) {
        #ifdef REMOTE_DBG
        Serial.println("WiFi connected");
        #endif

        // We start the CP later
        if(!deferConfigPortal) {
            wm.startWebPortal();
        }

        // Allow modem sleep:
        // WIFI_PS_MIN_MODEM is the default, and activated when calling this
        // with "true". When this is enabled, received WiFi data can be
        // delayed for as long as the DTIM period.
        // Disable modem sleep, don't want delays accessing the CP or
        // with BTTFN/MQTT.
        WiFi.setSleep(false);

        // Set transmit power to max; we might be connecting as STA after
        // a previous period in AP mode.
        #ifdef REMOTE_DBG
        {
            wifi_power_t power = WiFi.getTxPower();
            Serial.printf("WiFi: Max TX power in STA mode %d\n", power);
        }
        #endif
        WiFi.setTxPower(WIFI_POWER_19_5dBm);

        wifiInAPMode = false;
        wifiIsOff = false;
        wifiOnNow = millis();
        wifiAPIsOff = false;  // Sic! Allows checks like if(wifiAPIsOff || wifiIsOff)

    } else {
        #ifdef REMOTE_DBG
        Serial.println("Config portal running in AP-mode");
        #endif

        {
            #ifdef REMOTE_DBG
            int8_t power;
            esp_wifi_get_max_tx_power(&power);
            Serial.printf("WiFi: Max TX power %d\n", power);
            #endif

            // Try to avoid "burning" the ESP when the WiFi mode
            // is "AP" by reducing the max. transmit power.
            // The choices are:
            // WIFI_POWER_19_5dBm    = 19.5dBm
            // WIFI_POWER_19dBm      = 19dBm
            // WIFI_POWER_18_5dBm    = 18.5dBm
            // WIFI_POWER_17dBm      = 17dBm
            // WIFI_POWER_15dBm      = 15dBm
            // WIFI_POWER_13dBm      = 13dBm
            // WIFI_POWER_11dBm      = 11dBm
            // WIFI_POWER_8_5dBm     = 8.5dBm
            // WIFI_POWER_7dBm       = 7dBm     <-- proven to avoid any issues
            // WIFI_POWER_5dBm       = 5dBm
            // WIFI_POWER_2dBm       = 2dBm
            // WIFI_POWER_MINUS_1dBm = -1dBm
            WiFi.setTxPower(WIFI_POWER_7dBm);

            #ifdef REMOTE_DBG
            esp_wifi_get_max_tx_power(&power);
            Serial.printf("WiFi: Max TX power set to %d\n", power);
            #endif
        }

        wifiInAPMode = true;
        wifiAPIsOff = false;
        wifiAPModeNow = millis();
        wifiIsOff = false;    // Sic!

    }
}

void wifiOff(bool force)
{
    if(!force) {
        if( (!wifiInAPMode && wifiIsOff) ||
            (wifiInAPMode && wifiAPIsOff) ) {
            return;
        }
    }

    // Parm for disableWiFi() is "waitForOFF"
    // which should be true if we stop in AP
    // mode and immediately re-connect, without
    // process()ing for a while after this call.
    // "force" is true if we want to try to
    // reconnect after disableWiFi(), false if 
    // we disconnect upon timer expiration, 
    // so it matches the purpose.
    // "false" also does not cause any delays,
    // while "true" may take up to 2 seconds.
    wm.disableWiFi(force);
}

void wifiOn(unsigned long newDelay)
{
    bool doOnlyAP = false;
    unsigned long desiredDelay;
    unsigned long Now = millis();
    
    // wifiON() is called when the user fake-powers off+on.
    //
    // Fake power down/up serves - apart from the actual fake power function -
    // additional two purposes: To re-enable WiFi if in power save mode, and 
    // to re-connect to a configured WiFi network if we failed to connect to 
    // that network at the last connection attempt. In both cases, the Config
    // Portal is started.
    //
    // "wifiInAPMode" only tells us our latest mode; if the configured WiFi
    // network was - for whatever reason - was not available when we
    // tried to (re)connect, "wifiInAPMode" is true.

    // At this point, wifiInAPMode reflects the state after
    // the last connection attempt.

    if(wifiInAPMode) {  // We are in AP mode

        if(!wifiAPIsOff) {

            // If ON but no user-config'd WiFi network or
            // disabled "Reconnect on FP" -> bail
            if(!wifiHaveSTAConf || !wifiReconOnFP) {
                // Best we can do is to restart the AP-PS timer
                // (if user selected "Re-enable AP on FP")
                if(wifiReactAPOnFP) wifiAPModeNow = Now;
                return;
            }

            // If ON and User has config'd a NW and wants reconnection attempts,
            // disable WiFi at this point in hope of successful connection below
            wifiOff(true);

        } else {

            // If OFF (PS), check if user has configured nw & wants reconnection
            // If not, see if user wants AP-reactivation
            // (wifiHaveSTAConf is false in stayInAPMode)
            if(!wifiHaveSTAConf || !wifiReconOnFP) {
                if(wifiReactAPOnFP) doOnlyAP = true;
                else return;
            }
            
        }

    } else {            // We are (or were) in STA mode

        // If WiFi is not off, start CP if not running
        if(!wifiIsOff && (WiFi.status() == WL_CONNECTED)) {
            if(!wm.getWebPortalActive()) {
                wm.startWebPortal();
            }
            // Restart timer
            wifiOnNow = Now;
            return;
        }

        // User does not want reconnection attempts on FP? Bail.
        if(!wifiReconOnFP) return;

    }

    // (Re)connect
    wifiConnect(doOnlyAP);

    // Restart timers
    // Note that wifiInAPMode now reflects the
    // result of our above wifiConnect() call

    if(wifiInAPMode) {

        #ifdef REMOTE_DBG
        Serial.println("wifiOn: in AP mode after connect");
        #endif
      
        wifiAPModeNow = Now;
        
        #ifdef REMOTE_DBG
        if(wifiAPOffDelay > 0) {
            Serial.printf("Restarting WiFi-off timer (AP mode); delay %d\n", wifiAPOffDelay);
        }
        #endif
        
    } else {

        #ifdef REMOTE_DBG
        Serial.println("wifiOn: in STA mode after connect");
        #endif

        if(origWiFiOffDelay) {
            desiredDelay = (newDelay > 0) ? newDelay : origWiFiOffDelay;
            if((Now - wifiOnNow >= wifiOffDelay) ||                    // If delay has run out, or
               (wifiOffDelay - (Now - wifiOnNow))  < desiredDelay) {   // new delay exceeds remaining delay:
                wifiOffDelay = desiredDelay;                           // Set new timer delay, and
                wifiOnNow = Now;                                       // restart timer
                #ifdef REMOTE_DBG
                Serial.printf("Restarting WiFi-off timer; delay %d\n", wifiOffDelay);
                #endif
            }
        }

        if(!lastUpdateLiveCheck || (millis() - lastUpdateLiveCheck > 6*60*60*1000)) {
            checkForUpdate();
        }

    }
}

bool wifiNeedReConnect(bool &blocks)
{
    if(wifiInAPMode) {  // We are in AP mode

        if(!wifiAPIsOff) {

            // If ON, check if nw configured and user wants reconnection attempts
            // (wifiHaveSTAConf is false in stayInAPMode)
            if(!wifiHaveSTAConf || !wifiReconOnFP) {
              
                // No, but user wants to re-activate the AP: We restart timer here. NO.
                if(wifiReactAPOnFP) wifiAPModeNow = millis();
                return false;
            }

        } else {

            // If OFF, check if nw configured and user wants reconnection attempts
            if(!wifiHaveSTAConf || !wifiReconOnFP) {
                
                // No, but user wants to re-activate the AP: YES.
                if(wifiReactAPOnFP) return true;
                
                // User does not want re-activation or re-connection: NO.
                return false;
            }
          
        }

        // We have network & user wants reconnection: YES.
        blocks = true;
        return true;

    } else {            // We are (or were) in STA mode

        // User does not want reconnection attempts on FP? Bail.
        if(!wifiReconOnFP) return false;
          
        if(!wifiIsOff && (WiFi.status() == WL_CONNECTED)) {
            return !wm.getWebPortalActive();
        }

        blocks = true;
        return true;
    }
}

void wifiStartCP()
{
    if(wifiInAPMode || wifiIsOff)
        return;

    wm.startWebPortal();
}

static void checkForUpdate()
{
    int cver = 0, crev = 0, uver = 0, urev = 0;
    bool haveCVer = false;

    *newversion = 0;

    lastUpdateCheck = millis();

    if(connectedToTCDAP || siscanf(CURRVERSION, "V%d.%d", &cver, &crev) != 2) {
        lastUpdateLiveCheck = millisNonZero();
        return;
    }
    
    if(WiFi.status() == WL_CONNECTED) {
        IPAddress remote_addr;
        if(WiFi.hostByName(WEBHOME "v.out-a-ti.me", remote_addr)) {
            if(remote_addr[0] + remote_addr[1] == remote_addr[3]) {
                uver = remote_addr[0]; urev = remote_addr[1];
                if(uver) saveUpdVers(uver, urev);
            }
        }
        lastUpdateLiveCheck = millisNonZero();
    } else {
        loadUpdVers(uver, urev);
    }

    if(uver) {
        haveCVer = true;
        if(((uver << 8) | urev) > ((cver << 8) | crev)) {
            snprintf(newversion, sizeof(newversion), "%d.%02d", uver, urev);
        }
    }

    wm.setDownloadLink(r_link, haveCVer, (*newversion) ? newversion : NULL);
}

bool updateAvailable()
{
    return (*newversion != 0);
}

bool checkIPConfig()
{
    return (*ipsettings.ip            &&
            isIp(ipsettings.ip)       &&
            isIp(ipsettings.gateway)  &&
            isIp(ipsettings.netmask)  &&
            isIp(ipsettings.dns));
}

// This is called when the WiFi config is to be saved. 
// SSID, password and BSSID are copied to settings here.
// Static IP and other parameters are taken from WiFiManager's server.
static void saveWiFiCallback(const char *ssid, const char *pass, const char *bssid)
{
    char ipBuf[20] = "";
    char gwBuf[20] = "";
    char snBuf[20] = "";
    char dnsBuf[20] = "";
    bool invalConf = false;

    #ifdef REMOTE_DBG
    Serial.println("saveConfigCallback");
    #endif

    // clear as strncpy might leave us unterminated
    memset(ipBuf, 0, 20);
    memset(gwBuf, 0, 20);
    memset(snBuf, 0, 20);
    memset(dnsBuf, 0, 20);

    String temp;
    temp.reserve(16);
    if((temp = wm.server->arg(FPSTR(WMS_ip))) != "") {
        strncpy(ipBuf, temp.c_str(), 19);
    } else invalConf |= true;
    if((temp = wm.server->arg(FPSTR(WMS_sn))) != "") {
        strncpy(snBuf, temp.c_str(), 19);
    } else invalConf |= true;
    if((temp = wm.server->arg(FPSTR(WMS_gw))) != "") {
        strncpy(gwBuf, temp.c_str(), 19);
    } else invalConf |= true;
    if((temp = wm.server->arg(FPSTR(WMS_dns))) != "") {
        strncpy(dnsBuf, temp.c_str(), 19);
    } else invalConf |= true;

    #ifdef REMOTE_DBG
    if(strlen(ipBuf) > 0) {
        Serial.printf("IP:%s / SN:%s / GW:%s / DNS:%s\n", ipBuf, snBuf, gwBuf, dnsBuf);
    } else {
        Serial.println("Static IP unset, using DHCP");
    }
    #endif

    if(!invalConf && isIp(ipBuf) && isIp(gwBuf) && isIp(snBuf) && isIp(dnsBuf)) {

        #ifdef REMOTE_DBG
        Serial.println("All IPs valid");
        #endif

        wifiLoopSaveAction |= WLA_IP;
          
        memset((void *)&ipsettings, 0, sizeof(ipsettings));
        strcpy(ipsettings.ip, ipBuf);
        strcpy(ipsettings.gateway, gwBuf);
        strcpy(ipsettings.netmask, snBuf);
        strcpy(ipsettings.dns, dnsBuf);

    } else {

        #ifdef REMOTE_DBG
        if(*ipBuf) {
            Serial.println("Invalid IP");
        }
        #endif

        wifiLoopSaveAction |= WLA_DEL_IP;

    }

    // ssid is the (new?) ssid to connect to, pass the password.
    // (We don't need to compare to the old ones, the settings
    // hash will decide on save/not save.)
    // This is also used to "forget" a saved WiFi network, in
    // which case ssid and pass are empty strings.
    memset(settings.ssid, 0, sizeof(settings.ssid));
    memset(settings.pass, 0, sizeof(settings.pass));
    memset(settings.bssid, 0, sizeof(settings.bssid));
    if(*ssid) {
        strncpy(settings.ssid, ssid, sizeof(settings.ssid) - 1);
        strncpy(settings.pass, pass, sizeof(settings.pass) - 1);
        strncpy(settings.bssid, bssid, sizeof(settings.bssid) - 1);
    }

    #ifdef REMOTE_DBG
    Serial.printf("saveWiFiCallback: New ssid '%s'\n", settings.ssid);
    Serial.printf("saveWiFiCallback: New pass '%s'\n", settings.pass);
    Serial.printf("saveWiFiCallback: New bssid '%s'\n", settings.bssid);
    #endif

    // Other parameters on WiFi Config page that
    // need grabbing directly from the server

    getServerParam("apchnl", settings.apChnl, 2, 0, 11, DEF_AP_CHANNEL);
    
    wifiLoopSaveAction |= WLA_WIFI;
}

// This is the callback from the actual Params page. We read out
// the WM "Settings" parameters and save them.
// paramspage is 1 (Settings), 2 (HA/MQTT), 3 (CRSF)
static bool saveParamsCallback(int paramspage)
{
    switch(paramspage) {
    case 1:
        getServerParam("tut", settings.playTUT, 1, 0, 1, DEF_TUT);
        getServerParam("mfol", settings.musicFolder, 1, 0, 9, 0);
        getServerParam("refb", settings.refBut, 1, 0, 8, DEF_REF_BUT);
        getServerParam("oorst", settings.oorst, 1, 0, 1, DEF_OORST);
        getServerParam("oott", settings.ooTT, 1, 0, 1, DEF_OO_TT);
        getServerParam("resat", settings.resAT, 1, 0, 1, DEF_RES_AT);
        #ifdef HAVE_PM
        if(havePwrMon) {
            getServerParam("bty", settings.batType, 1, 0, 4, DEF_BAT_TYPE);
        }
        #endif
        break;
    case 2:
        #ifdef HAVE_MQTT
        getServerParam("mprot", settings.mqttVers, 1, 0, 1, 0);
        for(int i = 0; i < 8; i++) handleMQTTTopMsg(i);
        #endif
        break;
    case 3: {
        #ifdef HAVE_CRSF
        const auto previousSettings = settings;
        crsf_wifi_saveParamsCallback();
        if(!crsf_wifi_loop_settings()) {
            settings = previousSettings;
            return false;
        }
        #endif
        break;
    }
    }
    wifiLoopSaveAction |= (1 << (paramspage - 1 + WLA_SET1_B));
    return true;
}

// This is called before a firmware updated is initiated.
// Disable WiFi-off-timers, switch off audio, show "wait"
static void preUpdateCallback()
{
    wifiAPOffDelay = 0;
    origWiFiOffDelay = 0;

    remdisplay.blink(false);
    remledStop.setState(false);

    // Unregister from TCD
    bttfn_remote_unregister();

    remBusy = 1;    // Force MP "off" state
    mp_stop(true);
    stopAudio();

    flushDelayedSave();

    showWaitSequence();
    remdisplay.on();
}

// This is called after a firmware updated has finished.
// parm = true of ok, false if error.
static void postUpdateCallback(bool res)
{
    Serial.flush();
    prepareReboot();

    // WM sends a MDNS-good-bye and reboots after 
    // this callback. Since we send the good-bye
    // in prepareReboot(), no point in returning.
    delay(1000);
    esp_restart();
}

static bool preWiFiScanCallback()
{
    // Do not allow a WiFi scan under some circumstances (as
    // it may disrupt sequences)
    
    if((csf & (CSF_TCDINP0|CSF_TT|CSF_CALIBMD|CSF_KEEPCOUNTING)) || blockScan || throttlePos)
        return false;

    return true;
}

static void wifiDelayReplacement(unsigned int mydel)
{
    #ifdef HAVE_CRSF
    if(opModeCRSF) {
        unsigned long startNow = millis();
        while(millis() - startNow < mydel) {
            serviceCRSF(false);
            if(audioInitDone) audio_loop();
            delay(1);
        }
        return;
    }
    #endif
    if((mydel > 30) && audioInitDone) {
        unsigned long startNow = millis();
        while(millis() - startNow < mydel) {
            audio_loop();
            delay(20);
        }
    } else {
        delay(mydel);
    }
}

void gpCallback(int reason)
{
    // Called when WM does stuff that might
    // take some time, like before and after
    // HTTPSend().
    // MUST NOT call wifi_loop() !!!
    
    #ifdef HAVE_CRSF
    if(opModeCRSF) serviceCRSF(false);
    #endif
    if(audioInitDone) {
        switch(reason) {
        case WM_LP_PREHTTPSEND:
        case WM_LP_NONE:
        case WM_LP_POSTHTTPSEND:
            audio_loop();
            break;
        }
    }
}

static void setCMCallback(bool enable)
{
    wifiLoopSaveAction |= WLA_SET_CM;
    if(enable) wifiLoopSaveAction |= WLA_SET_CM_ON;
    else       wifiLoopSaveAction &= ~WLA_SET_CM_ON;
}

// Use this only ahead of reboots.
void wifiMDNSGoodBye()
{
    #ifdef WM_MDNS
    wm.sendMDNSgoodBye();
    #endif
}

static void updateConfigPortalValues()
{
    // Make sure the settings form has the correct values
    wm.updateParameters(WM_PARM_WIFI);
    wm.updateParameters(WM_PARM_SETTINGS);
    #ifdef HAVE_MQTT
    wm.updateParameters(WM_PARM_SETTINGS2);
    #endif
    #ifdef HAVE_CRSF
    if(haveNewBoard) {
        wm.updateParameters(WM_PARM_SETTINGS3);
        crsf_wifi_updateConfigPortalValues();
    }
    #endif
}

static void setBoolAndUpdCB(bool myBool, char *sett, WiFiManagerParameter *wmParm)
{
    sett[0] = myBool ? '1' : '0';
    sett[1] = 0;
    setCBVal(wmParm, sett);
}

void updateConfigPortalVisValues()
{
    setBoolAndUpdCB(autoThrottle, settings.autoThrottle, &custom_at);
    setBoolAndUpdCB(doCoast, settings.coast, &custom_coast);
    setBoolAndUpdCB(powerMaster, settings.pwrMst, &custom_pwrMst);
}

void updateConfigPortalVis2Values()
{
    setBoolAndUpdCB(movieMode, settings.movieMode, &custom_sStrict);
    setBoolAndUpdCB(displayTCDSMode, settings.dtcds, &custom_dTCDS);
}

void updateConfigPortalUpdValues()
{
    setBoolAndUpdCB(showUpdAvail, settings.upd, &custom_upd);
}

static const char *buildBanner(const char *msg, const char *col, int op) 
{   // "%s%s%s%s</div>";
    unsigned int l = STRLEN(bannerStart) + 7 + STRLEN(bannerMid) + strlen(msg) + 6 + 4;

    if(op == WM_CP_LEN) {
        wmLenBuf = l;
        return (const char *)&wmLenBuf;
    }
    
    char *str = (char *)malloc(l);
    sprintf(str, bannerGen, bannerStart, col, bannerMid, msg);        

    return str;
}

static unsigned int calcSelectMenu(const char * const *theHTML, int cnt, char *setting, bool indent = false)
{
    int sr = atoi(setting);

    unsigned int l = 0;

    l += STRLEN(custHTMLHdr1);
    if(indent) l += STRLEN(custHTMLHdrI);
    l += STRLEN(custHTMLHdr2);
    l += strlen(theHTML[0]);
    l += STRLEN(custHTMLSHdr);
    l += strlen(setting);
    l += (STRLEN(custHTMLSelFmt) - (2*2));
    l += (3*strlen(theHTML[1]));
    for(int i = 0; i < cnt - 2; i++) {
        if(sr == i) l += STRLEN(custHTMLSel);
        l += (strlen(theHTML[i+2]) - 2);
        l += strlen((i == cnt - 3) ? osde : ooe);
    }

    return l + 8;
}

static void buildSelectMenu(char *target, const char * const *theHTML, int cnt, char *setting, bool indent = false)
{
    int sr = atoi(setting);

    strcpy(target, custHTMLHdr1);
    if(indent) strcat(target, custHTMLHdrI);
    strcat(target, custHTMLHdr2);
    strcat(target, theHTML[1]);
    strcat(target, theHTML[0]);
    strcat(target, custHTMLSHdr);
    strcat(target, setting);
    sprintf(target + strlen(target), custHTMLSelFmt, theHTML[1], theHTML[1]);
    for(int i = 0; i < cnt - 2; i++) {
        if(sr == i) strcat(target, custHTMLSel);
        sprintf(target + strlen(target), 
            theHTML[i+2], (i == cnt - 3) ? osde : ooe);
    }
}

static const char *wmBuildSelect(const char *dest, int op, const char * const *src, int count, char *setting, bool indent)
{
    if(op == WM_CP_DESTROY) {
        if(dest) free((void *)dest);
        return NULL;
    }

    unsigned int l = calcSelectMenu(src, count, setting, indent);

    if(op == WM_CP_LEN) {
        wmLenBuf = l;
        return (const char *)&wmLenBuf;
    }
    
    char *str = (char *)malloc(l);

    buildSelectMenu(str, src, count, setting, indent);
    
    return str;
}

static unsigned int lengthRadioButtons(const char * const *theHTML, int cnt, char *setting)
{
    unsigned int mysize = STRLEN(rad0) - 2 + strlen(theHTML[0]) + strlen(theHTML[1]) + STRLEN(rad2);
    int i, j = strlen(theHTML[2]), sr = atoi(setting);
    
    for(i = 0; i < cnt; i++) {
        mysize += STRLEN(rad1) - (8*2) + (3*j) + (3*2) + ((i==sr) ? STRLEN(radchk) : 0) + strlen(theHTML[3+i]);
    }
    mysize += STRLEN(rad99);
    mysize += 8;  // safety

    return mysize;
}

static void buildRadioButtons(char *target, const char * const *theHTML, int cnt, char *setting)
{
    int i, sr = atoi(setting);
    
    sprintf(target, rad0, theHTML[0]);
    strcat(target, theHTML[1]);
    strcat(target, rad2);
    
    for(i = 0; i < cnt; i++) {
        sprintf(target+strlen(target), rad1, theHTML[2], i, theHTML[2], i, (i==sr) ? radchk : "", theHTML[2], i, theHTML[3+i]);
    }
    strcat(target, rad99);
}

static const char *wmBuildRadioButtons(const char *dest, int op, const char * const *theHTML, int cnt, char *setting)
{
    if(op == WM_CP_DESTROY) {
        if(dest) free((void *)dest);
        return NULL;
    }

    unsigned int l = lengthRadioButtons(theHTML, cnt, setting);

    if(op == WM_CP_LEN) {
        wmLenBuf = l;
        return (const char *)&wmLenBuf;
    }
    
    char *str = (char *)malloc(l);

    buildRadioButtons(str, theHTML, cnt, setting);
    
    return str;
}

static const char *wmBuildTCDAPList(const char *dest, int op)
{
    if(op == WM_CP_DESTROY) {
        if(dest) free((void *)dest);
        return NULL;
    }

    unsigned int l = STRLEN(tcdList) + 4 + (bttfnHaveTCDSSID ? strlen(TCDSSID) : 0);

    if(op == WM_CP_LEN) {
        wmLenBuf = l;
        return (const char *)&wmLenBuf;
    }

    char *str = (char *)malloc(l);

    sprintf(str, tcdList, bttfnHaveTCDSSID ? TCDSSID : "");

    return str;
}

static const char *wmBuildTCDSSID(const char *dest, int op)
{
    if(op == WM_CP_DESTROY) {
        if(dest) free((void *)dest);
        return NULL;
    }

    if(!bttfnHaveTCDSSID)
        return NULL;

    unsigned int l = STRLEN(tcdSSIDp) + STRLEN(tcdSSID0) + 4;
    l += strlen(TCDSSID);

    if(op == WM_CP_LEN) {
        wmLenBuf = l;
        return (const char *)&wmLenBuf;
    }

    char *str = (char *)malloc(l);

    sprintf(str, tcdSSIDp, tcdSSID0, TCDSSID);

    return str;
}

static const char *wmBuildTCDPW(const char *dest, int op)
{
    if(op == WM_CP_DESTROY) {
        if(dest) free((void *)dest);
        return NULL;
    }

    if(!bttfnHaveTCDSSID)
        return NULL;

    unsigned int l = STRLEN(tcdSSIDq) + STRLEN(tcdSSID0) + (TCDpwMarker ? STRLEN(tcdAPPW2) : STRLEN(tcdAPPW1)) + 4;

    if(op == WM_CP_LEN) {
        wmLenBuf = l;
        return (const char *)&wmLenBuf;
    }

    char *str = (char *)malloc(l);

    sprintf(str, tcdSSIDq, tcdSSID0, TCDpwMarker ? tcdAPPW2 : tcdAPPW1);

    return str;
}

static const char *wmBuildApChnl(const char *dest, int op)
{
    return wmBuildSelect(dest, op, apChannelCustHTMLSrc, 14, settings.apChnl, false);
}

static const char *wmBuildBestApChnl(const char *dest, int op)
{
    if(op == WM_CP_DESTROY) {
        if(dest) free((void *)dest);
        return NULL;
    }

    int32_t mychan = 0;
    int qual = 0;

    if(wm.getBestAPChannel(mychan, qual)) {
        unsigned int l = STRLEN(bestAP) - (5*2) + STRLEN(bannerStart) + 6 + STRLEN(bannerMid) + 4 + STRLEN(badWiFi) + 1 + 8;
        if(op == WM_CP_LEN) {
            wmLenBuf = l;
            return (const char *)&wmLenBuf;
        }
        char *str = (char *)malloc(l);
        sprintf(str, bestAP, bannerStart, qual < 0 ? col_r : (qual > 0 ? col_g : col_gr), bannerMid, mychan, qual < 0 ? badWiFi : "");
        return str;
    }

    return NULL;
}

static const char *wmBuildTUT(const char *dest, int op)
{
    return wmBuildRadioButtons(dest, op, tutCustHTMLSrc, 2, settings.playTUT);
}

static const char *wmBuildMusicFolder(const char *dest, int op)
{
    if(op == WM_CP_DESTROY) {
        if(dest) free((void *)dest);
        return NULL;
    }

    sprintf(settings.musicFolder, "%1d", musFolderNum);

    unsigned int l = calcSelectMenu(musFoldCustHTMLSrc, 12, settings.musicFolder);

    for(int i = 0; i < 10; i++) {
        l -= 2; // "%s"
        l += strlen(musFoldStates[mfstatus[i] + 4]);
    }

    if(op == WM_CP_LEN) {
        wmLenBuf = l;
        return (const char *)&wmLenBuf;
    }
    
    char *target = (char *)malloc(l);

    strcpy(target, custHTMLHdr1);
    strcat(target, custHTMLHdr2);
    strcat(target, musFoldCustHTMLSrc[1]);
    strcat(target, musFoldCustHTMLSrc[0]);
    strcat(target, custHTMLSHdr);
    strcat(target, settings.musicFolder);
    sprintf(target + strlen(target), custHTMLSelFmt, musFoldCustHTMLSrc[1], musFoldCustHTMLSrc[1]);
    for(int i = 0; i < 12 - 2; i++) {
        if(musFolderNum == i) strcat(target, custHTMLSel);
        sprintf(target + strlen(target), 
            musFoldCustHTMLSrc[i+2], musFoldStates[mfstatus[i] + 4], (i == 12 - 3) ? osde : ooe);
    }

    return target;
}

static const char *wmBuildRefill(const char *dest, int op)
{
    return wmBuildSelect(dest, op, refillCustHTMLSrc, 11, settings.refBut, false);
}

static const char *wmBuildHaveSD(const char *dest, int op)
{
    if(op == WM_CP_DESTROY) {
        if(dest) free((void *)dest);
        return NULL;
    }
    
    if(haveSD)
        return NULL;

    return buildBanner(haveNoSD, col_r, op);
}

static const char *wmBuildOORST(const char *dest, int op)
{
    return wmBuildRadioButtons(dest, op, oorstCustHTMLSrc, 2, settings.oorst);
}

static const char *wmBuildOOTT(const char *dest, int op)
{
    return wmBuildRadioButtons(dest, op, oottCustHTMLSrc, 2, settings.ooTT);
}

static const char *wmBuildRESAT(const char *dest, int op)
{
    return wmBuildRadioButtons(dest, op, resatCustHTMLSrc, 2, settings.resAT);
}

#ifdef HAVE_PM
static const char *wmBuildBatType(const char *dest, int op)
{
    return wmBuildSelect(dest, op, batTypeHTMLSrc, 7, settings.batType, false);
}
#endif

#ifdef HAVE_MQTT
static const char *wmBuildMQTTprot(const char *dest, int op)
{
    return wmBuildSelect(dest, op, mqttpCustHTMLSrc, 4, settings.mqttVers, false);
}

static const char *wmBuildMQTTstate(const char *dest, int op)
{
    // Check original setting, not "useMQTT" which
    // might be overruled.
    if(!evalBool(settings.useMQTT)) {
        return NULL;
    }
    
    if(op == WM_CP_DESTROY) {
        if(dest) free((void *)dest);
        return NULL;
    }

    int s = 0;
    const char *msg = NULL;
    const char *cls = col_r;

    if(!useMQTT) {
        if(mqttReconnFails) {
            msg = mqttMsgResolvErr;
        } else {
            msg = mqttMsgDisabled;
            cls = col_gr;
        }
    } else {
        s = mqttClient.state();
        switch(s) {
        case MQTT_CONNECTED:
            msg = mqttMsgConnected;
            cls = col_g;
            break;
        case MQTT_CONNECTING:
            msg = mqttMsgConnecting;
            cls = col_gr;
            break;
        case MQTT_CONNECTION_TIMEOUT:
            msg = mqttMsgTimeout;
            break;
        case MQTT_CONNECTION_LOST:
        case MQTT_CONNECT_FAILED:
            msg = mqttMsgFailed;
            break;
        case MQTT_DISCONNECTED:
            msg = mqttMsgDisconnected;
            break;
        case MQTT_CONNECT_BAD_PROTOCOL:
        case MQTT_CONNECT_BAD_CLIENT_ID:
        case 129:
        case 130:
        case 132:
        case 133:
            msg = mqttMsgBadProtocol;
            break;
        case MQTT_CONNECT_UNAVAILABLE:
        case 136:
        case 137:
            msg = mqttMsgUnavailable;
            break;
        case MQTT_CONNECT_BAD_CREDENTIALS:
        case MQTT_CONNECT_UNAUTHORIZED:
        case 134:
        case 135:
        case 138:
        case 140:
        case 156:
        case 157:
            msg = mqttMsgBadCred;
            break;
        default:
            msg = mqttMsgGenError;
            break;
        }
    }

    // "%s%s%s%s%s (%d)</div>"
    unsigned int l = STRLEN(mqttStatus) - (6*2) + STRLEN(bannerStart) + strlen(cls) + 20 + STRLEN(bannerMid) + strlen(msg) + 6;

    if(op == WM_CP_LEN) {
        wmLenBuf = l;
        return (const char *)&wmLenBuf;
    }

    char *str = (char *)malloc(l);

    sprintf(str, mqttStatus, bannerStart, cls, ";margin-bottom:10px", bannerMid, msg, s);

    return str;
}

static const char *wmBuildMQTTTM(const char *dest, int op)
{
    if(op == WM_CP_DESTROY) {
        if(dest) free((void *)dest);
        return NULL;
    }
    const char HTTP_SECT_HEAD[] = "<div class='ss'>";
    const char HTTP_SECT_FOOT[] = "</div>";
    const char mqtttm1[] = "<label for='%s'>Button %d topic</label><br><input id='%s' name='%s' maxlength='127' value='%s'%s><br><label for='%s'>Button %d message on ON</label><br><input id='%s' name='%s' maxlength='63' value='%s'%s><br><label for='%s'>Button %d message on OFF</label><br><input id='%s' name='%s' maxlength='63' value='%s' class='mb15'%s><br>";
    const char mqtttmp1[] = " placeholder='Example: home/lights/1/'";
    const char mqtttmp2[] = " placeholder='Example: ON'";
    const char mqtttmp3[] = " placeholder='Example: OFF'";

    unsigned int l = 0;

    l += STRLEN(HTTP_SECT_HEAD) + STRLEN(HTTP_SECT_FOOT) + STRLEN(mqtttmp1) + STRLEN(mqtttmp2) + STRLEN(mqtttmp3) + 4;
    for(int i = 0; i < 8; i++) {
        l += STRLEN(mqtttm1) - (2*18);
        l += (STRLEN(mqnmt) * 3) + (STRLEN(mqnmo) * 3) + (STRLEN(mqnmf) * 3);
        l += 3;   // '1'-'8' 1x topic, 1x on, 1x off
        l += strlen(settings.mqttbt[i]);
        l += strlen(settings.mqttbo[i]);
        l += strlen(settings.mqttbf[i]);
    }

    if(op == WM_CP_LEN) {
        wmLenBuf = l;
        return (const char *)&wmLenBuf;
    }

    char *str = (char *)malloc(l);

    strcpy(str, HTTP_SECT_HEAD);
    for(int i = 0; i < 8; i++) {
        mqnmt[2] = mqnmo[2] = mqnmf[2] = i + '0';
        sprintf(str + strlen(str), mqtttm1,
               mqnmt, i + 1, mqnmt, mqnmt, settings.mqttbt[i], !i ? mqtttmp1 : "",
               mqnmo, i + 1, mqnmo, mqnmo, settings.mqttbo[i], !i ? mqtttmp2 : "",
               mqnmf, i + 1, mqnmf, mqnmf, settings.mqttbf[i], !i ? mqtttmp3 : "");
    }
    strcat(str, HTTP_SECT_FOOT);

    return str;
}
#endif

/*
 * Audio data uploader
 */

static void doReboot()
{
    delay(1000);
    prepareReboot();
    delay(1000);
    esp_restart();
}

static void allocUplArrays()
{
    if(opType) free((void *)opType);
    opType = (int *)malloc(MAX_SIM_UPLOADS * sizeof(int));
    if(ACULerr) free((void *)ACULerr);
    ACULerr = (int *)malloc(MAX_SIM_UPLOADS * sizeof(int));;
    memset(opType, 0, MAX_SIM_UPLOADS * sizeof(int));
    memset(ACULerr, 0, MAX_SIM_UPLOADS * sizeof(int));
}

static void setupWebServerCallback()
{
    wm.server->on(R_updateacdone, HTTP_POST, &handleUploadDone, &handleUploading);
    #ifdef HAVE_CRSF
    if(haveNewBoard && opModeCRSF) {
        wm.server->on("/elrsraw", HTTP_GET, &handleELRSRawRead);
        wm.server->on("/elrstelemetry", HTTP_GET, &handleELRSTelemetryRead);
    }
    #endif
}

static void doCloseACFile(int idx, bool doRemove)
{
    if(haveACFile) {
        closeACFile(acFile);
        haveACFile = false;
    }
    if(doRemove) removeACFile(idx);  
}

static void handleUploading()
{
    HTTPUpload& upload = wm.server->upload();

    if(upload.status == UPLOAD_FILE_START) {

          String c = upload.filename;
          const char *illChrs = "|~><:*?\" ";
          int temp;
          char tempc;

          if(numUploads >= MAX_SIM_UPLOADS) {
            
              haveACFile = false;

          } else {

              c.toLowerCase();
    
              // Remove path and some illegal characters
              tempc = '/';
              for(int i = 0; i < 2; i++) {
                  if((temp = c.lastIndexOf(tempc)) >= 0) {
                      if(c.length() - 1 > temp) {
                          c = c.substring(temp);
                      } else {
                          c = "";
                      }
                      break;
                  }
                  tempc = '\\';
              }
              for(int i = 0; i < strlen(illChrs); i++) {
                  c.replace(illChrs[i], '_');
              }
              if(!c.indexOf("..")) {
                  c.replace("..", "");
              }
    
              if(!numUploads) {
                  allocUplArrays();
                  preUpdateCallback();
              }
    
              haveACFile = openUploadFile(c, acFile, numUploads, haveAC, opType[numUploads], ACULerr[numUploads]);

              if(haveACFile && opType[numUploads] == 1) {
                  haveAC = true;
              }

          }

    } else if(upload.status == UPLOAD_FILE_WRITE) {

          if(haveACFile) {
              if(writeACFile(acFile, upload.buf, upload.currentSize) != upload.currentSize) {
                  doCloseACFile(numUploads, true);
                  ACULerr[numUploads] = UPL_WRERR;
              }
          }

    } else if(upload.status == UPLOAD_FILE_END) {

        if(numUploads < MAX_SIM_UPLOADS) {

            doCloseACFile(numUploads, false);
    
            if(opType[numUploads] >= 0) {
                renameUploadFile(numUploads);
            }
    
            numUploads++;

        }
      
    } else if(upload.status == UPLOAD_FILE_ABORTED) {

        if(numUploads < MAX_SIM_UPLOADS) {
            doCloseACFile(numUploads, true);
        }

        doReboot();

    }

    delay(0);
}

static void handleUploadDone()
{
    const char *ebuf = "ERROR";
    const char *dbuf = "DONE";
    char *buf = NULL;
    bool haveErrs = false;
    bool haveAC = false;
    int titStart = -1;
    int buflen  = strlen(wm.getHTTPSTART(titStart)) +    // includes </title>
                  STRLEN(myTitle)    +
                  strlen(wm.getHTTPSCRIPT()) +
                  strlen(wm.getHTTPSTYLE()) +
                  STRLEN(acul_part1) +
                  STRLEN(myHead)     +
                  STRLEN(acul_part3) +
                  STRLEN(myTitle)    +
                  STRLEN(acul_part5) +
                  STRLEN(acul_part8) +
                  1;

    for(int i = 0; i < numUploads; i++) {
        if(opType[i] > 0) {
            haveAC = true;
            if(!ACULerr[i]) {
                if(!check_if_default_audio_present()) {
                    haveAC = false;
                    ACULerr[i] = UPL_BADERR;
                    removeACFile(i);
                }
            }
            break;
        }
    }    

    if(!haveSD && numUploads) {
      
        haveErrs = true;
        buflen += (STRLEN(acul_part71) + strlen(acul_errs[1]));
        
    } else {

        for(int i = 0; i < numUploads; i++) {
            if(ACULerr[i]) haveErrs = true;
        }
        if(haveErrs) {
            buflen += STRLEN(acul_part71);
            for(int i = 0; i < numUploads; i++) {
                if(ACULerr[i]) {
                    buflen += getUploadFileNameLen(i);
                    buflen += 2; // :_
                    buflen += strlen(acul_errs[ACULerr[i]-1]);
                    buflen += 4; // <br>
                }
            }
        } else {
            buflen += strlen(wm.getHTTPSTYLEOK());
            buflen += STRLEN(acul_part7);
        }
        if(haveAC) {
            buflen += STRLEN(acul_part7a);
        }
    }

    buflen += 8;

    if(!(buf = (char *)malloc(buflen))) {
        buf = (char *)(haveErrs ? ebuf : dbuf);
    } else {
        strcpy(buf, wm.getHTTPSTART(titStart));
        if(titStart >= 0) {
            strcpy(buf + titStart, myTitle);
            strcat(buf, "</title>");
        }
        strcat(buf, wm.getHTTPSCRIPT());
        strcat(buf, wm.getHTTPSTYLE());
        if(!haveErrs) {
            strcat(buf, wm.getHTTPSTYLEOK());
        }
        strcat(buf, acul_part1);
        strcat(buf, myHead);
        strcat(buf, acul_part3);
        strcat(buf, myTitle);
        strcat(buf, acul_part5);

        if(!haveSD && numUploads) {

            strcat(buf, acul_part71);
            strcat(buf, acul_errs[1]);
            
        } else {
            
            if(haveErrs) {
                strcat(buf, acul_part71);
                for(int i = 0; i < numUploads; i++) {
                    if(ACULerr[i]) {
                        char *t = getUploadFileName(i);
                        if(t) {
                            strcat(buf, t);
                        }
                        strcat(buf, ": ");
                        strcat(buf, acul_errs[ACULerr[i]-1]);
                        strcat(buf, "<br>");
                    }
                }
            } else {
                strcat(buf, acul_part7);
            }
            if(haveAC) {
                strcat(buf, acul_part7a);
            }
        }

        strcat(buf, acul_part8);
    }

    freeUploadFileNames();
    /* Pointless, we reboot
    numUploads = 0;
    for(int i = 0; i < MAX_SIM_UPLOADS; i++) {
        opType[i] = 0;
        ACULerr[i] = 0;
    }
    */
    
    wm.server->setContentLength(strlen(buf));
    wm.server->send(200, "text/html", "");
    wm.server->sendContent(buf, strlen(buf));

    // Reboot required even for mp3 upload, because for most files, we check
    // during boot if they exist (to avoid repeatedly failing open() calls)

    doReboot();
}

bool wifi_getIP(uint8_t& a, uint8_t& b, uint8_t& c, uint8_t& d)
{
    IPAddress myip;

    switch(WiFi.getMode()) {
      case WIFI_MODE_STA:
          myip = WiFi.localIP();
          break;
      case WIFI_MODE_AP:
      case WIFI_MODE_APSTA:
          myip = WiFi.softAPIP();
          break;
      default:
          a = b = c = d = 0;
          return true;
    }

    a = myip[0];
    b = myip[1];
    c = myip[2];
    d = myip[3];

    return true;
}

// Check if String is a valid IP address
bool isIp(char *str)
{
    int segs = 0;
    int digcnt = 0;
    int num = 0;

    while(*str) {

        if(*str == '.') {

            if(!digcnt || (++segs == 4))
                return false;

            num = digcnt = 0;
            str++;
            continue;

        } else if((*str < '0') || (*str > '9')) {

            return false;

        }

        if((num = (num * 10) + (*str - '0')) > 255)
            return false;

        digcnt++;
        str++;
    }

    if(segs == 3) 
        return true;

    return false;
}

// String to IPAddress
static IPAddress stringToIp(char *str)
{
    int ip1, ip2, ip3, ip4;

    siscanf(str, "%d.%d.%d.%d", &ip1, &ip2, &ip3, &ip4);

    return IPAddress(ip1, ip2, ip3, ip4);
}

/*
 * Read parameter from server, for customhmtl input
 */

static bool isNumString(char *s)
{
    for( ; *s; ++s) {
        if(*s < '0' || *s > '9') return false;
    }
    return true;
}

static void getServerParam(const char *name, char *destBuf, size_t length, int minval, int maxval, int defaultVal)
{
    int i;
    memset(destBuf, 0, length + 1);
    strncpy(destBuf, wm.server->arg(name).c_str(), length);
    if(*destBuf) {
        if(isNumString(destBuf)) i = atoi(destBuf);
        else *destBuf = 0;
    }
    if(!*destBuf || i < minval || i > maxval) {
        sprintf(destBuf, "%d", defaultVal);
    }
}

static bool myisspace(char mychar)
{
    return (mychar == ' ' || mychar == '\n' || mychar == '\t' || mychar == '\v' || mychar == '\f' || mychar == '\r');
}

static bool myisgoodchar(char mychar)
{
    return ((mychar >= '0' && mychar <= '9') || (mychar >= 'a' && mychar <= 'z') || (mychar >= 'A' && mychar <= 'Z') || mychar == '-');
}

static char* strcpytrim(char* destination, const char* source, bool doFilter)
{
    char *ret = destination;
    
    while(*source) {
        if(!myisspace(*source) && (!doFilter || myisgoodchar(*source))) *destination++ = *source;
        source++;
    }
    
    *destination = 0;
    
    return ret;
}

static bool myisgoodcharMAC(char mychar)
{
    return ((mychar >= '0' && mychar <= '9') || (mychar >= 'a' && mychar <= 'f') || (mychar >= 'A' && mychar <= 'F') || mychar == ':');
}

static char* strcpytrimMAC(char* destination, const char* source)
{
    char *ret = destination;
    
    while(*source) {
        if(!myisspace(*source) && myisgoodcharMAC(*source)) *destination++ = *source;
        source++;
    }
    
    *destination = 0;
    
    return ret;
}

static void mystrcpy(char *sv, WiFiManagerParameter *el)
{
    strcpy(sv, el->getValue());
}

static void mystrcpyWiFiDelay(char *sv, WiFiManagerParameter *el)
{
    int a = atoi(el->getValue());
    if(a > 0 && a < 10) a = 10;
    else if(a > 99)     a = 99;
    else if(a < 0)      a = 0;
    sprintf(sv, "%d", a);
}

static void evalCB(char *sv, WiFiManagerParameter *el)
{
    *sv++ = (*(el->getValue()) == '0') ? '0' : '1';
    *sv = 0;
}

static void setCBVal(WiFiManagerParameter *el, char *sv)
{
    el->setValue((*sv == '0') ? "0" : "1");
}

#ifdef HAVE_MQTT
static void truncateUTF8(char *src)
{
    unsigned int i, e, slen = strlen(src);
    unsigned char c;

    for(i = 0; i < slen; i++) {
        c = (unsigned char)src[i];
        e = 0;
        if     (c >= 192 && c < 224)  e = 1;
        else if(c >= 224 && c < 240)  e = 2;
        else if(c >= 240 && c < 248)  e = 3;  // Invalid UTF8 >= 245, but consider 4-byte char anyway
        if(e) {
            if((i + e) >= slen) {
                src[i] = 0;
                return;
            }
            i += e;
        }
    }
}

static void strcpyutf8(char *dst, const char *src, unsigned int len)
{
    char *dest = dst;
    len--; // leave room for 0
    while(*src && len--) {
        if(*src != '\'') *dst++ = *src;
        src++;
    }
    *dst = 0;
    truncateUTF8(dest);
}

static void handleMQTTTopMsg(int idx)
{
    int sz;
    mqnmt[2] = mqnmo[2] = mqnmf[2] = idx + '0';

    memset(settings.mqttbt[idx], 0, sizeof(settings.mqttbt[0]));
    memset(settings.mqttbo[idx], 0, sizeof(settings.mqttbo[0]));
    memset(settings.mqttbf[idx], 0, sizeof(settings.mqttbf[0]));
    
    // We don't allow the single quote (') since it messes
    // up our HTML. Maybe escape it.. in the future.

    String tt = wm.server->arg(mqnmt);
    if((sz = tt.length())) {
        sz++;
        if(sz > sizeof(settings.mqttbt[0])) sz = sizeof(settings.mqttbt[0]);
        strcpyutf8(settings.mqttbt[idx], tt.c_str(), sz);
    }

    String tm = wm.server->arg(mqnmo);
    if((sz = tm.length())) {
        sz++;
        if(sz > sizeof(settings.mqttbo[0])) sz = sizeof(settings.mqttbo[0]);
        strcpyutf8(settings.mqttbo[idx], tm.c_str(), sz);
    }

    String tf = wm.server->arg(mqnmf);
    if((sz = tf.length())) {
        sz++;
        if(sz > sizeof(settings.mqttbf[0])) sz = sizeof(settings.mqttbf[0]);
        strcpyutf8(settings.mqttbf[idx], tf.c_str(), sz);
    }
}

static void mqttLooper()
{
    #ifdef HAVE_CRSF
    bool wasActive = mqttLooperActive;
    mqttLooperActive = true;
    if(opModeCRSF) serviceCRSF(false);
    #endif
    audio_loop();
    #ifdef HAVE_CRSF
    mqttLooperActive = wasActive;
    #endif
}

static uint16_t a2i(char *p)
{
    unsigned int t = 0;
    t += (*p++ - '0') * 1000;
    t += (*p++ - '0') * 100;
    t += (*p++ - '0') * 10;
    t += (*p - '0');

    return (uint16_t)t;
}

static void mqttCallback(char *topic, byte *payload, unsigned int length)
{
    int i = 0, j, ml = (length <= 255) ? length : 255;
    char tempBuf[256];
    static const char *cmdList[] = {
      "PLAYKEY_",         // 0  PLAYKEY_1..PLAYKEY_9, PLAYKEY_1L..PLAYKEY9L
      "STOPKEY",          // 1
      "AUTOTHROTTLE_ON",  // 2
      "AUTOTHROTTLE_OFF", // 3
      "COASTING_ON",      // 4
      "COASTING_OFF",     // 5
      "MOVIEACCEL_ON",    // 6
      "MOVIEACCEL_OFF",   // 7
      "DISPTCDSPD_ON",    // 8
      "DISPTCDSPD_OFF",   // 9
      "MP_SHUFFLE_ON",    // 10 
      "MP_SHUFFLE_OFF",   // 11
      "MP_PLAY",          // 12
      "MP_STOP",          // 13
      "MP_NEXT",          // 14
      "MP_PREV",          // 15
      "MP_FOLDER_",       // 16  MP_FOLDER_0..MP_FOLDER_9
      "INJECT_",          // 17
      "VOLUME_UP",        // 18
      "VOLUME_DOWN",      // 19
      "VOLUME_SET_",      // 20  VOLUME_SET_0..VOLUME_SET_100
      #ifdef HAVE_MQTT_MP
      "MP_REQSTATUS",     // 21  must be last due to ifdef
      #endif
      NULL
    };
    static const char *cmdList2[] = {
      "PREPARE",          // 0
      "TIMETRAVEL",       // 1
      "REENTRY",          // 2
      "ABORT_TT",         // 3
      "ALARM",            // 4
      "WAKEUP",           // 5
      NULL
    };

    // Note: This might be called while we are in a
    // wait-delay-loop. Best to just set flags here
    // that are evaluated synchronously (=later).
    // Do not stuff that messes with display, input,
    // etc.

    if(!length) return;

    memcpy(tempBuf, (const char *)payload, ml);
    tempBuf[ml] = 0;
    for(j = 0; j < ml; j++) {
        if(tempBuf[j] >= 'a' && tempBuf[j] <= 'z') tempBuf[j] &= ~0x20;
    }

    if(!strcmp(topic, "bttf/tcd/pub")) {

        // Commands from TCD

        while(cmdList2[i]) {
            j = strlen(cmdList2[i]);
            if((length >= j) && !strncmp((const char *)tempBuf, cmdList2[i], j)) {
                break;
            }
            i++;          
        }

        if(!cmdList2[i]) return;

        switch(i) {
        case 0:
            // Prepare for TT. Comes at some undefined point,
            // an undefined time before the actual tt, and may
            // not come at all.
            if(remoteAllowed) {
                doPrepareTT = true;
            }
            break;
        case 1:
            // Trigger Time Travel (if not running already)
            if(remoteAllowed) {
                if(!(csf & CSF_OFF) && !remBusy) {
                    csf &= ~CSF_MISSEDTT;
                    if(!(csf & CSF_TT)) {
                        networkTimeTravel = true;
                        networkReentry = false;
                        networkAbort = false;
                        if(strlen(tempBuf) == 20) {
                            networkLead = a2i(&tempBuf[11]);
                            networkP1 = a2i(&tempBuf[16]);
                        } else {
                            networkLead = ETTO_LEAD;
                            networkP1 = 6600;
                        }
                    }
                } else {
                    csf |= CSF_MISSEDTT;
                }
            }
            break;
        case 2:   // Re-entry
            // Start re-entry (if TT currently running)
            if(csf & CSF_TT) {
                networkReentry = true;
            } else {
                networkTimeTravel = false;
            }
            csf &= ~CSF_MISSEDTT;
            break;
        case 3:   // Abort TT (TCD fake-powered down during TT, or brake hit after TT-notification)
            // Abort TT (if TT currently running or triggered)
            if((csf & CSF_TT) || networkTimeTravel) {
                networkAbort = true;
            }
            csf &= ~CSF_MISSEDTT;
            break;
        case 4:
            networkAlarm = true;
            // Eval this at our convenience
            break;
        case 5:
            if(remoteAllowed) {
                doWakeup = true;
            }
            break;
        }
       
    } else if(!remBusy && !strcmp(topic, "bttf/remote/cmd")) {

        // User commands

        int tblen = 0;

        while(cmdList[i]) {
            j = strlen(cmdList[i]);
            if((length >= j) && !strncmp((const char *)tempBuf, cmdList[i], j)) {
                break;
            }
            i++;          
        }

        if(!cmdList[i]) return;

        // ATTN: Unlike on other props, execute_remote_command()
        // is also called while fake-off!

        tblen = strlen(tempBuf);

        switch(i) {
        case 0:
            if(tblen > j && tempBuf[j] >= '1' && tempBuf[j] <= '9') {
                bool l = (tblen > j+1 && tempBuf[j+1] == 'L');
                addCmdQueue(500 + (uint32_t)(tempBuf[j] - '0') + (l ? 10 : 0));
            }
            break;
        case 10:
        case 11:
            addCmdQueue((i == 10) ? 555 : 222);
            break;
        case 16:
            if(tblen > j && tempBuf[j] >= '0' && tempBuf[j] <= '9') {
                addCmdQueue(50 + (uint32_t)(tempBuf[j] - '0'));
            }
            break;
        case 17:
            if(tblen > j) {
                addCmdQueue(atoi(tempBuf+j) | 0x80000000);
            }
            break;
        case 20:
            if(tblen > j && tempBuf[j] >= '0' && tempBuf[j] <= '9') {
                int p = atoi(tempBuf+j);
                if(p >= 0 && p <= 100) {
                    addCmdQueue(300 + ((VOL_LEVELS - 1) * p / 100));
                }
            }
            break;
        #ifdef HAVE_MQTT_MP    
        case 21:
            if((!(csf & CSF_OFF)) && ((csf & (CSF_TCDINP0|CSF_TT|CSF_KEEPCOUNTING)) || throttlePos)) {
                addCmdQueue(1021);
            } else {
                mp_sendStatus(1);
            }
            break;
        #endif            
        default:
            addCmdQueue(1000 + i);
        }
            
    } 
}

#ifdef REMOTE_DBG
#define MQTT_FAILCOUNT 6
#else
#define MQTT_FAILCOUNT 120
#endif

static void mqttPing()
{
    switch(mqttClient.pstate()) {
    case PING_IDLE:
        if(WiFi.status() == WL_CONNECTED) {
            if(!mqttPingNow || (millis() - mqttPingNow > mqttPingInt)) {
                mqttPingNow = millisNonZero();
                if(!mqttClient.sendPing()) {
                    // Mostly fails for internal reasons;
                    // skip ping test in that case
                    mqttDoPing = false;
                    mqttPingDone = true;  // allow mqtt-connect attempt
                }
            }
        }
        break;
    case PING_PINGING:
        if(mqttClient.pollPing()) {
            mqttPingDone = true;          // allow mqtt-connect attempt
            mqttPingNow = 0;
            mqttPingsExpired = 0;
            mqttPingInt = MQTT_SHORT_INT; // Overwritten on fail in reconnect
            // Delay re-connection for 5 seconds after first ping echo
            if(!(mqttReconnectNow = millis() - (mqttReconnectInt - 5000)))
                mqttReconnectNow--;
        } else if(millis() - mqttPingNow > 5000) {
            mqttClient.cancelPing();
            mqttPingNow = millisNonZero();
            mqttPingsExpired++;
            mqttPingInt = MQTT_SHORT_INT * (1 << (mqttPingsExpired / MQTT_FAILCOUNT));
            mqttReconnFails = 0;
        }
        break;
    } 
}

static bool mqttReconnect(bool force)
{
    bool success = false;

    if(useMQTT && (WiFi.status() == WL_CONNECTED)) {

        if(!mqttClient.connected()) {
    
            if(force || !mqttReconnectNow || (millis() - mqttReconnectNow > mqttReconnectInt)) {

                #ifdef REMOTE_DBG
                Serial.println("MQTT: Attempting to (re)connect");
                #endif
    
                if(strlen(mqttUser)) {
                    success = mqttClient.connect(mqttUser, strlen(mqttPass) ? mqttPass : NULL);
                } else {
                    success = mqttClient.connect();
                }
    
                mqttReconnectNow = millisNonZero();
                
                if(!success) {
                    mqttRestartPing = true;  // Force PING check before reconnection attempt
                    mqttReconnFails++;
                    if(mqttDoPing) {
                        mqttPingInt = MQTT_SHORT_INT * (1 << (mqttReconnFails / MQTT_FAILCOUNT));
                    } else {
                        mqttReconnectInt = MQTT_SHORT_INT * (1 << (mqttReconnFails / MQTT_FAILCOUNT));
                    }
                    #ifdef REMOTE_DBG
                    Serial.printf("MQTT: Failed to reconnect (%d)\n", mqttReconnFails);
                    #endif
                } else {
                    mqttReconnFails = 0;
                    mqttReconnectInt = MQTT_SHORT_INT;
                    #ifdef REMOTE_DBG
                    Serial.println("MQTT: Connected to broker, waiting for CONNACK");
                    #endif
                }
    
                return success;
            } 
        }
    }
      
    return true;
}

static void mqttSubscribe()
{
    // Meant only to be called when connected!
    if(!mqttSubAttempted) {
        if(!mqttClient.subscribe("bttf/remote/cmd", "bttf/tcd/pub")) {
            #ifdef REMOTE_DBG
            Serial.println("MQTT: Failed to subscribe to command topics");
            #endif
        }

        // Send out music player status as soon as possible
        #ifdef HAVE_MQTT_MP
        mp_sendStatus(1);
        #endif

        mqttSubAttempted = true;
    }
}

bool mqttConnected()
{
    return (useMQTT && (mqttClient.state() == MQTT_CONNECTED));
}

bool mqttPublish(const char *topic, const char *pl, unsigned int len)
{
    #ifdef HAVE_CRSF
    // CRSF/audio service can run while PubSubClient owns its packet buffer.
    if(mqttLooperActive) return false;
    #endif
    if(useMQTT) {
        return mqttClient.publish(topic, (uint8_t *)pl, len, false);
    }

    return true;
}           
#endif
