CircuitSetup/Remote/src/src/CRSF/elrs_crsf_core.cpp

#include "../../remote_global.h"

#ifdef HAVE_CRSF

#include "elrs_crsf_core.h"

#include <stdarg.h>
#include <stdio.h>
#include <stdlib.h>
#include <string.h>

namespace {

constexpr uint16_t CRSF_CHANNEL_MIN = 172;
constexpr uint16_t CRSF_CHANNEL_MID = 992;
constexpr uint16_t CRSF_CHANNEL_MAX = 1811;

constexpr uint8_t CRSF_FRAME_GPS = 0x02;
constexpr uint8_t CRSF_FRAME_BATTERY = 0x08;
constexpr uint8_t CRSF_FRAME_AIRSPEED = 0x0A;
constexpr uint8_t CRSF_FRAME_RPM = 0x0C;
constexpr uint8_t CRSF_FRAME_ARDUPILOT = 0x80;
// HoTT forwards unchanged RPM every five seconds; allow time for the telemetry link.
constexpr unsigned long CRSF_RPM_TIMEOUT_MS = 6000;
constexpr uint8_t CRSF_FRAME_LINK_STATS = 0x14;
constexpr uint8_t CRSF_FRAME_DEVICE_PING = 0x28;
constexpr uint8_t CRSF_FRAME_DEVICE_INFO = 0x29;
constexpr uint8_t CRSF_FRAME_PARAMETER_SETTINGS_ENTRY = 0x2B;
constexpr uint8_t CRSF_FRAME_PARAMETER_READ = 0x2C;
constexpr uint8_t CRSF_FRAME_PARAMETER_WRITE = 0x2D;
constexpr uint8_t CRSF_SYNC_BYTE = 0xC8;
constexpr uint8_t CRSF_EXT_ADDR_BROADCAST = 0x00;
constexpr uint8_t CRSF_EXT_ADDR_RADIO_TRANSMITTER = 0xEA;
constexpr uint8_t CRSF_EXT_ADDR_HANDSET = 0xEF;
constexpr uint8_t CRSF_EXT_ADDR_CRSF_TRANSMITTER = 0xEE;
constexpr uint8_t CRSF_PARAM_TEXT_SELECTION = 0x09;

constexpr unsigned long CRSF_DISPLAY_INTERVAL = 200;
constexpr unsigned long CRSF_INPUT_STALE_MS = 100;
constexpr unsigned long CRSF_COMM_OVERLAY_MS = 1000;
constexpr unsigned long CRSF_COMM_NSY_OVERLAY_MS = 1500;
constexpr unsigned long CRSF_MODULE_CONFIG_START_DELAY_MS = 1000;
constexpr unsigned long CRSF_MODULE_CONFIG_REPLY_TIMEOUT_MS = 500;
constexpr unsigned long CRSF_MODULE_CONFIG_WRITE_DELAY_MS = 300;
constexpr unsigned long CRSF_MODULE_CONFIG_PROBE_RETRY_DELAY_MS = 1000;
constexpr uint8_t CRSF_MODULE_CONFIG_MAX_PROBE_RETRIES = 2;
constexpr uint8_t CRSF_MODULE_CONFIG_MAX_PARAMETER_RETRIES = 2;
constexpr unsigned long BATTERY_BANNER_INTERVAL = 30000;
constexpr unsigned long BATTERY_BANNER_DURATION = 1000;
constexpr size_t CRSF_DEVICE_INFO_TRAILER_LEN = 14;

constexpr uint8_t AXIS_AILERON = 0;
constexpr uint8_t AXIS_ELEVATOR = 1;
constexpr uint8_t AXIS_RUDDER = 2;
constexpr uint8_t AXIS_THROTTLE = 3;

}

void elrsFormatTelemetry(const ELRSDisplayConfig &config, const ELRSTelemetrySample &sample,
                         uint8_t speedUnits, char text[8])
{
    text[0] = 0;
    if(config.source == ELRS_DISPLAY_OFF || config.source == ELRS_DISPLAY_NONE) return;
    if(!sample.available || !std::isfinite(sample.value)) {
        strcpy(text, "---");
        return;
    }
    const bool automatic = config.source == ELRS_DISPLAY_AUTO;
    const uint8_t decimals = automatic || config.decimalPlaces == 255 ?
        elrsTelemetrySourceDecimals(sample.source) : config.decimalPlaces;
    float value = sample.value;
    if((sample.source == ELRS_DISPLAY_GPS_SPEED || sample.source == ELRS_DISPLAY_AIRSPEED) &&
       speedUnits == ELRS_SPEED_UNITS_MPH) value *= 0.621371192f;
    if(!automatic) value = value * config.multiplier + config.offset;
    if(!std::isfinite(value) || decimals > 2) {
        strcpy(text, "---");
        return;
    }
    const int factor = decimals == 2 ? 100 : (decimals == 1 ? 10 : 1);
    const float rounded = roundf(value * factor);
    if(rounded > 999 || rounded < -99) {
        strcpy(text, rounded > 999 ? "HI" : "LO");
        return;
    }
    const int number = (int)rounded;
    const int magnitude = number < 0 ? -number : number;
    if(!decimals) snprintf(text, 8, "%d", number);
    else if(number < 0 && decimals == 2) snprintf(text, 8, "-.%02d", magnitude);
    else snprintf(text, 8, "%s%d.%0*d", number < 0 ? "-" : "", magnitude / factor,
                  decimals, magnitude % factor);
}

ELRSCrsfCore::ELRSCrsfCore()
{
    const ELRSInputAxisProfile defaultProfile = elrsDefaultInputAxisProfile();

    for(int i = 0; i < 16; i++) {
        _channels[i] = CRSF_CHANNEL_MID;
    }

    for(int i = 0; i < ELRS_GIMBAL_AXIS_COUNT; i++) {
        _rawAxes[i] = 1024;
        _stableAxes[i] = 1024;
        _axisCal[i].minimum = 0;
        _axisCal[i].center = 1024;
        _axisCal[i].maximum = 2047;
        _axisProfiles[i] = defaultProfile;
    }
    _inputRouting = elrsDefaultGimbalRouting();

    memset(_overlayText, 0, sizeof(_overlayText));
    memset(_commOverlayText, 0, sizeof(_commOverlayText));
    memset(_moduleName, 0, sizeof(_moduleName));
}

bool ELRSCrsfCore::begin(ELRSCrsfHost &host, const ELRSCrsfCoreConfig &config, unsigned long now)
{
    return begin(host, config, now, host.microsNow());
}

bool ELRSCrsfCore::begin(ELRSCrsfHost &host, const ELRSCrsfCoreConfig &config, unsigned long now, unsigned long nowUs)
{
    _config = config;
    _timeTravelArmed = _timeTravelActive = _timeTravelLights = false;
    if(!elrsIsValidLogicConfig(_config.logic) || !elrsIsValidMixConfig(_config.mixes)) {
        _config.logic = {};
        _config.mixes = {};
    }
    if(!elrsIsValidDisplayConfig(_config.displayConfig)) _config.displayConfig = elrsDefaultDisplayConfig();
    if(!elrsIsValidVehicleConfig(_config.vehicleConfig)) _config.vehicleConfig = elrsDefaultVehicleConfig();
    elrsSanitizeInputRouting(_config.inputRouting, _config.switchRouting);
    if(!elrsIsValidTimeTravelConfig(_config.timeTravel, _config.inputRouting, _config.mixes)) _config.timeTravel = {};
    for(uint8_t &action : _config.localActions) {
        if(action > 1) action = 0;
    }
    if(_config.adcHysteresis > ELRS_INPUT_TOLERANCE_MAX) _config.adcHysteresis = ELRS_INPUT_TOLERANCE_MAX;
    if(_config.throttleIdleDeadband > ELRS_INPUT_TOLERANCE_MAX) _config.throttleIdleDeadband = ELRS_INPUT_TOLERANCE_MAX;
    _logHost = &host;
    _config.transport.packetRateHz = elrsPacketRateOrDefault(_config.transport.packetRateHz);
    _config.speedDisplayUnits = elrsSpeedUnitsOrDefault(_config.speedDisplayUnits);
    if(!elrsIsValidRadioPreferences(_config.radio)) return false;
    _radioPreferences = _config.radio;
    for(int i = 0; i < ELRS_GIMBAL_AXIS_COUNT; i++) {
        _axisProfiles[i] = elrsSanitizeInputAxisProfile(_config.axisProfiles[i]);
        _config.axisProfiles[i] = _axisProfiles[i];
        _config.outputLimits[i] = elrsSanitizeOutputLimits(_config.outputLimits[i]);
    }
    _inputRouting = _config.inputRouting;
    _transport = ELRSCrsfTransport();
    _transport.setSink(this);

    _startedAt = now;
    _selfTestUntil = 0;
    _lastAxisAttemptAt = 0;
    _lastGoodAxesAt = 0;
    _lastGoodPackAt = 0;
    _lastDisplay = 0;
    _lastTelemetry = 0;
    _lastLinkStats = 0;
    _lastGpsSpeed = 0;
    _lastAirspeed = 0;
    _lastBattery = 0;
    _lastRpm = 0;
    _rpm = 0;
    _haveRpm = false;
    _batteryBlinkAt = 0;
    _batteryBannerAt = 0;
    _overlayUntil = 0;
    _commOverlayUntil = 0;
    _linkQuality = 0;
    _remoteBattery = 0;
    _remoteBatteryVoltage = 0.0f;
    _remoteCurrent10 = 0;
    _remoteCapacity = 0;
    _gpsAltitude = 0;
    _gpsHeading100 = 0;
    _gpsSatellites = 0;
    _rxRssi = 0;
    _rxSnr = 0;
    _faultFlags = ELRS_FAULT_NONE;
    _gpsSpeed10 = 0;
    _airspeed10 = 0;
    _activeSpeedSource = SPEED_SOURCE_NONE;
    _haveAds = false;
    _haveStableAxes = false;
    _haveGoodAxes = false;
    _throttleReady = false;
    _axisSweepActive = false;
    _fakePowerOn = false;
    _selfTestActive = false;
    _hasValidPackState = false;
    _haveLinkStats = false;
    _haveGpsSpeed = false;
    _haveAirspeed = false;
    _haveBattery = false;
    _receivedFamilies = 0;
    _lastDisplaySource = 255;
    _lastPackStates = 0;
    _localInputsInitialized = 0;
    _localNeedsRelease = 0;
    _adcFaultActive = false;
    _buttonPackFaultActive = false;
    _lastCommCode = ELRS_COMM_NONE;
    _lastReplyActive = false;
    _calibRaw = false;
    _calibPressed = false;
    _calibLongSent = false;
    _calibDebounceAt = 0;
    _calibPressedAt = 0;
    _calStage = CAL_IDLE;
    _calCaptureStage = CAL_IDLE;
    _calCapturePending = false;
    _calCaptureRequestedAt = 0;
    memset(_overlayText, 0, sizeof(_overlayText));
    memset(_commOverlayText, 0, sizeof(_commOverlayText));
    memset(_moduleName, 0, sizeof(_moduleName));
    resetModuleConfigSession();
    _deviceConfig.reset();
    _moduleConfigPending = true;
    _moduleConfigState = MODULECFG_WAIT_START;
    _moduleConfigNextAt = now + CRSF_MODULE_CONFIG_START_DELAY_MS;
    _moduleConfigDeadlineAt = 0;

    host.loadCalibration(_axisCal, ELRS_GIMBAL_AXIS_COUNT);

    log(host, "ELRS/CRSF: basic external module mode");
    log(host, "ELRS/CRSF: full ELRS Lua/config menu unsupported");
    log(host, "ELRS/CRSF: TX=GPIO2 RX=GPIO34 OE=GPIO0");
    logf(host, "ELRS/CRSF: packet rate %uHz (module must match externally)", (unsigned)_config.transport.packetRateHz);
    logf(host, "ELRS/CRSF: desired Telem Ratio=%s Max Power=%s%s Dynamic=%s",
         _radioPreferences.telemetry,
         _radioPreferences.maxPower.label, _radioPreferences.maxPower.unit,
         _radioPreferences.dynamic);
    logf(host,
         "ELRS/CRSF: gimbals Aileron CH%u Elevator CH%u Throttle CH%u Rudder CH%u; all inputs configurable on CH1-CH16",
         (unsigned)_inputRouting.aileronChannel,
         (unsigned)_inputRouting.elevatorChannel,
         (unsigned)_inputRouting.throttleChannel,
         (unsigned)_inputRouting.rudderChannel);
#ifdef REMOTE_DBG
    for(int i = 0; i < ELRS_GIMBAL_AXIS_COUNT; i++) {
        logf(host, "ELRS/CRSF A%d calibration: low=%d center=%d high=%d reverse=%u", i,
             _axisProfiles[i].minimum, _axisProfiles[i].center, _axisProfiles[i].maximum,
             (unsigned)_axisProfiles[i].reverse);
    }
    logf(host, "ELRS/CRSF ADC tolerance=%u throttle idle=%u", (unsigned)_config.adcHysteresis, (unsigned)_config.throttleIdleDeadband);
#endif

    sampleAxes(host, now, true);

    for(int i = 0; i < 16; i++) {
        _channels[i] = CRSF_CHANNEL_MID;
    }

    _fakePowerOn = host.readFakePowerSwitch();
    if(!_config.propControls) {
        applyIdleOutputs(host, _fakePowerOn);
        host.setStopLed(false);
    }

    updateChannels(now, _fakePowerOn, host.readStopSwitch(), host.readButtonA(), host.readButtonB(), samplePackStates(host, now));
    if(!_config.propControls) {
        updateLocalSwitches(host, (_lastPackStates << 4) | (host.readButtonB() << 3) |
                           (host.readButtonA() << 2) | (_fakePowerOn << 1) | host.readStopSwitch());
    }

    _transport.begin(host, _config.transport, now, nowUs);

    showOverlay("ELR", now, 1000);
    if(!_haveAds) {
        _faultFlags |= ELRS_FAULT_ADC_MISSING;
        _adcFaultActive = true;
        updateChannels(now, _fakePowerOn, host.readStopSwitch(), host.readButtonA(), host.readButtonB(), _lastPackStates);
        log(host, "ELRS/CRSF: ADC missing");
        showOverlay("ADC", now, 1000);
    }
    updateInputFaults(host, now);

    return true;
}

void ELRSCrsfCore::loop(ELRSCrsfHost &host, unsigned long now, int battWarn)
{
    loop(host, now, host.microsNow(), battWarn);
}

void ELRSCrsfCore::loop(ELRSCrsfHost &host, unsigned long now, unsigned long nowUs, int battWarn)
{
    bool fakePower = host.readFakePowerSwitch();
    bool stopOn = host.readStopSwitch();
    bool buttonAOn = host.readButtonA();
    bool buttonBOn = host.readButtonB();
    uint8_t packStates = samplePackStates(host, now);

    _fakePowerOn = fakePower;
    if(!_config.propControls) host.setStopLed(stopOn);

    if(_calCapturePending && (fakePower || _selfTestActive || _config.propControls || battWarn)) {
        _calCapturePending = false;
    }
    if(_calCapturePending && (uint32_t)(now - _calCaptureRequestedAt) > CRSF_INPUT_STALE_MS) {
        _calCapturePending = false;
        showOverlay("ADC", now, 1000);
    }
    const bool sampleAfterTx = _transport.txTimeRemainingUs((uint32_t)host.microsNow()) == 0;
    const ELRSAxesResult axesResult = sampleAxes(host, now);
    now = host.millisNow();
    if(axesResult == ELRS_AXES_READY && _calCapturePending) finishCalibrationCapture(host, now);
    updateInputFaults(host, now);

    if(_selfTestActive && (int32_t)(now - _selfTestUntil) >= 0) {
        stopSelfTest();
        log(host, "ELRS/CRSF: self-test stopped");
    }

    if(!_selfTestActive && !_config.propControls) {
        updateCalibrationButton(host, now, battWarn);
    }

    updateTimeTravel(host, now);
    updateChannels(now, fakePower, stopOn, buttonAOn, buttonBOn, packStates);
#ifdef REMOTE_DBG
    static unsigned long lastMapLogAt = 0;
    if(now - lastMapLogAt >= 200) {
        lastMapLogAt = now;
        logf(host,
             "ELRS/CRSF map: raw=[%d,%d,%d,%d] adc=[%d,%d,%d,%d] ch1=%u ch2=%u ch3=%u ch4=%u faults=0x%02X",
             _rawAxes[0], _rawAxes[1], _rawAxes[2], _rawAxes[3],
             _stableAxes[0], _stableAxes[1], _stableAxes[2], _stableAxes[3],
             (unsigned)_channels[0], (unsigned)_channels[1],
             (unsigned)_channels[2], (unsigned)_channels[3],
             (unsigned)_faultFlags);
    }
#endif
    _transport.setChannels(_channels);
    _transport.loop(host, now, nowUs);
    now = host.millisNow();
    // Overdue RC slots must release time for ADC work instead of starving every sweep.
    if(sampleAfterTx && axesResult != ELRS_AXES_READY) {
        const ELRSAxesResult result = sampleAxes(host, now);
        now = host.millisNow();
        if(result == ELRS_AXES_READY && _calCapturePending) finishCalibrationCapture(host, now);
        updateInputFaults(host, now);
        updateChannels(now, fakePower, stopOn, buttonAOn, buttonBOn, packStates);
        _transport.setChannels(_channels);
    }
    if(!_config.propControls) {
        updateLocalSwitches(host, (packStates << 4) | (buttonBOn << 3) |
                           (buttonAOn << 2) | (fakePower << 1) | stopOn);
    }

    // Module config runs after the transport loop; service frames queued here
    // are transmitted on the next scheduler pass.
    if(!_deviceConfig.busy()) updateModuleConfig(host, now);
    _deviceConfig.tick(_transport, configSafety((uint32_t)now), (uint32_t)now);

    if(!_config.propControls) updateBatteryWarning(host, now, battWarn, fakePower);
    updateBenchState(host, now);
    if(!_config.propControls) updateDisplay(host, now, battWarn);
}

void ELRSCrsfCore::startSelfTest(unsigned long now, unsigned long durationMs)
{
    _calCapturePending = false;
    _selfTestActive = true;
    _selfTestUntil = now + durationMs;
}

void ELRSCrsfCore::updateLocalSwitches(ELRSCrsfHost &host, uint16_t states)
{
    uint16_t validMask = 0x000f;
    if(_localPackSampleValid) validMask |= 0x0ff0;
    _localInputsInitialized &= validMask;
    // A held input must be released after startup, stale reads or calibration/self-test.
    _localNeedsRelease = (_localNeedsRelease & states) | (states & validMask & ~_localInputsInitialized);
    _localInputsInitialized |= validMask;
    if(_selfTestActive || isCalibrating()) {
        _localNeedsRelease |= states;
        validMask = 0;
    }
    for(int i = 0; i < ELRS_SWITCH_INPUT_COUNT; i++) {
        if(!_config.localActions[i]) validMask &= ~(1 << i);
    }
    host.scanLocalSwitches(states, validMask & ~_localNeedsRelease);
}

void ELRSCrsfCore::stopSelfTest()
{
    _selfTestActive = false;
    _selfTestUntil = 0;
}

bool ELRSCrsfCore::selfTestActive() const
{
    return _selfTestActive;
}

bool ELRSCrsfCore::isCalibrating() const
{
    return (_calStage != CAL_IDLE) || _calCapturePending;
}

bool ELRSCrsfCore::throttleReady() const
{
    return _throttleReady && _logHost && !adcFaultActive(_logHost->millisNow());
}

bool ELRSCrsfCore::fakePowerOn() const
{
    return _fakePowerOn;
}

uint32_t ELRSCrsfCore::baudRate() const
{
    return _transport.status().baudRate;
}

uint16_t ELRSCrsfCore::channelAt(uint8_t index) const
{
    return (index < 16) ? _channels[index] : 0;
}

bool ELRSCrsfCore::readFilteredAxes(int16_t axes[ELRS_GIMBAL_AXIS_COUNT]) const
{
    if(!axes || !_haveStableAxes || !_haveGoodAxes || !_logHost ||
       (uint32_t)(_logHost->millisNow() - _lastGoodAxesAt) > CRSF_INPUT_STALE_MS) return false;
    memcpy(axes, _stableAxes, sizeof(_stableAxes));
    return true;
}

uint8_t ELRSCrsfCore::linkQuality() const
{
    return _linkQuality;
}

uint8_t ELRSCrsfCore::remoteBatteryPercent() const
{
    return _remoteBattery;
}

float ELRSCrsfCore::remoteBatteryVoltage() const
{
    return _remoteBatteryVoltage;
}

uint16_t ELRSCrsfCore::gpsSpeed10() const
{
    return _gpsSpeed10;
}

uint16_t ELRSCrsfCore::airspeed10() const
{
    return _airspeed10;
}

ELRSTelemetrySample ELRSCrsfCore::telemetrySample(uint8_t source, uint32_t now, const ELRSVehicleConfig *vehicleConfig) const
{
    ELRSTelemetrySample sample = {source, 0, false, false, UINT32_MAX};
    if(source == ELRS_DISPLAY_AUTO) {
        const uint8_t candidates[] = {ELRS_DISPLAY_GPS_SPEED, ELRS_DISPLAY_AIRSPEED, ELRS_DISPLAY_LINK_QUALITY};
        for(uint8_t candidate : candidates) {
            const ELRSTelemetrySample next = telemetrySample(candidate, now);
            if(next.available) return next;
        }
        return sample;
    }
    uint32_t receivedAt = 0;
    bool fresh = false;
    if(source == ELRS_DISPLAY_GPS_SPEED || (source >= ELRS_DISPLAY_GPS_ALTITUDE && source <= ELRS_DISPLAY_SATELLITES)) {
        sample.received = (_receivedFamilies & 1) != 0;
        fresh = _haveGpsSpeed;
        receivedAt = _lastGpsSpeed;
    } else if(source == ELRS_DISPLAY_AIRSPEED) {
        sample.received = (_receivedFamilies & 2) != 0;
        fresh = _haveAirspeed;
        receivedAt = _lastAirspeed;
    } else if(source >= ELRS_DISPLAY_BATTERY_VOLTAGE && source <= ELRS_DISPLAY_CAPACITY) {
        sample.received = (_receivedFamilies & 4) != 0;
        fresh = _haveBattery;
        receivedAt = _lastBattery;
    } else if(source >= ELRS_DISPLAY_LINK_QUALITY && source <= ELRS_DISPLAY_SNR) {
        sample.received = (_receivedFamilies & 8) != 0;
        fresh = _haveLinkStats;
        receivedAt = _lastLinkStats;
    }
    if(source == ELRS_DISPLAY_RPM_ACTUAL_MPH || source == ELRS_DISPLAY_RPM_SCALED_MPH) {
        sample.received = (_receivedFamilies & 16) != 0;
        fresh = _haveRpm;
        receivedAt = _lastRpm;
    }
    if(!sample.received) return sample;
    sample.ageMs = now - receivedAt;
    const uint32_t timeout = source == ELRS_DISPLAY_RPM_ACTUAL_MPH || source == ELRS_DISPLAY_RPM_SCALED_MPH ?
        CRSF_RPM_TIMEOUT_MS : _config.transport.telemetryTimeoutMs;
    if(!fresh || sample.ageMs >= timeout) return sample;
    switch(source) {
    case ELRS_DISPLAY_RPM_ACTUAL_MPH: case ELRS_DISPLAY_RPM_SCALED_MPH: {
        const ELRSVehicleConfig &vehicle = vehicleConfig ? *vehicleConfig : _config.vehicleConfig;
        if(!elrsIsValidVehicleConfig(vehicle)) return sample;
        const float polePairs = vehicle.rpmType == ELRS_RPM_ELECTRICAL ? vehicle.motorPoles * 0.5f : 1.0f;
        sample.value = std::fabs((float)_rpm) * 3.14159265f * vehicle.tireDiameterMm * 60.0f /
            (polePairs * vehicle.gearRatio * 1609344.0f);
        if(source == ELRS_DISPLAY_RPM_SCALED_MPH) sample.value *= vehicle.scaleFactor;
        break;
    }
    case ELRS_DISPLAY_GPS_SPEED: sample.value = _gpsSpeed10 * 0.1f; break;
    case ELRS_DISPLAY_AIRSPEED: sample.value = _airspeed10 * 0.1f; break;
    case ELRS_DISPLAY_BATTERY_VOLTAGE: sample.value = _remoteBatteryVoltage; break;
    case ELRS_DISPLAY_BATTERY_CURRENT: sample.value = _remoteCurrent10 * 0.1f; break;
    case ELRS_DISPLAY_BATTERY_PERCENT: if(_remoteBattery > 100) return sample; sample.value = _remoteBattery; break;
    case ELRS_DISPLAY_CAPACITY: sample.value = _remoteCapacity; break;
    case ELRS_DISPLAY_GPS_ALTITUDE: sample.value = _gpsAltitude; break;
    case ELRS_DISPLAY_GPS_HEADING: if(_gpsHeading100 > 36000) return sample; sample.value = _gpsHeading100 * 0.01f; break;
    case ELRS_DISPLAY_SATELLITES: sample.value = _gpsSatellites; break;
    case ELRS_DISPLAY_LINK_QUALITY: if(_linkQuality > 100) return sample; sample.value = _linkQuality; break;
    case ELRS_DISPLAY_RSSI: sample.value = -(int)_rxRssi; break;
    case ELRS_DISPLAY_SNR: sample.value = _rxSnr; break;
    default: return sample;
    }
    sample.available = true;
    return sample;
}

bool ELRSCrsfCore::telemetryDisplayAssigned() const
{
    return _config.displayConfig.source != ELRS_DISPLAY_NONE;
}

void ELRSCrsfCore::renderAssignedDisplay(ELRSCrsfHost &host, uint32_t now, int battWarn)
{
    if(telemetryDisplayAssigned()) updateDisplay(host, now, battWarn);
}

bool ELRSCrsfCore::telemetryActive() const
{
    return _transport.status().telemetryActive;
}

bool ELRSCrsfCore::replyActive() const
{
    return _transport.status().replyActive;
}

bool ELRSCrsfCore::synced() const
{
    return _transport.status().synced;
}

ELRSCrsfCore::SpeedSource ELRSCrsfCore::activeSpeedSource() const
{
    return _activeSpeedSource;
}

ELRSCrsfStatus ELRSCrsfCore::getStatus() const
{
    const ELRSCrsfTransportStatus &transportStatus = _transport.status();
    ELRSCrsfStatus status;

    status.baudRate = transportStatus.baudRate;
    status.packetRateHz = transportStatus.packetRateHz;
    status.telemetryActive = transportStatus.telemetryActive;
    status.replyActive = transportStatus.replyActive;
    status.synced = transportStatus.synced;
    status.activeSpeedSource = (uint8_t)_activeSpeedSource;
    status.linkQuality = _linkQuality;
    status.remoteBatteryPercent = _remoteBattery;
    status.remoteBatteryVoltage = _remoteBatteryVoltage;
    status.faultFlags = _faultFlags;
    status.commCode = transportStatus.commCode;
    status.everReplied = transportStatus.everReplied;
    status.everSynced = transportStatus.everSynced;
    status.invertLine = transportStatus.invertLine;
    status.debugEnabled = transportStatus.debugEnabled;
    status.rawFrameDebugEnabled = transportStatus.rawFrameDebugEnabled;
    status.lastTxAt = transportStatus.lastTxAt;
    status.lastReplyAt = transportStatus.lastReplyAt;
    status.lastRxAt = transportStatus.lastRxAt;
    status.lastReplyTimeoutAt = transportStatus.lastReplyTimeoutAt;
    status.lastRawFrameSyncByte = transportStatus.lastRawFrame.syncByte;
    status.lastRawFrameType = transportStatus.lastRawFrame.type;
    status.lastRawFrameLength = transportStatus.lastRawFrame.length;
    status.lastRawFrameCrcValid = transportStatus.lastRawFrame.crcValid;
    status.fakePowerOn = _fakePowerOn;
    status.calibrating = (_calStage != CAL_IDLE);
    status.selfTestActive = _selfTestActive;
    strncpy(status.moduleName, _moduleName, sizeof(status.moduleName) - 1);
    status.moduleName[sizeof(status.moduleName) - 1] = 0;

    return status;
}

bool ELRSCrsfCore::setRadioPreferences(const ELRSRadioPreferences &preferences, uint32_t now, bool radioReviewPending, bool scheduleApply)
{
    if(!elrsIsValidRadioPreferences(preferences)) return false;
    _radioPreferences = preferences;
    _radioReviewPending = radioReviewPending;
    if(scheduleApply) startModuleConfigSession(now); else pauseModuleConfigSession();
    return true;
}

ELRSAxesResult ELRSCrsfCore::sampleAxes(ELRSCrsfHost &host, unsigned long now, bool force)
{
    int16_t axes[ELRS_GIMBAL_AXIS_COUNT];
    uint32_t completedAt = 0;
    ELRSAxesRequest request = ELRS_AXES_POLL;
    if(force || (!_axisSweepActive && (uint32_t)(now - _lastAxisAttemptAt) >= axisSampleIntervalMs(_config.transport.packetRateHz))) {
        request = force ? ELRS_AXES_RESTART : ELRS_AXES_START;
        _axisSweepActive = true;
        _lastAxisAttemptAt = now;
    }
    const ELRSAxesResult result = host.sampleAxes(axes, completedAt, request,
        _transport.txTimeRemainingUs((uint32_t)host.microsNow()));
    if(result == ELRS_AXES_PENDING) {
        _haveAds = true;
        return result;
    }
    _axisSweepActive = false;
    if(result == ELRS_AXES_ERROR) {
        _haveStableAxes = false;
        _throttleReady = false;
        if(_calCapturePending) {
            _calCapturePending = false;
            showOverlay("ADC", host.millisNow(), 1000);
        }
        return result;
    }

    if(_haveGoodAxes && (uint32_t)(completedAt - _lastGoodAxesAt) > CRSF_INPUT_STALE_MS)
        _throttleReady = false;
    for(int i = 0; i < ELRS_GIMBAL_AXIS_COUNT; i++) {
        _rawAxes[i] = axes[i];
        const ELRSInputAxisProfile &profile = _axisProfiles[i];
        int16_t low = (profile.minimum < profile.maximum) ? profile.minimum : profile.maximum;
        int16_t high = (profile.minimum > profile.maximum) ? profile.minimum : profile.maximum;
        int delta = (int)axes[i] - _stableAxes[i];
        const int16_t incomingUs = (i == AXIS_THROTTLE)
            ? elrsInputModelThrottleToUs(profile, axes[i], _config.throttleIdleDeadband)
            : elrsInputModelAxisToUs(profile, axes[i]);
        bool boundaryChanged = axes[i] <= low || axes[i] >= high || incomingUs == ELRS_INPUT_US_MID ||
            (i == AXIS_THROTTLE && incomingUs == ELRS_INPUT_US_MIN);
        if(_haveStableAxes && boundaryChanged) {
            const int16_t heldUs = (i == AXIS_THROTTLE)
                ? elrsInputModelThrottleToUs(profile, _stableAxes[i], _config.throttleIdleDeadband)
                : elrsInputModelAxisToUs(profile, _stableAxes[i]);
            boundaryChanged = heldUs != incomingUs;
        }
        if(!_haveStableAxes || boundaryChanged ||
           delta > (int)_config.adcHysteresis || delta < -(int)_config.adcHysteresis) {
            _stableAxes[i] = axes[i];
        }
    }
    _haveStableAxes = true;
    _haveAds = true;
    _haveGoodAxes = true;
    _lastGoodAxesAt = completedAt;

    const int16_t rawThrottle = host.rawThrottleSample();
    const int centerDelta = (int)axes[AXIS_THROTTLE] - _axisProfiles[AXIS_THROTTLE].center;
    const int rawCenterDelta = (int)rawThrottle - _axisProfiles[AXIS_THROTTLE].center;
    const int centerBand = (_config.adcHysteresis > _axisProfiles[AXIS_THROTTLE].deadband)
        ? _config.adcHysteresis : _axisProfiles[AXIS_THROTTLE].deadband;
    if(!_throttleReady && !isCalibrating() && axes[AXIS_THROTTLE] >= 0 &&
       axes[AXIS_THROTTLE] <= 2047 && rawThrottle >= 0 && rawThrottle <= 2047 &&
       centerDelta >= -centerBand && centerDelta <= centerBand &&
       rawCenterDelta >= -centerBand && rawCenterDelta <= centerBand) {
        _throttleReady = true;
    }

    return ELRS_AXES_READY;
}

uint8_t ELRSCrsfCore::samplePackStates(ELRSCrsfHost &host, unsigned long now)
{
    _localPackSampleValid = false;
    uint8_t packStates = _hasValidPackState ? _lastPackStates : 0;
    uint8_t sampledStates = 0;

    if(!_config.haveButtonPack) {
        return 0;
    }

    if(host.samplePackStates(sampledStates)) {
        _localPackSampleValid = true;
        _lastPackStates = sampledStates;
        _lastGoodPackAt = now;
        _hasValidPackState = true;
        packStates = sampledStates;
    }

    return packStates;
}

bool ELRSCrsfCore::onCrsfFrame(uint8_t syncByte, uint8_t type, const uint8_t *payload, size_t payloadLen, unsigned long now)
{
    _deviceConfig.onFrame(type, payload, payloadLen, (uint32_t)now);
    (void)syncByte;
    bool supportedTelemetry = false;
    // ponytail: first reading from the latest RPM source; add source/index selection for multiple motors.
    bool haveRpm = false;
    int32_t rpm = 0;

    switch(type) {
    case CRSF_FRAME_LINK_STATS:
        if(payloadLen >= 10) {
            _linkQuality = payload[2];
            _rxRssi = payload[0];
            _rxSnr = (int8_t)payload[3];
            _lastLinkStats = now;
            _haveLinkStats = true;
            _receivedFamilies |= 8;
            supportedTelemetry = true;
        }
        break;
    case CRSF_FRAME_BATTERY:
        if(payloadLen >= 8) {
            _remoteBatteryVoltage = (float)readBE16(payload) * 0.1f;
            _remoteBattery = payload[7];
            _remoteCurrent10 = readBE16(payload + 2);
            _remoteCapacity = ((uint32_t)payload[4] << 16) | ((uint32_t)payload[5] << 8) | payload[6];
            _lastBattery = now;
            _haveBattery = true;
            _receivedFamilies |= 4;
            supportedTelemetry = true;
        }
        break;
    case CRSF_FRAME_GPS:
        if(payloadLen >= 15) {
            _gpsSpeed10 = readBE16(payload + 8);
            _gpsHeading100 = readBE16(payload + 10);
            _gpsAltitude = (int32_t)readBE16(payload + 12) - 1000;
            _gpsSatellites = payload[14];
            _lastGpsSpeed = now;
            _haveGpsSpeed = true;
            _receivedFamilies |= 1;
            supportedTelemetry = true;
        }
        break;
    case CRSF_FRAME_AIRSPEED:
        if(payloadLen >= 2) {
            _airspeed10 = readBE16(payload);
            _lastAirspeed = now;
            _haveAirspeed = true;
            _receivedFamilies |= 2;
            supportedTelemetry = true;
        }
        break;
    case CRSF_FRAME_RPM:
        // SRXL2, Scorpion, HoTT and CRSF inputs all use this frame, with different source IDs.
        if(payloadLen >= 4) {
            const uint32_t raw = (uint32_t)payload[1] << 16 | (uint32_t)payload[2] << 8 | payload[3];
            rpm = (raw & 0x800000) ? (int32_t)raw - 0x1000000 : (int32_t)raw;
            haveRpm = true; // Use the first RPM reading; ignore other readings and extension bytes.
        }
        break;
    case CRSF_FRAME_ARDUPILOT: {
        // ELRS MAVLink RPM uses ArduPilot passthrough app ID 0x500A, not CRSF 0x0C.
        const uint8_t *items = nullptr;
        size_t count = 0;
        if(payloadLen >= 7 && payload[0] == 0xF0) { items = payload + 1; count = 1; }
        else if(payloadLen >= 8 && payload[0] == 0xF2 && payload[1] != 0 && payloadLen == 2U + payload[1] * 6U) {
            items = payload + 2; count = payload[1];
        }
        for(size_t i = 0; i < count; i++, items += 6) {
            if(items[0] != 0x0A || items[1] != 0x50) continue;
            const uint16_t raw = (uint16_t)items[2] | (uint16_t)items[3] << 8;
            rpm = ((raw & 0x8000) ? (int32_t)raw - 0x10000 : (int32_t)raw) * 10;
            haveRpm = true;
            break;
        }
        break;
    }
    case CRSF_FRAME_DEVICE_INFO:
        handleDeviceInfo(payload, payloadLen, now);
        break;
    case CRSF_FRAME_PARAMETER_SETTINGS_ENTRY:
        if(_deviceConfig.status().id == UINT32_MAX && _deviceConfig.status().state == ELRSOperationState::Complete &&
           _moduleConfigState == MODULECFG_WAIT_PARAMETER) {
            const auto *view = _deviceConfig.parameter();
            if(view && view->device == 0xEE && view->field == _moduleFieldIndex)
                finishParameterChunk(view->field, view->data, view->dataLength, now);
        }
        break;
    default:
        break;
    }

    if(haveRpm) {
        _rpm = rpm;
        _lastRpm = now;
        _haveRpm = true;
        _receivedFamilies |= 16;
        supportedTelemetry = true;
    }
    if(supportedTelemetry) {
        _lastTelemetry = now;
    }

    return supportedTelemetry;
}

void ELRSCrsfCore::updateCalibrationButton(ELRSCrsfHost &host, unsigned long now, int battWarn)
{
    bool raw = host.readCalibrationButton();

    if(raw != _calibRaw) {
        _calibRaw = raw;
        _calibDebounceAt = now;
    }

    if((uint32_t)(now - _calibDebounceAt) < 50) {
        return;
    }

    if(raw != _calibPressed) {
        _calibPressed = raw;
        if(raw) {
            _calibPressedAt = now;
            _calibLongSent = false;
        } else if(!_calibLongSent) {
            handleCalibrationShort(host, now, battWarn);
        }
    }

    if(_calibPressed && !_calibLongSent && ((uint32_t)(now - _calibPressedAt) >= 2000)) {
        _calibLongSent = true;
        handleCalibrationLong(host, now, battWarn);
    }
}

void ELRSCrsfCore::handleCalibrationShort(ELRSCrsfHost &host, unsigned long now, int battWarn)
{
    if(_fakePowerOn || _selfTestActive) {
        return;
    }

    if(battWarn) {
        showOverlay("BAT", now, BATTERY_BANNER_DURATION);
        return;
    }

    if(_calStage == CAL_IDLE) {
        return;
    }

    requestCalibrationCapture(host, now);
}

void ELRSCrsfCore::requestCalibrationCapture(ELRSCrsfHost &host, unsigned long now)
{
    if(_calCapturePending) return;
    _throttleReady = false;
    _calCaptureStage = _calStage;
    _calCaptureRequestedAt = (uint32_t)now;
    _calCapturePending = true;
    if(sampleAxes(host, now, true) == ELRS_AXES_READY) finishCalibrationCapture(host, host.millisNow());
}

void ELRSCrsfCore::finishCalibrationCapture(ELRSCrsfHost &host, unsigned long now)
{
    if(!_calCapturePending) return;
    _calCapturePending = false;
    if(_calStage != _calCaptureStage || _fakePowerOn || _selfTestActive ||
       (uint32_t)(now - _calCaptureRequestedAt) > CRSF_INPUT_STALE_MS) return;
    if(_calStage == CAL_IDLE) {
        _calStage = CAL_CENTER;
        return;
    }
    switch(_calStage) {
    case CAL_CENTER:
        for(int i = 0; i < ELRS_GIMBAL_AXIS_COUNT; i++) {
            _axisCal[i].center = _rawAxes[i];
        }
        _calStage = CAL_TLOW;
        break;
    case CAL_TLOW:
        _axisCal[AXIS_THROTTLE].minimum = _rawAxes[AXIS_THROTTLE];
        _calStage = CAL_THIGH;
        break;
    case CAL_THIGH:
        _axisCal[AXIS_THROTTLE].maximum = _rawAxes[AXIS_THROTTLE];
        _calStage = CAL_YLOW;
        break;
    case CAL_YLOW:
        _axisCal[AXIS_RUDDER].minimum = _rawAxes[AXIS_RUDDER];
        _calStage = CAL_YHIGH;
        break;
    case CAL_YHIGH:
        _axisCal[AXIS_RUDDER].maximum = _rawAxes[AXIS_RUDDER];
        _calStage = CAL_PLOW;
        break;
    case CAL_PLOW:
        _axisCal[AXIS_ELEVATOR].minimum = _rawAxes[AXIS_ELEVATOR];
        _calStage = CAL_PHIGH;
        break;
    case CAL_PHIGH:
        _axisCal[AXIS_ELEVATOR].maximum = _rawAxes[AXIS_ELEVATOR];
        _calStage = CAL_RLOW;
        break;
    case CAL_RLOW:
        _axisCal[AXIS_AILERON].minimum = _rawAxes[AXIS_AILERON];
        _calStage = CAL_RHIGH;
        break;
    case CAL_RHIGH:
        _axisCal[AXIS_AILERON].maximum = _rawAxes[AXIS_AILERON];
        _calStage = CAL_IDLE;
        for(int i = 0; i < ELRS_GIMBAL_AXIS_COUNT; i++) {
            ELRSInputAxisProfile profile = _axisProfiles[i];
            profile.minimum = _axisCal[i].minimum;
            profile.center = _axisCal[i].center;
            profile.maximum = _axisCal[i].maximum;
            if(!elrsIsValidInputAxisProfile(profile)) {
                showOverlay("ERR", now, 1000);
                return;
            }
        }
        if(!host.saveCalibration(_axisCal, ELRS_GIMBAL_AXIS_COUNT)) {
            showOverlay("ERR", now, 1000);
            return;
        }
        for(int i = 0; i < ELRS_GIMBAL_AXIS_COUNT; i++) {
            _axisProfiles[i].minimum = _axisCal[i].minimum;
            _axisProfiles[i].center = _axisCal[i].center;
            _axisProfiles[i].maximum = _axisCal[i].maximum;
            _stableAxes[i] = _rawAxes[i];
        }
        showOverlay("CAL", now, 1000);
        break;
    default:
        _calStage = CAL_IDLE;
        break;
    }
}

void ELRSCrsfCore::handleCalibrationLong(ELRSCrsfHost &host, unsigned long now, int battWarn)
{
    if(_fakePowerOn || _selfTestActive) {
        return;
    }

    if(battWarn) {
        showOverlay("BAT", now, BATTERY_BANNER_DURATION);
        return;
    }

    if(_calStage == CAL_IDLE && !_calCapturePending) {
        requestCalibrationCapture(host, now);
    } else {
        _calCapturePending = false;
        _calStage = CAL_IDLE;
        showOverlay("CAN", now, 1000);
    }
}

const char *ELRSCrsfCore::getCalibrationPrompt() const
{
    switch(_calStage) {
    case CAL_CENTER: return "CEN";
    case CAL_TLOW:   return "TLO";
    case CAL_THIGH:  return "THI";
    case CAL_YLOW:   return "YLO";
    case CAL_YHIGH:  return "YHI";
    case CAL_PLOW:   return "PLO";
    case CAL_PHIGH:  return "PHI";
    case CAL_RLOW:   return "RLO";
    case CAL_RHIGH:  return "RHI";
    default:         return "";
    }
}

void ELRSCrsfCore::updateTimeTravel(ELRSCrsfHost &host, unsigned long now)
{
    _timeTravelLights = false;
    if(!_config.timeTravel.enabled || _selfTestActive || isCalibrating() || _configMaintenance || _radioReviewPending) {
        if(_timeTravelActive) host.requestTimeTravelSound(false);
        _timeTravelArmed = _timeTravelActive = false;
        return;
    }
    if(_timeTravelActive) {
        _timeTravelLights = host.timeTravelSoundPlaying();
        if(host.timeTravelSoundPending() || _timeTravelLights) return;
        _timeTravelActive = false;
    }
    const ELRSDisplayConfig display = elrsEffectiveDisplayConfig(_config.displayConfig, _config.propControls);
    float speed;
    if(display.source == ELRS_DISPLAY_NONE && _config.propControls) {
        speed = host.propSpeed();
    } else {
        const ELRSTelemetrySample sample = telemetrySample(display.source, now);
        if(!sample.available) return;
        if(sample.source != ELRS_DISPLAY_GPS_SPEED && sample.source != ELRS_DISPLAY_AIRSPEED &&
           sample.source != ELRS_DISPLAY_RPM_ACTUAL_MPH && sample.source != ELRS_DISPLAY_RPM_SCALED_MPH) return;
        char text[8], *end;
        elrsFormatTelemetry(display, sample, _config.speedDisplayUnits, text);
        speed = strtol(text, &end, 10);
        if(end == text) return;
    }
    if(!std::isfinite(speed)) return;
    if(speed < 88.0f) _timeTravelArmed = true;
    else if(_timeTravelArmed) {
        _timeTravelArmed = false;
        _timeTravelActive = true;
        host.requestTimeTravelSound(true);
    }
}

void ELRSCrsfCore::updateChannels(unsigned long now, bool fakePowerOn, bool stopOn, bool buttonAOn, bool buttonBOn, uint8_t packStates)
{
    resetChannels(CRSF_CHANNEL_MIN);
    if(_selfTestActive) {
        writeGimbalChannels(true);
        writeFixedChannelIfUnclaimed(_config.switchRouting.channels[0], CRSF_CHANNEL_MAX);
        if(_config.timeTravel.enabled) _channels[_config.timeTravel.channel - 1] = CRSF_CHANNEL_MIN;
        clampLockedThrottleOutputs();
        return;
    }

    if(adcFaultActive(now)) {
        writeGimbalChannels(true);
    } else {
        writeGimbalChannels(false);
    }

    const bool switches[] = {stopOn, fakePowerOn, buttonAOn, buttonBOn};
    for(int i = 0; i < 4; i++) {
        writeFixedChannelIfUnclaimed(_config.switchRouting.channels[i], switches[i] ? CRSF_CHANNEL_MAX : CRSF_CHANNEL_MIN);
    }

    for(int i = 0; i < 8; i++) {
        writeFixedChannelIfUnclaimed(_config.switchRouting.channels[4 + i], (packStates & (1 << i)) ? CRSF_CHANNEL_MAX : CRSF_CHANNEL_MIN);
    }
    applyMixes(now, (uint16_t)(stopOn | (fakePowerOn << 1) | (buttonAOn << 2) |
                               (buttonBOn << 3) | ((uint16_t)packStates << 4)));
    if(_config.timeTravel.enabled && _timeTravelLights) {
        _channels[_config.timeTravel.channel - 1] = CRSF_CHANNEL_MAX;
    }
    clampLockedThrottleOutputs();
}

void ELRSCrsfCore::clampLockedThrottleOutputs()
{
    if(_throttleReady) return;
    if(_inputRouting.throttleChannel)
        _channels[_inputRouting.throttleChannel - 1] = CRSF_CHANNEL_MID;
    for(const auto &line : _config.mixes.lines) {
        if(line.channel >= 1 && line.channel <= 16 && line.source == AXIS_THROTTLE + 1)
            _channels[line.channel - 1] = CRSF_CHANNEL_MID;
    }
}

void ELRSCrsfCore::resetChannels(uint16_t defaultTicks)
{
    for(int i = 0; i < 16; i++) {
        _channels[i] = defaultTicks;
    }
}

void ELRSCrsfCore::writeGimbalChannels(bool safeOutputs)
{
    writeGimbalChannel(_inputRouting.aileronChannel, safeOutputs ? CRSF_CHANNEL_MID : axisToTicks(AXIS_AILERON));
    writeGimbalChannel(_inputRouting.elevatorChannel, safeOutputs ? CRSF_CHANNEL_MID : axisToTicks(AXIS_ELEVATOR));
    writeGimbalChannel(_inputRouting.throttleChannel, (safeOutputs || !_throttleReady) ? CRSF_CHANNEL_MID : axisToTicks(AXIS_THROTTLE));
    writeGimbalChannel(_inputRouting.rudderChannel, safeOutputs ? CRSF_CHANNEL_MID : axisToTicks(AXIS_RUDDER));
}

void ELRSCrsfCore::writeGimbalChannel(uint8_t channel, uint16_t ticks)
{
    if(channel >= 1 && channel <= 16) {
        _channels[channel - 1] = ticks;
    }
}

void ELRSCrsfCore::writeFixedChannelIfUnclaimed(uint8_t channel, uint16_t ticks)
{
    if(channel >= 1 && channel <= 16 && !channelClaimedByGimbal(channel)) {
        _channels[channel - 1] = ticks;
    }
}

bool ELRSCrsfCore::channelClaimedByGimbal(uint8_t channel) const
{
    return _inputRouting.aileronChannel == channel ||
           _inputRouting.elevatorChannel == channel ||
           _inputRouting.throttleChannel == channel ||
           _inputRouting.rudderChannel == channel;
}

int16_t ELRSCrsfCore::axisToUs(uint8_t axis) const
{
    if(axis >= ELRS_GIMBAL_AXIS_COUNT) return ELRS_INPUT_US_MID;
    if(axis == AXIS_THROTTLE && !_throttleReady) return ELRS_INPUT_US_MID;
    const ELRSInputAxisProfile &profile = _axisProfiles[axis];
    return axis == AXIS_THROTTLE
        ? elrsInputModelThrottleToUs(profile, _stableAxes[axis], _config.throttleIdleDeadband)
        : elrsInputModelAxisToUs(profile, _stableAxes[axis]);
}

uint16_t ELRSCrsfCore::axisToTicks(uint8_t axis) const
{
    if(axis >= ELRS_GIMBAL_AXIS_COUNT) return CRSF_CHANNEL_MID;
    return elrsInputUsToCrsfTicks(elrsApplyOutputLimits(_config.outputLimits[axis], axisToUs(axis)));
}
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
