CircuitSetup/Remote/(commit log)

2024-10-12 Support Battery Level Meter (CB 1.5)
2024-11-08 Fix disabling of auto-throttle
    [remote_main.cpp]
2024-11-13 Add audio notifications; longer calibration delay
2024-12-20 1.02: Add battery monitoring
2025-01-13 1.03
    - Fix MQTT message length
    - BTTFN code optimizations
    [display.cpp, display.h, input.cpp, input.h, power.cpp, power.h, remote_audio.cpp, remote_click.h]
2025-01-26 1.14
    - Show battery charge level at cold boot (if available)
    - minor audio optim.
2025-09-16 1.06
    - Add uploading mp3 files to SD card through Config Portal
    - WiFiManager patches to reduce size and memory fragmentation
    - WiFiManager fixes and additions
    [remote_global.h, remote_main.cpp, remote_settings.cpp, remote_settings.h, remote_wifi.cpp]
2025-09-20 1.07
    - Allow multiple mp3 files to be uploaded at once, plus better error handling
    - WiFi Manager code reductions
    [remote_global.h, remote_main.cpp, remote_settings.cpp, remote_settings.h, remote_wifi.cpp]
2025-09-23 1.08
    - Fix TCD hostname length field
    - Config Portal: Re-order settings; remove non-checkbox-code
    - Config Portal: Add "install sound pack" banner to main menu
    - Remove HAVE_AUDIO conditional
    [remote_audio.cpp, remote_global.h, remote_main.cpp, remote_settings.cpp, remote_settings.h, remote_wifi.cpp]
2025-10-05 1.09
    - WiFi Manager overhaul; many changes to Config Portal
    - Save static IP only if changed
    - Disable MQTT when connected to "TCD-AP"
    - Various code optimizations to minimize code size and used RAM
    - Let DNS server in AP mode only resolve our domain (hostname)
    [remote_audio.cpp, remote_global.h, remote_main.cpp, remote_settings.cpp, remote_settings.h, remote_wifi.cpp]
2025-10-07 1.10
    - WM fixes (Upload, etc)
    - Add "No SD present" banner in Config Portal if no SD present
    - CP: Show msg instead of upload file input if no sd card is present
    [remote_global.h, remote_settings.cpp, remote_wifi.cpp]
2025-10-14 1.10.2
    - Fix regression in CP ("show password")
    - WM: Do not garble UTF8 SSID; skip SSIDs with non-printable characters
    - Config Portal: Minor restyling (message boxes)
    [remote_global.h, remote_wifi.cpp]
2025-10-18 1.11
    - WM: More event-based waiting instead of delays; number of scanned networks listed is now restricted in order not to run out of memory.
    - Wipe flash FS if alien VER found; in case no VER is present, check available space for audio files, and wipe if not enough.
    - Minor code optim (settings)
2025-10-23 1.11.1
    - Reverse Enable/disable click sound commands for uniformity
    - HAVE_VOL_ROTENC compile-time option for RotEnc/Volume support (off in official builds)
    [input.cpp, input.h, remote_global.h, remote_main.cpp, remote_settings.cpp]
2025-10-25 1.11.2
    - Add WiFi power saving for AP-mode, and user-triggered WiFi connect retry. Fake power off, then on to 1) restart WiFi after entering PS mode, 2) trigger a connection attempt if configured WiFi could not be connected to during boot.
    - WM: Fix AP shutdown; handle MDNS
    [remote_global.h, remote_main.cpp, remote_settings.cpp, remote_settings.h, remote_wifi.cpp]
2025-10-26 1.11.3
    - BTTFN: Fix hostname length issues; code optimizations; minor fix for mc notifications. Breaks support for TCD firmwares < 3.2. Recommend to update all props' firmwares for similar fixes.
    [remote_global.h, remote_main.cpp]
2025-10-28 1.11.4
    - Make reactivation of AP after power-save and reconnection attempts on Fake Power optional.
    - Fix display of current power saving timer value in CP
    [remote_global.h, remote_main.cpp, remote_settings.cpp, remote_settings.h, remote_wifi.cpp]
2025-11-03 1.12
    - Add "Remote fake power controls TCD fake power" feature. Requires TCD firmware >= 3.8.
    - Play sound when taking over/releasing TCD fake-power control
    - New sound pack (RM07)
    - Add CP option to use O.O/RESET (when fake power is off) to either control brightness (as before) or take over/release TCD Fake-Power control
    - Move HA/MQTT settings to separate page in Config Portal
    - Allow coasting to be toggled by TCD command (7063)
    - Tweak coasting and deceleration curves
    - Do not change bri/vol on first press, just display/show
    - No calibration when battery is low
    - WM: Generate HTML for checkboxes on-the-fly
    - Fix deleting a bad .bin file after upload
    - Remove volume settings fr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
    [display.cpp, remote_audio.cpp, remote_global.h, remote_main.cpp, remote_settings.cpp, remote_settings.h, remote_wifi.cpp]
2025-11-14 1.13
    - Remove BTTFN_MC conditional
    - Move Music Player init into main_setup()
    - Allow using TCD command codes 7xxx with MQTT-INJECT command
    - Block BTTFN/MQTT commands while busy
    - Finish stand-alone TT (count-up version)
    - Cancel tcdIsInP0 if networkAbort
    - Skip button actions while TTrunning or tcdIsInP0
    - New sound pack (RM08)
    - Add stand-alone time-travel sequence; triggered through O.O + throttle up or hitting 88 through throttle-up when not connected to a TCD.
    - Support "stalled P0" (TCD 3.9)
    - Fixes for MQTT inter-prop communication; add support for MQTT TIMETRAVEL command with variable lead (TCD 3.9)
    - Add BTTFN_NOT_BUSY support (TCD 3.9)
    - Allocate MQTT buffer only if MQ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
    [display.cpp, display.h, input.cpp, input.h, mqtt.cpp, remote_audio.cpp, remote_click.h, remote_global.h]
2025-12-01 1.14
    - New sound pack (RM09): Re-do some sounds, add new
    - Make TCD<->Remote communication more robust
    - Add internal command to react on brake-prohibited TT on behalf of the TCD
    - Signal TCD when we want speed even when off
    - TCD-controlled TT: If brake is hit while accelerating, TT is aborted
    - Fix IP & SOC not being displayed while fake-off
    - WM: Minor HTML tweaks; make page width dynamic for better display on handheld devices
    - Add support for MQTT v5.0 (tested with mosquitto only). Has no advantages over 3.1.1 (but more overhead)
    - Add MQTT connection state info on HA/MQTT Settings page
    - If remote controlling is not allowed by the TCD, the Remote, unlike the other props, does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
    [mqtt.cpp, remote_audio.cpp, remote_global.h, remote_main.cpp, remote_settings.cpp, remote_settings.h, remote_wifi.cpp]
2026-01-09 1.15
    - P0: Don't jump to TCD speed if it's lower than our currently displayed one, instead wait until TCD caught up.
    - Issue a brake warning if brake is on when throttle-up TT should be triggered.
    - New sound-pack (RM10)
    - BTTFN enhancements in sync with TCD capabilities
    - Code refinements
    [display.cpp, display.h, input.cpp, input.h, mqtt.cpp, power.cpp, power.h, remote_audio.cpp]
2026-01-09 1.16
    - BTTFN: Fall back to DISCOVER upon NOT_DATA timeout. TCD might have got a new IP address.
    - BTTFN: Fix re-connection after a TCD-reboot.
    [remote_global.h, remote_main.cpp]
2026-03-22 Add basic ELRS/CRSF external module mode
    Add an `elrs_crsf` control mode for using an external ExpressLRS module
    over the CRSF data pin.
    This adds a custom CRSF transport, ADS1015-based 4-axis gimbal input,
    channel mapping for switches and the button pack, persisted ELRS axis
    calibration, and telemetry handling for link quality and receiver-
    reported speed on the segment display.
    Legacy mode remains the default, battery monitoring stays local-only,
    and the Config Portal now exposes the control mode selection.
2026-03-23 Add CRSF errors for ELRS mode
    Add transient 3-digit display error codes for CRSF communication problems
    in ELRS mode.
    This adds ELRS comm-state tracking for baud fallback, no-sync after
    fallback, telemetry loss after prior sync, repeated bad CRC frames, and
    repeated malformed frame/resync events. Those states are exposed through
    the ELRS status struct and shown on the segment display as `FAL`, `NSY`,
    `LOS`, `CRC`, and `FRM` using the existing overlay path.
    The display driver is unchanged, and higher-priority overlays such as
    battery warnings, calibration prompts, ADC faults, and button-pack faults
    still take precedence over CRSF comm overlays.
    Host-side software tests were expanded to cov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
    [elrs_crsf_core.cpp, elrs_crsf_core.h, test_native_elrs.cpp]
2026-03-23 ELRS/CRSF shared-line transport
    Extract the CRSF UART/OE handling into a dedicated transport layer and
    keep the ELRS core focused on control mapping and telemetry behavior.
    This switches the module link to fixed 400000 8N1 board defaults, makes
    half-duplex line driving explicit, adds reply-timeout/raw-frame tracking
    and parser resync in the transport, and updates the host tests to cover
    the new behavior.
    [elrs_crsf.cpp, elrs_crsf.h, elrs_crsf_core.cpp, elrs_crsf_core.h, elrs_crsf_transport.cpp, elrs_crsf_transport.h, test_native_elrs.cpp]
2026-03-23 interoperability hardening
    The transport now uses exact microsecond packet-rate scheduling for 50/100/150/250 Hz, defaults to 250 Hz, keeps RC TX cadence independent of missing replies, distinguishes replyActive from telemetryActive, accepts CRSF sync/address bytes beyond just 0xC8, and softens the no-reply diagnostics to NRY/RLS instead of treating missing replies as hard control failure.
    [elrs_crsf.cpp, elrs_crsf_core.cpp, elrs_crsf_core.h, elrs_crsf_shared.h, elrs_crsf_transport.cpp, elrs_crsf_transport.h, remote_settings.cpp, remote_settings.h]
2026-03-25 Add ELRS module options & refactor CRSF portal dropdown builders
    Add CRSF/ELRS config-portal options for, telemetry ratio,
    max power, and dynamic power, and wire them through the current CRSF
    settings/runtime path.
    This also refactors the duplicated CRSF/ELRS dropdown builder callbacks
    in remote_wifi.cpp behind one local helper
2026-03-26 1.21
    - WiFi: Allow defining a BSSID (AP MAC address) to connect to a specific AP if multiple APs with identical SSID are available.
    - MQTT: Disable if server can't be resolved
    - WiFi: Do not power down AP long as a client is connected
    - Brush up Config Portal a bit
    - Code optimizations and fixes.
    [input.cpp, input.h, remote_audio.cpp, remote_global.h, remote_main.cpp, remote_settings.cpp, remote_settings.h, remote_wifi.cpp]
2026-04-19 1.22
    - Allow assigning a button/switch to "refill Plutonium". This switch/button, when switched to ON, sends a "Refill" command to the Dash Gauges through the TCD (TCD 3.22).
    - Allow configuring RESET button to toggle auto-throttle -or- shuffle setting when held while fake power is on.
    - New sound-pack (RM11)
    - Code optimizations and fixes
    [display.cpp, display.h, input.cpp, input.h, power.cpp, power.h, remote_audio.cpp, remote_click.h]
2026-04-28 1.23
    - Add Car Mode: In addition to existing WiFi network connection settings, you can now pre-configure TCD-AP SSID and password in WiFi Settings and quickly switch between normal (home, iPhone...) WiFi connection and Car WiFi connection (through TCD-AP) by holding the Calibration button for 6 seconds (triple-beep) or through the Config Portal.
    - Behavior of Calibration button changed: Press is still a brief press. Holding the button to initiate Calibration (Fake power off), or to display IP address and battery state (Fake power on) means holding it until a double-beep sounds, then the button must be released. (Previously, the function to trigger started automatically after 2 seconds, with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
2026-05-01 add 500Hz option and fix module communication errors
    [crsf_kludge.cpp, crsf_kludge.h, elrs_crsf.cpp, elrs_crsf.h, elrs_crsf_core.cpp, elrs_crsf_core.h, elrs_crsf_shared.h, elrs_crsf_transport.cpp]
2026-05-01 docs: add adc crsf baseline validation artifacts
2026-05-01 docs: refresh adc crsf baseline artifacts
2026-05-01 docs: expand adc crsf baseline provenance note
2026-05-01 docs: pin adc crsf baseline source provenance
2026-05-01 debug: log ads1015 probe and raw axis samples
2026-05-01 tools: add crsf rc frame decoder for bench logs
2026-05-01 Revert "Merge branch 'CRSF' of https://github.com/CircuitSetup/Remote into CRSF"
    This reverts commit 63a14f8ecd220ee0a987a6b8a05e6e5e9ad12d96, reversing
    changes made to 2f9b2431382ee5cd82d4e5fd335e9b2eba7d0675.
    [crsf_kludge.cpp, crsf_kludge.h, crsf_settings.h, elrs_crsf.cpp, elrs_crsf.h, elrs_crsf_core.cpp, elrs_crsf_core.h, elrs_crsf_shared.h]
2026-05-04 Add ELRS/CRSF gimbal calibration, routing, and transport recovery
    Adds an ELRS/CRSF-only input model for calibrated gimbal output and improves module communication handling for ExpressLRS external modules.
    Changes include:
    - Add Aileron/Elevator/Rudder/Throttle input naming and default routing:
    - Aileron -> CH1
    - Elevator -> CH2
    - Throttle -> CH3
    - Rudder -> CH4
    - Add three-point raw ADC calibration so saved low/center/high values map to 1000/1500/2000 before CRSF tick conversion.
    - Support descending ADC calibration ranges and per-axis reverse handling.
    - Add configurable gimbal channel routing and reverse toggles to the web config portal.
    - Add a mobile-friendly ELRS/CRSF gimbal c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
    [crsf_kludge.cpp, crsf_kludge.h, crsf_settings.h, elrs_crsf.cpp, elrs_crsf.h, elrs_crsf_core.cpp, elrs_crsf_core.h, elrs_crsf_shared.h]
2026-05-05 calibration formatting
2026-05-06 Improve CRSF portal calibration settings
2026-08-26 1.26
    - New sound-pack (RM13)
    - Logic fix for time travel being initiated while fake-off
    - More robust error handling in case of malformed config files
    - SD: More compatibility fixes
    [remote_audio.cpp, remote_global.h, remote_main.cpp, remote_settings.cpp, remote_settings.h, remote_wifi.cpp]
2026-09-30 Show filtered ADC readings in CRSF calibration portal
2026-09-30 Fix CRSF input safety, timing, and settings persistence
    [check_crsf_adc.py, check_crsf_settings.py, crsf_kludge.h, crsf_wifi.h, elrs_crsf.cpp, elrs_crsf.h, elrs_crsf_core.cpp, elrs_crsf_transport.cpp]
2026-09-30 Stabilize CRSF channels and throttle idle with input tolerances
    [elrs_crsf.cpp, elrs_crsf.h, elrs_crsf_core.cpp, elrs_crsf_core.h, elrs_input_model.cpp, elrs_input_model.h, test_native_elrs.cpp]
2026-09-30 Expose and persist CRSF input stability adjustments
    [check_crsf_settings.py, crsf_kludge.cpp, crsf_settings.h, crsf_wifi.h, elrs_input_model.cpp, remote_settings.h, test_native_elrs.cpp]
2026-09-30 Preserve minimum throttle when entering the idle deadband
2026-10-01 Support configurable ELRS switch channel routing
2026-10-01 Configure and persist switch channels in the ELRS portal
2026-10-01 Report ELRS save failures and preserve retryable calibration
    [WiFiManager.cpp, WiFiManager.h, check_crsf_adc.py, check_crsf_settings.py, crsf_kludge.cpp, crsf_settings.h, crsf_wifi.h, elrs_crsf.cpp]
2026-10-01 Fix CRSF control gaps and stabilize portal ADC readings
    [check_crsf_adc.py, check_crsf_settings.py, crsf_wifi.h, elrs_crsf.cpp, elrs_crsf_core.cpp, elrs_crsf_core.h, elrs_crsf_transport.cpp, test_native_elrs.cpp]
2026-10-01 Fix CRSF neutral safety and enable shared channel routing
    [check_crsf_adc.py, check_crsf_settings.py, crsf_kludge.cpp, crsf_wifi.h, elrs_crsf.cpp, elrs_crsf_core.cpp, elrs_crsf_core.h, elrs_crsf_shared.h]
2026-10-02 Add configurable gimbal travel limits (#3)
    * feat: add gimbal output travel limits
    * feat: configure gimbal travel limits in ELRS portal
    * fix: preserve gimbal settings within CRSF
    * fix: validate and recover CRSF settings writes
    * fix: show fixed gimbal center as plain text
    [check_crsf_adc.py, check_crsf_settings.py, crsf_kludge.cpp, crsf_settings.h, crsf_wifi.h, elrs_crsf.cpp, elrs_crsf.h, elrs_crsf_core.cpp]
2026-10-02 Compact gimbal calibration controls into one row
2026-10-02 refactor: combine gimbal calibration curves and travel limits
2026-10-02 Reduce CRSF program and static memory usage
    Use exact 32-bit expo arithmetic with the original integer rounding,
    compile disabled firmware raw dumps and debug-only option lookups out,
    reuse the fake-power getter, and place immutable portal tables in flash.
    Keep raw debugging available through REMOTE_DBG_CRSF_RAW and preserve
    legacy mode, settings, telemetry parsing, and communication errors.
    Measured against origin/main 3d40971 with the same ESP32 toolchain:
    - Program memory: 1,278,865 -> 1,278,229 bytes (636 bytes saved).
    - Static RAM: 73,368 -> 72,728 bytes (640 bytes saved).
    Validation: release, raw-debug, and CRSF-disabled ESP32 builds pass;
    108 native checks pass with raw dumping comp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
    [check_crsf_memory.py, check_crsf_settings.py, crsf_kludge.cpp, crsf_wifi.h, elrs_crsf_core.cpp, elrs_crsf_transport.cpp, elrs_input_model.cpp, remote_global.h]
2026-10-03 Fix CRSF telemetry, rollover, retries, and input validation
    Decode GPS speed and battery voltage using CRSF wire units. Keep sensor
    validity separate from timestamps so readings at millis zero are usable
    and expired readings cannot reappear after rollover.
    Expire overlays, self-tests, and module configuration waits with signed
    timer comparisons. Ignore duplicate/out-of-order parameter chunks and
    retain continuation progress while a retry is queued.
    Reject malformed filtering parameters atomically in CRSF settings code.
    Throttle ADC motion/probe diagnostics to 200 ms when debugging is enabled,
    compile their state out of release builds, and disable serial/audio debug
    by default. Leave remote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
    [check_crsf_adc.py, check_crsf_settings.py, crsf_kludge.cpp, crsf_wifi.h, elrs_crsf.cpp, elrs_crsf.h, elrs_crsf_core.cpp, elrs_crsf_core.h]
2026-10-03 Add prop controls alongside CRSF with optional channel assignments
2026-10-04 Honor CRSF switch opt-ins in TCD control updates
2026-10-04 fix: restore prop readout on P0 telemetry handoff
    [check_crsf_display.py, check_crsf_local_actions.py, check_crsf_settings.py, crsf_wifi.h, remote_main.cpp]
2026-10-04 fix: remove obsolete telemetry display startup diagnostic
    [elrs_crsf_core.cpp]
2026-10-07 feat: derive actual and scaled mph from motor RPM
2026-10-07 ui: hide vehicle settings unless motor RPM is selected
2026-10-08 fix: accept RPM telemetry from all ELRS serial inputs
    [check_crsf_display.py, check_crsf_settings.py, crsf_kludge.cpp, crsf_wifi.h, elrs_crsf_core.cpp, elrs_crsf_shared.h, test_native_elrs.cpp]
2026-10-08 fix: advance CRSF transmit deadlines through actual I/O completion
    [elrs_crsf.cpp, elrs_crsf.h, elrs_crsf_core.cpp, elrs_crsf_transport.cpp, elrs_crsf_transport.h, test_native_elrs.cpp]
2026-10-08 fix: acquire CRSF axes incrementally with true sample freshness
    [check_crsf_adc.py, check_crsf_display.py, elrs_crsf.cpp, elrs_crsf.h, elrs_crsf_core.cpp, elrs_crsf_core.h, elrs_crsf_transport.cpp, elrs_crsf_transport.h]
2026-10-08 fix: respect busy ADC conversions and bound CRSF polling jitter
    [check_crsf_adc.py, elrs_crsf.cpp, elrs_crsf.h, elrs_crsf_transport.cpp, test_native_elrs.cpp]
2026-10-12 feat: add compact ELRS logical switch evaluator
2026-10-12 feat: integrate logical switches and mixes into CRSF outputs
2026-10-12 feat: expand ELRS logical switches and mixes to sixteen rows
2026-10-14 Fix CRSF ADC starvation and open-AP live controls
2026-10-14 Recover CRSF replies after damaged receive frames
2026-10-14 Improve CRSF filtering and live ELRS controls
2026-10-15 Clarify ELRS setting actions and edited device targets
2026-10-19 Preserve manual switches during the time travel effect
2026-10-23 Pin ESP32 builds to the Arduino 2.x toolchain
